seromedises-PoliTo/Float-Ram-main/Wiki_images/TestingApparatus_CAD.png

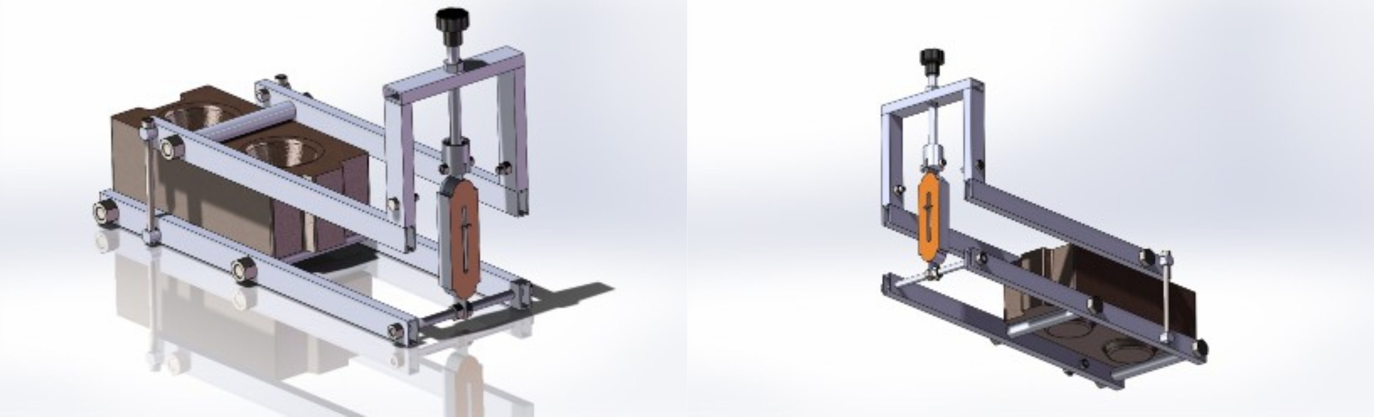
Wiki_images/TestingApparatus_CAD.png
