seromedises-PoliTo/Float-Ram-main/Wiki_images/TestingApparatus.png

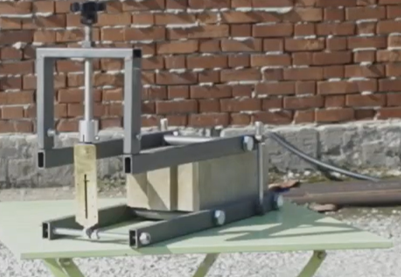
Wiki_images/TestingApparatus.png
