seromedises-PoliTo/Float-Ram-main/README.md

# Float-Ram

Float-Ram is an open-source, cost-effective, and manually operated press designed to create compressed earth block (CEB) for building construction.
