seromedises-PoliTo/Float-Ram-main/Wiki_images/BloccoMattone.png

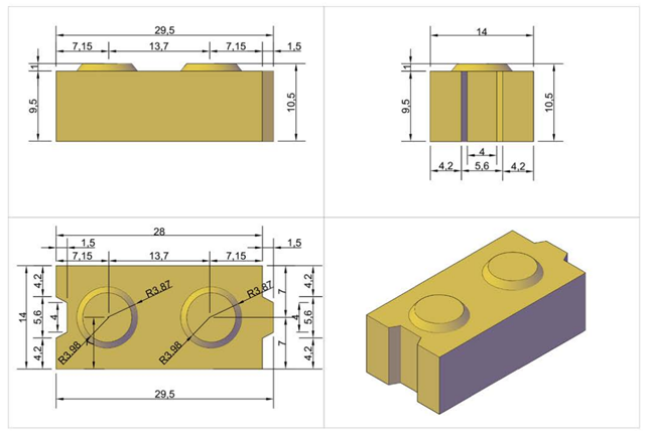
Wiki_images/BloccoMattone.png
