seromedises-PoliTo/Float-Ram-main/Wiki_images/FloatRam_CAD&Prototype.png

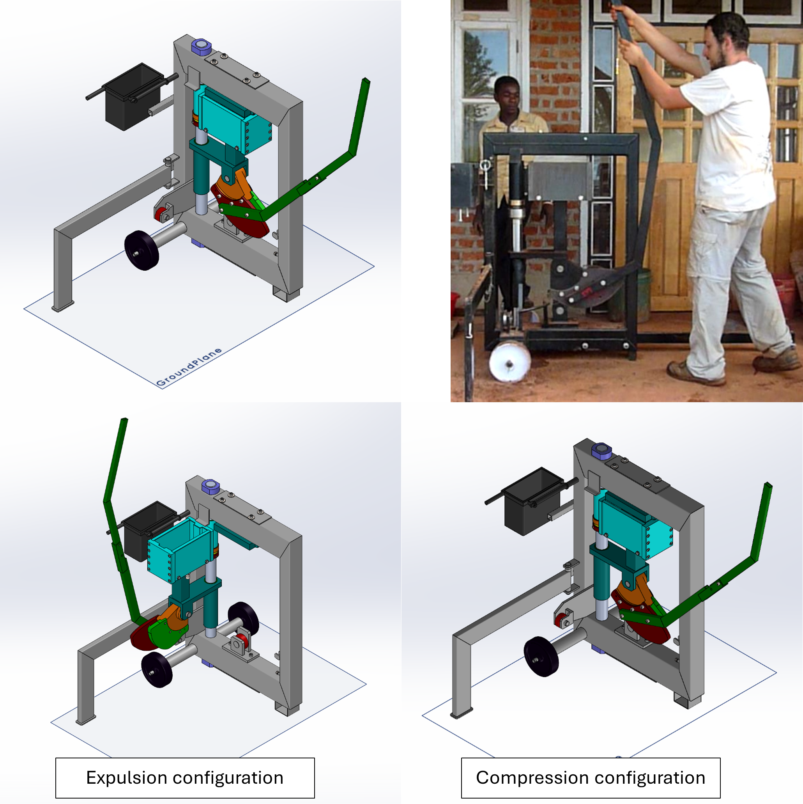
Wiki_images/FloatRam_CAD&Prototype.png
