seromedises-PoliTo/Float-Ram-main/Wiki_images/FloatRam_FloatingMold.png

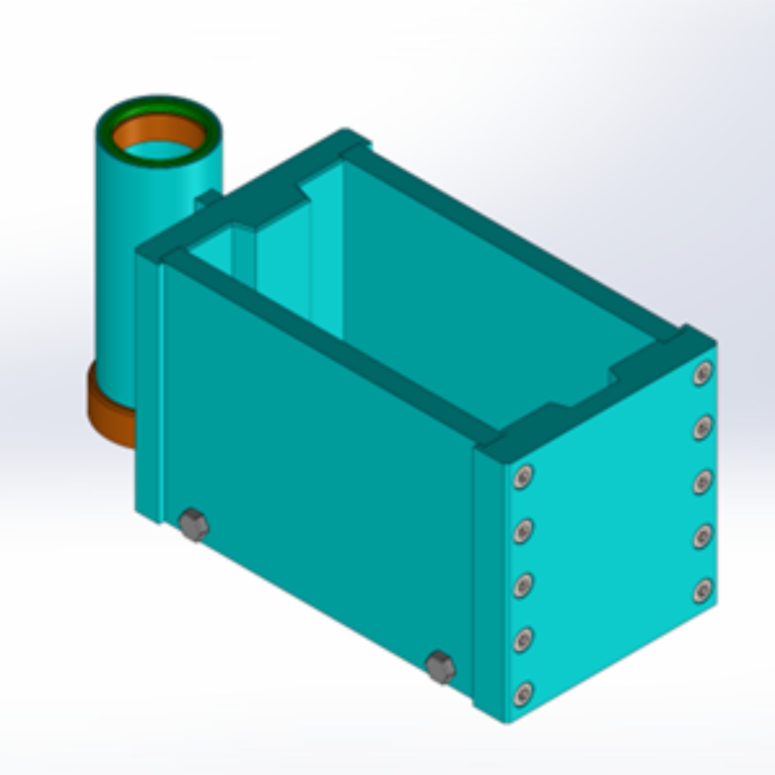
Wiki_images/FloatRam_FloatingMold.png
