seromedises-PoliTo/Float-Ram-main/Wiki_images/FloatRam_FoldedPrototype.png.jpg

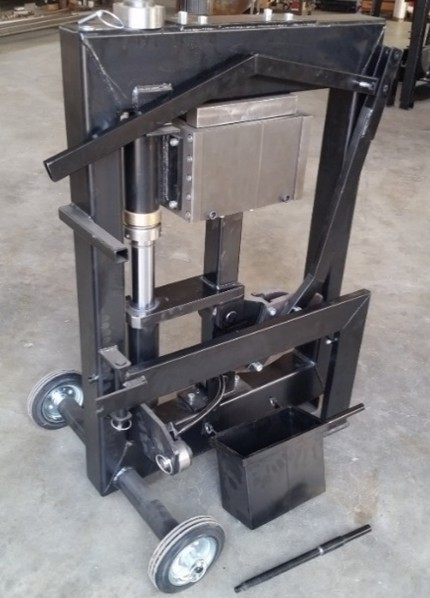
Wiki_images/FloatRam_FoldedPrototype.png.jpg
