seromedises-PoliTo/Float-Ram-main/Wiki_images/FloatRam_Frame.png

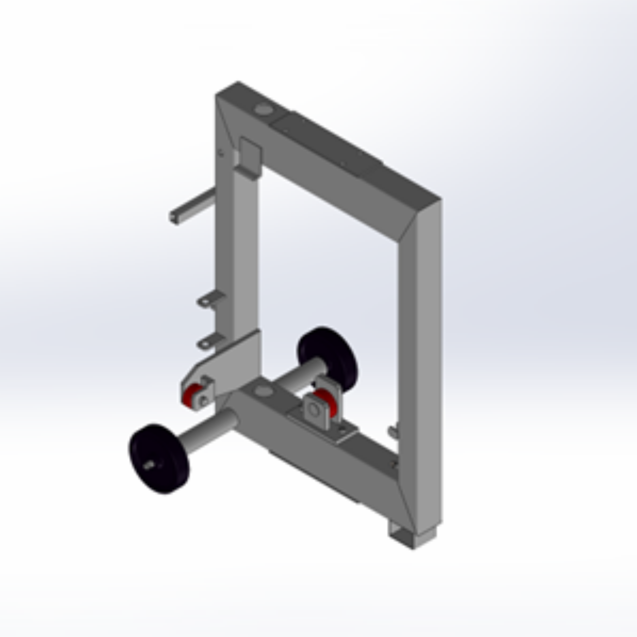
Wiki_images/FloatRam_Frame.png
