seromedises-PoliTo/Float-Ram-main/Wiki_images/FloatRam_LateralFoot.png

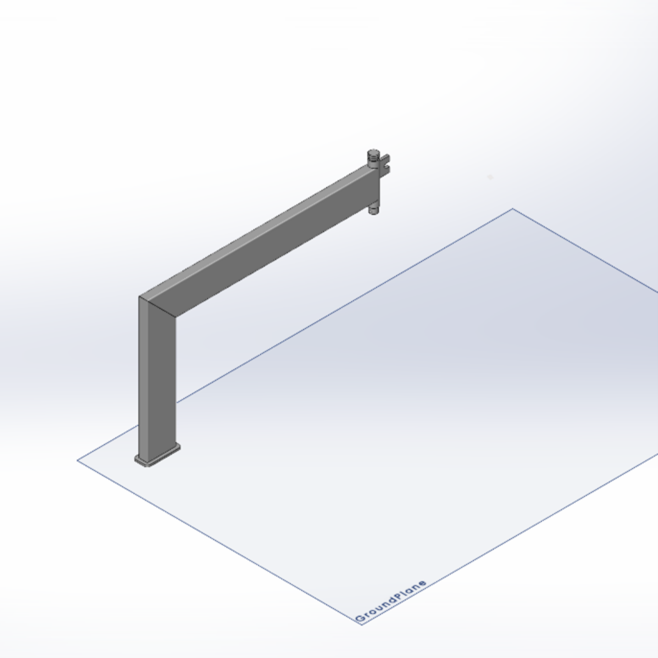
Wiki_images/FloatRam_LateralFoot.png
