seromedises-PoliTo/Float-Ram-main/Wiki_images/FloatRam_Lever&Cams.png

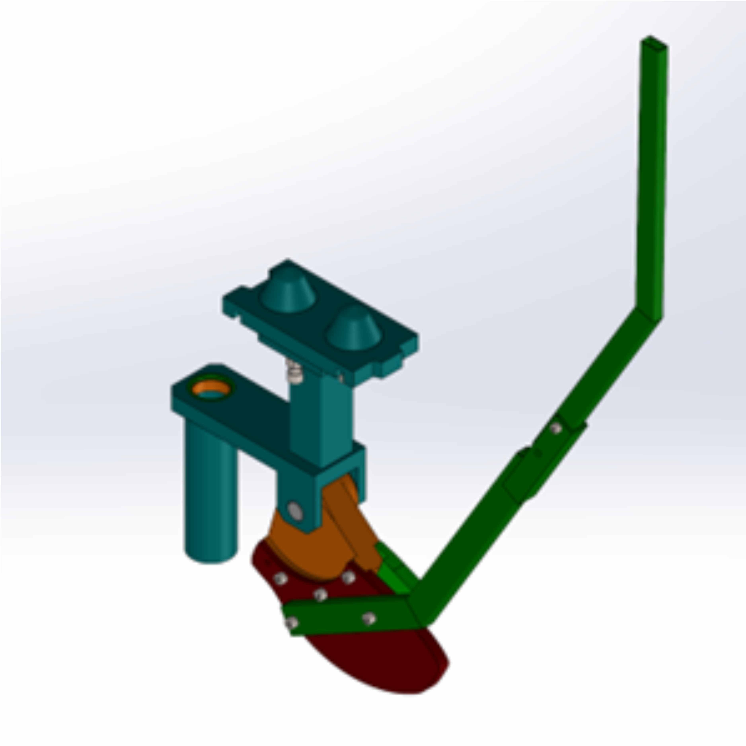
Wiki_images/FloatRam_Lever&Cams.png
