seromedises-PoliTo/Float-Ram-main/Wiki_images/FloatRam_MeteringBox.png

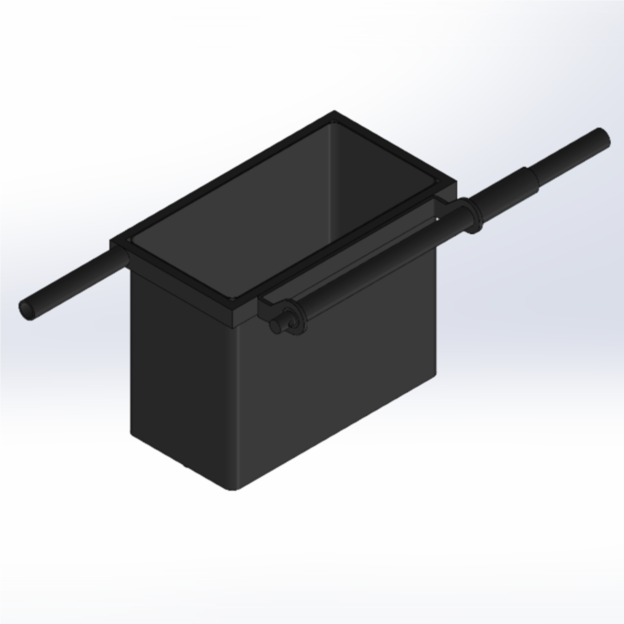
Wiki_images/FloatRam_MeteringBox.png
