seromedises-PoliTo/Float-Ram-main/Wiki_images/FloatRam_Shaft.png

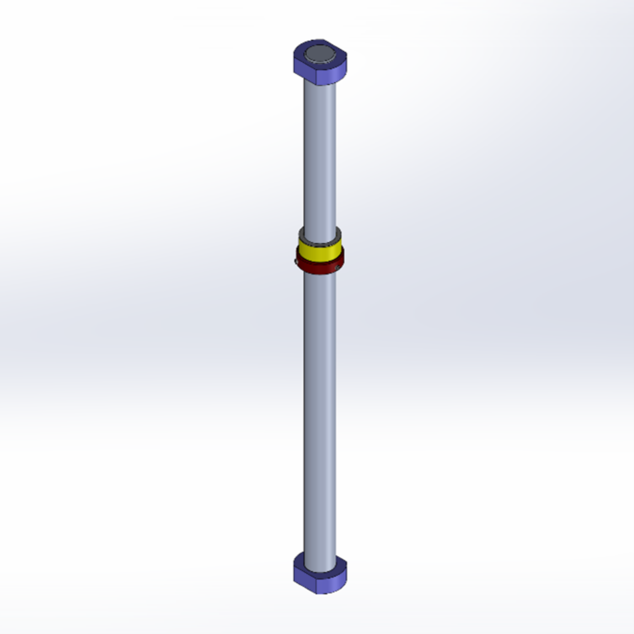
Wiki_images/FloatRam_Shaft.png
