seromedises-PoliTo/Float-Ram-main/ComponentsList.xlsx

Part Name | Part of the Sub-Assembly | Description | Suggested Manufacturing Process | Material | Quantity | Commercial or Custom | Notes
FrameLowerHorizontalProfile | Assembly_2nd_Frame | Frame bottom part | Metallic carpentry | Structural steel | 1 | Custom
FrameUpperHorizontalProfile | Assembly_2nd_Frame | Frame upper part | Metallic carpentry | Structural steel | 1 | Custom
FrameVerticalBackProfile | Assembly_2nd_Frame | Fame vertical back part | Metallic carpentry | Structural steel | 1 | Custom
FrameVerticalFrontProfile | Assembly_2nd_Frame | Frame vertical front part | Metallic carpentry | Structural steel | 1 | Custom
PressRollerSupport | Assembly_2nd_Frame | Support for the press roller | Metallic carpentry | Structural steel | 1 | Custom
Screw_M14x200 | Assembly_2nd_Frame | Screw that holds the press roller support | - | - | 2 | Commercial
Nut_M14 | Assembly_2nd_Frame | Nut to secure the screws for the press roller support | - | - | 2 | Commercial
Wheel | Assembly_2nd_Frame | Machine's wheel | - | Solid rubber + steel | 2 | Commercial | External diameter = 200mm; Shaft diameter = 20mm; Width = 50mm
WheelAxis | Assembly_2nd_Frame | Shaft of the wheel | Turning | Steel | 2 | Custom | C40 or 38NiCrMo4
ExpulsionRollerShaft | Assembly_2nd_Frame | Shaft of the expulsion roller | Turning | Steel | 1 | Custom | C40 or 38NiCrMo4
SKF_SupportRoller_NUTR_3072 | Assembly_2nd_Frame | Expulsion roller | - | - | 1 | Commercial
PressRollerShaft | Assembly_2nd_Frame | Shaft of the press roller | Turning | Steel | 1 | Custom | C40 or 38NiCrMo4
SKF_SupportRoller_NUTR_4090_A | Assembly_2nd_Frame | Press roller | - | - | 1 | Commercial
LeverLock | Assembly_2nd_Frame | Part to lock the lever in horizontal position to be used as a handle | Metallic carpentry | Steel | 1 | Custom | C40 or 38NiCrMo4
LeverLockSupport | Assembly_2nd_Frame | Part to secure the lever lock to the frame | Milling | Steel | 2 | Custom | C40 or 38NiCrMo4
ISO_4762_M8x30_screw | Assembly_2nd_Frame | Screw to secure the lever lock support to the frame | - | - | 4 | Commercial
LateralFootLockingLever | Assembly_2nd_Frame | Part to lock the lateral foot in the folded position | Sheet cutting or milling | Steel | 1 | Custom | C40 or 38NiCrMo4
DIN_EN_ISO_7040_M10_Prevailing_torque_nut | Assembly_2nd_Frame | Nut to secure the lateral foot locking lever to the frame | - | - | 1 | Commercial
Shaft | Assembly_2nd_Shaft | Cylindrical pair main shaft | Turning | Special steel | 1 | Custom | Ground and chrome-plated special steel
ShaftRingNut | Assembly_2nd_Shaft | Ring nut to secure the shaft to the frame | Turning | Inox | 2 | Custom | AISI304
ShaftAxialBlock | Assembly_2nd_Shaft | Part fixed to the shaft that support the spring | Turning | Inox | 1 | Custom | AISI304
Spring | Assembly_2nd_Shaft | Spring that supports the floating mold | - | Inox for springs | 1 | Commercial | Wire diameter = 8mm; Mean spring diameter = 72mm; External diameter = 80mm; Internal diameter = 64mm; Minimum loaded spring length = 30mm; Unloaded spring length = 75mm; Four active coils and one non-active and machiend coil at each end
SpringWasher | Assembly_2nd_Shaft | Washer to let the bushing rotate over the spring | Turning | Steel | 1 | Custom | C40 or 38NiCrMo4
ISO_4029_M10x30_set_nut | Assembly_2nd_Shaft | Set nut that secure the shaft axial block to the shaft | - | - | 3 | Commercial
FloatingMoldGuide | Assembly_2nd_FloatingMold | Part that guide the floating mold on the shaft | Turning + Metallic carpentry | Structural steel | 1 | Custom
Gasket | Assembly_2nd_FloatingMold | Typical gasket for pistons | - | - | 1 | Commercial | Intenal diameter = 60mm; External diameter = 74mm; Thickness = 8mm;
AxialRadialBushing | Assembly_2nd_FloatingMold | Axial-radial bushing that supports the floating mold guide | Turning | Bronze | 1 | Custom
RadialBushing | Assembly_2nd_FloatingMold | Radial bushing that supports the floating mold guide | Turining | Bronze | 1 | Custom
FloatingMoldBackPlate | Assembly_2nd_FloatingMold | Floating mold plate next to the shaft | Milling | Special steel | 1 | Custom | Carburized and nitrided special steel
FloatingMoldFrontPlate | Assembly_2nd_FloatingMold | Floating mold plate next to the user | Milling | Special steel | 1 | Custom | Carburized and nitrided special steel
FloatingMoldLateralPlate | Assembly_2nd_FloatingMold | Floating mold side plate | Milling | Special steel | 1 | Custom | Carburized and nitrided special steel
FloatingMoldLateralPlate | Assembly_2nd_FloatingMold | Floating mold side plate | Milling | Special steel | 1 | Custom | Carburized and nitrided special steel
ISO_8734_8x20_A_parallel_pin | Assembly_2nd_FloatingMold | Locating pin to install the mold back plate to the mold guide | - | - | 2 | Commercial
ISO_4762_M10x25_screw | Assembly_2nd_FloatingMold | Socket head cap screw to mount the floating mold | - | - | 24 | Commercial
FloatingMoldBottomScrew | Assembly_2nd_FloatingMold | Screw to lock the mold bottom plate inside the mold | Turning | Steel | 4 | Custom | C40 or 38NiCrMo4
CamFollowerMechGuide | Assembly_2nd_CamFolowerMech | Part to guide the cam assemby on the shaft | Metallic carpentry | Structural steel | 1 | Custom
RadialBushing | Assembly_2nd_CamFolowerMech | Radial bushing that supports the cam follower guide | Turining | Bronze | 2 | Custom
Gasket | Assembly_2nd_CamFolowerMech | Typical gasket for pistons | - | - | 2 | Commercial | Intenal diameter = 60mm; External diameter = 74mm; Thickness = 8mm;
CamFollowerMechShaft | Assembly_2nd_CamFolowerMech | Cam follower shaft | Turning | Steel | 1 | Custom | C40 or 38NiCrMo4
CamFollowerMechHolder | Assembly_2nd_CamFolowerMech | Part that connects the cam profiles to the cam shaft | Milling | Steel | 1 | Custom | C40 or 38NiCrMo4
SKF_SupportRoller_NUTR_35A | Assembly_2nd_CamFolowerMech | Commercial bearing used in the cam revolute joint | - | - | 2 | Commercial
CamFollowerMechBearingSpacer | Assembly_2nd_CamFolowerMech | Spacer to locate the inner part of the bearings | - | Bronze | 1 | Custom
ExpulsionCam | Assembly_2nd_CamFolowerMech | Cam profile to guide the brick expulsion | Water-jet cutting + contour milling using the parallel pin as reference | Special steel | 1 | Custom | Carburized and nitrided special steel
PressCam | Assembly_2nd_CamFolowerMech | Cam profile to guide the brick pressing | Water-jet cutting + contour milling using the parallel pin as reference | Special steel | 1 | Custom | Carburized and nitrided special steel
Lever | Assembly_2nd_CamFolowerMech | Input lever | Metallic carpentry | Structural steel | 1 | Custom | The shaft to connect the extension must be welded during the assembly
LevelExtension | Assembly_2nd_CamFolowerMech | Input lever extension (it is foldable for packaging) | Metallic carpentry | Structural steel | 1 | Custom
ISO_4762_M12x45_screw | Assembly_2nd_CamFolowerMech | Screw to secure the lever to the cam assmebly | - | - | 2 | Commercial
ISO_4762_M12x70_screw | Assembly_2nd_CamFolowerMech | Screw to secure the cam profiles to the cam holder | - | - | 3 | Commercial
ISO_4762_M10x25_screw | Assembly_2nd_CamFolowerMech | Screw to secure the mold lower plate to the cam follower guide | - | - | 4 | Commercial
ISO_4762_M16x45_screw | Assembly_2nd_CamFolowerMech | Screw to adjust the position and orientation of the lower plate | - | - | 4 | Commercial
ISO_4034_M16_nut | Assembly_2nd_CamFolowerMech | Nut to lock the adjusting screws after the regulation has been done | - | - | 4 | Commercial
ISO_4762_M10x35_screw | Assembly_2nd_CamFolowerMech | Screw to secure the lever extension in the unfolded position | - | - | 1 | Commercial
MoldLowerPlate | Assembly_3rd_MoldLowerPlate | Mold lower plate | Milling | Special steel | 1 | Custom | Carburized and nitrided special steel
MoldLowerPlateInsert | Assembly_3rd_MoldLowerPlate | Mold lower plate insert | Turning | Special steel | 2 | Custom | Carburized and nitrided special steel
ISO_4762_M10x30_screw | Assembly_3rd_MoldLowerPlate | Screw to secure the mold insert to the lower plate | - | - | 2 | Commercial
MeteringBox | Assembly_2nd_MeteringBox | Main body of the metering box | Metallic carpentry | Structural steel | 1 | Custom
MeteringBoxAdjustingScrew | Assembly_2nd_MeteringBox | Custom screw to adjust the metering box volume | Turning | Inox | 2 | Custom | AISI304
MeteringBoxHolder | Assembly_2nd_MeteringBox | Part welded to the main body that the user holds | Metallic carpentry | Structural steel | 1 | Custom
MeteringBoxJoint | Assembly_2nd_MeteringBox | Part welded to the holder to connect to the revolute joint | Metallic carpentry (sheet cutting and folding) | Structural steel | 1 | Custom
MeteringBoxLowerPlate | Assembly_2nd_MeteringBox | Bottom of the metering box | Metallic carpentry | Structural steel | 1 | Custom
MeteringBoxShaft | Assembly_2nd_MeteringBox | Shaft of the metering box revolute joint | Turning | Structural steel | 1 | Custom
MoldUpperPlate | - | Mold upper plate | Milling | Special steel | 1 | Custom | Carburized and nitrided special steel
LateralFoot | - | Lateral foot for stability during expulsion | Metallic carpentry | Structural steel | 1 | Custom
LateralFootAxis | - | Lateral foot axis to fold the lateral foot for packaging | Turning | Steel | 1 | Custom | C40 or 38NiCrMo4
M12x180_screw | - | Screw to secure the mold upper plate to the frame | - | - | 4 | Commercial
DIN_9021_M12_washer | - | Washer for the screw to secure the mold upper plate | - | - | 4 | Commercial
ISO_4762_M10x25_screw | - | Screw to secure the metering box axis to the frame | - | - | 1 | Commercial
SplintPin | - | Splint pins to axial lock of the revolute joint shafts | - | - | 7 | Commercial | Not added in CAD. For diameters: 14mm, 20mm (2x), 24mm, 26mm, 32mm, 36mm
