seromedises-PoliTo/Float-Ram-main/Float_Ram_SW2024/SKF_SupportRoller_NUTR_3072.SLDASM

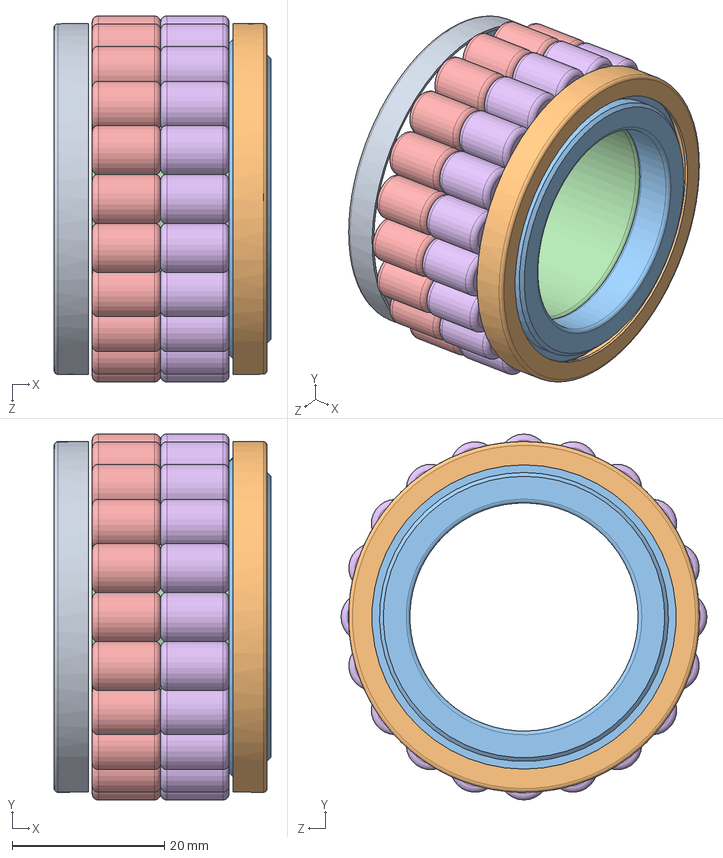
[picture p12: CAD file, 2026-06-23]
Float_Ram_SW2024/SKF_SupportRoller_NUTR_3072.SLDASM
28.5 x 48.1 x 48.1 mm
SKF_SupportRoller_NUTR_3072_0_02
SKF_SupportRoller_NUTR_3072_0_03
SKF_SupportRoller_NUTR_3072_0_04
SKF_SupportRoller_NUTR_3072_0_05
SKF_SupportRoller_NUTR_3072_0_07
SKF_SupportRoller_NUTR_3072_0_08
