seromedises-PoliTo/Float-Ram-main/Float_Ram_SW2024/Assembly_3rd_MoldLowerPlate.SLDASM

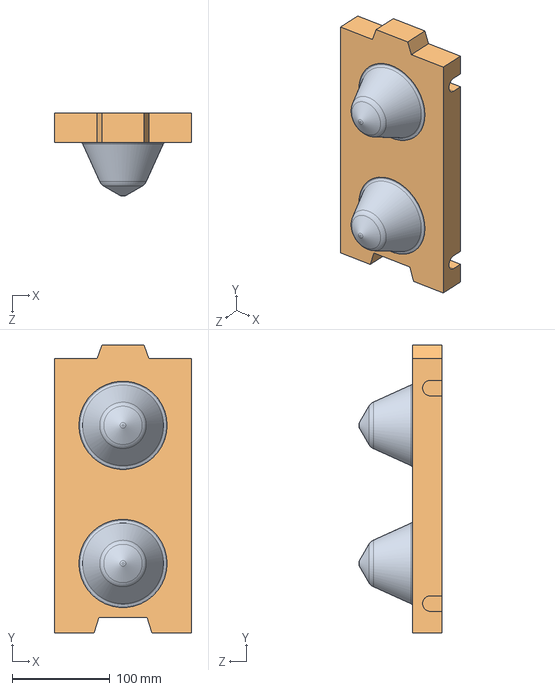
[picture p13: CAD file, 2026-06-23]
Float_Ram_SW2024/Assembly_3rd_MoldLowerPlate.SLDASM
140.0 x 294.0 x 85.0 mm
MoldLowerPlate
MoldLowerPlateInsert x 2
