seromedises-PoliTo/Float-Ram-main/Float_Ram_STEP/FloatingMoldBackPlate.STEP

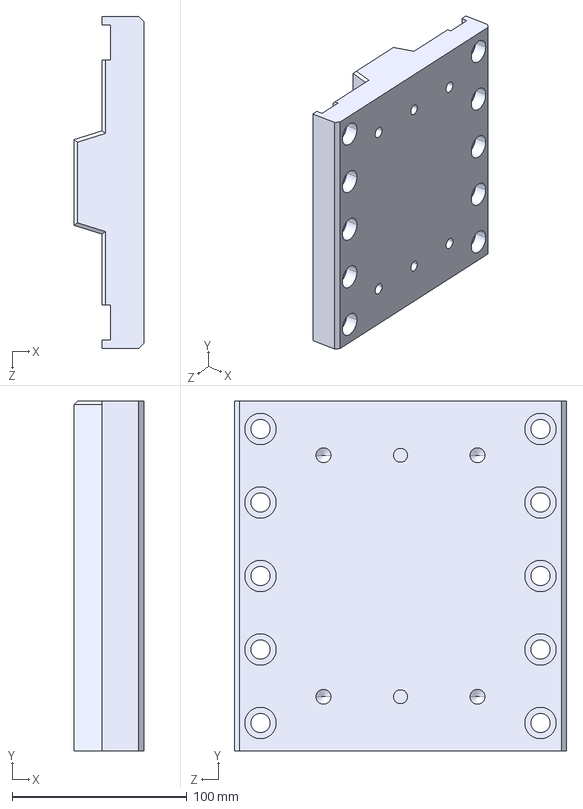
[picture p14: CAD file, 2026-06-23]
Float_Ram_STEP/FloatingMoldBackPlate.STEP
40.0 x 200.0 x 190.0 mm
