seromedises-PoliTo/Float-Ram-main/Float_Ram_SW2024/CamFollowerMechGuide.SLDPRT

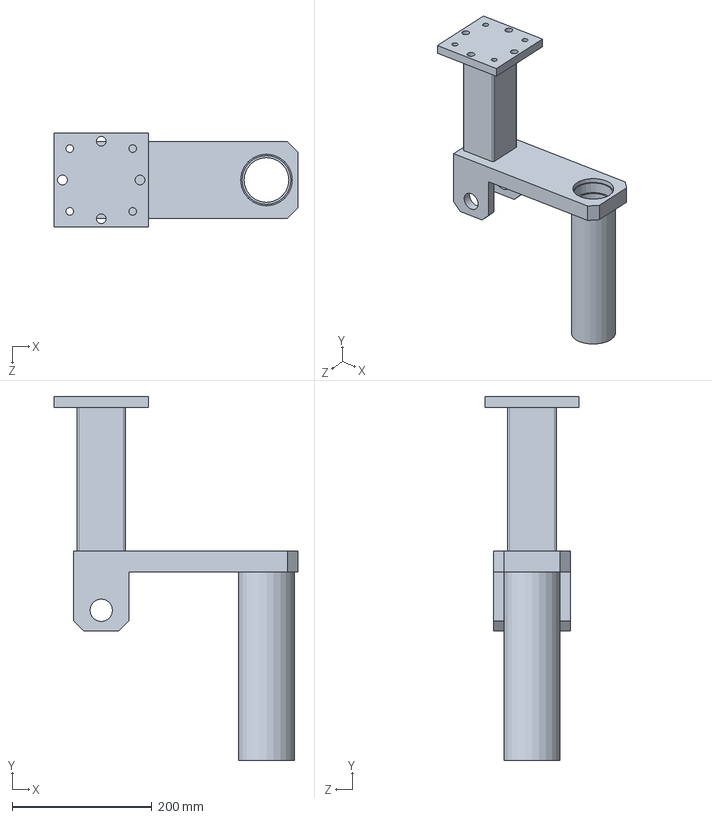
[picture p15: CAD file, 2026-06-23]
Float_Ram_SW2024/CamFollowerMechGuide.SLDPRT
349.0 x 521.0 x 135.0 mm
