seromedises-PoliTo/Float-Ram-main/Float_Ram_STEP/SKF_SupportRoller_NUTR_3072_0_07.STEP

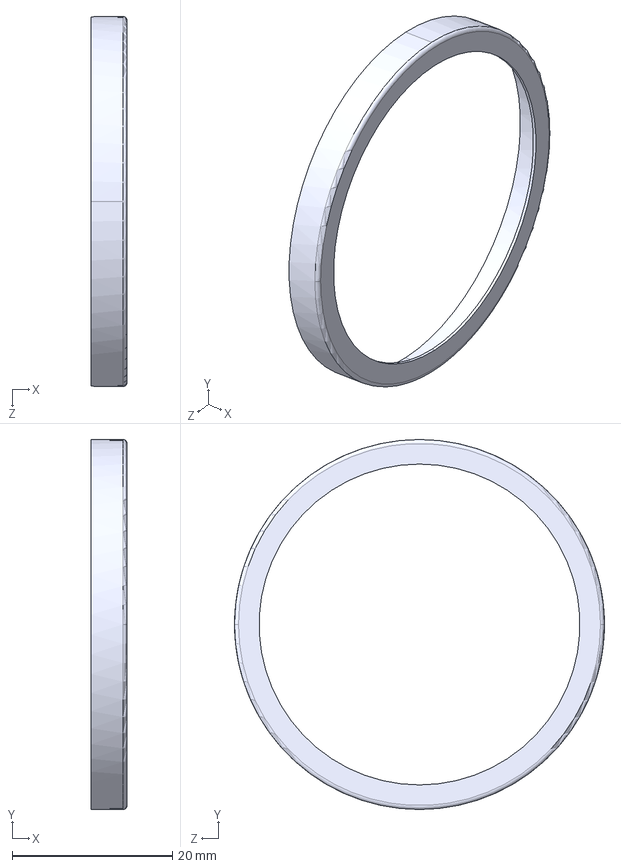
[picture p16: CAD file, 2026-06-23]
Float_Ram_STEP/SKF_SupportRoller_NUTR_3072_0_07.STEP
4.50 x 46.1 x 46.1 mm
