seromedises-PoliTo/Float-Ram-main/Float_Ram_SW2024/LevelExtension.SLDPRT

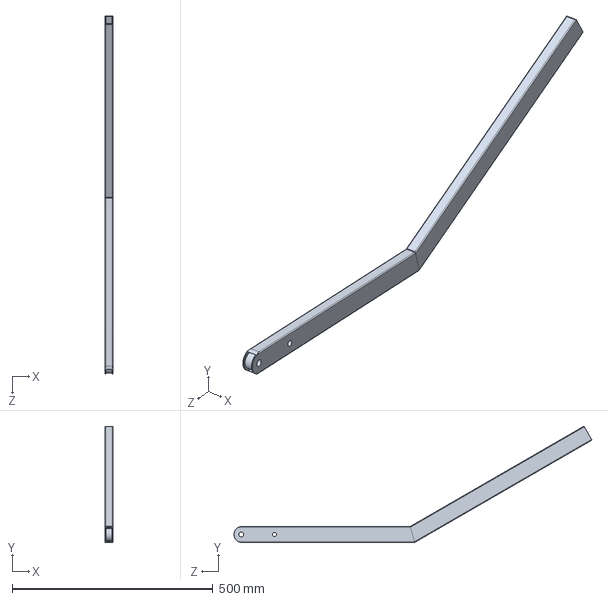
[picture p17: CAD file, 2026-06-23]
Float_Ram_SW2024/LevelExtension.SLDPRT
20.0 x 289.3 x 892.3 mm
