seromedises-PoliTo/Float-Ram-main/Float_Ram_SW2024/MoldUpperPlate.SLDPRT

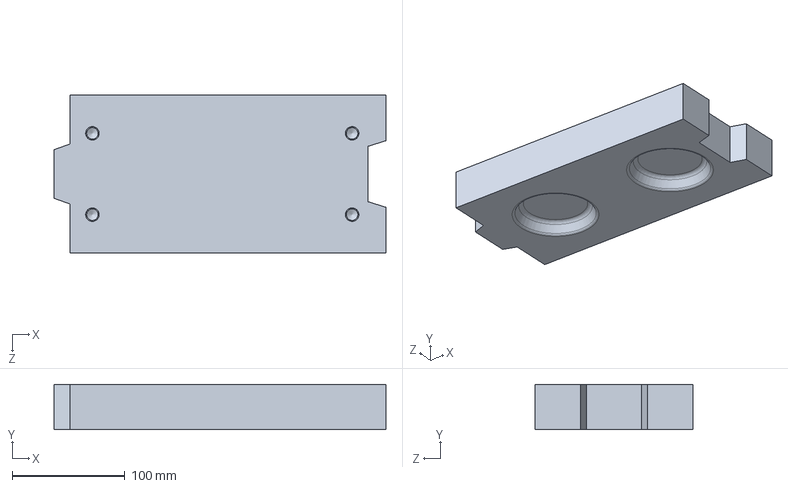
[picture p18: CAD file, 2026-06-23]
Float_Ram_SW2024/MoldUpperPlate.SLDPRT
294.0 x 40.0 x 140.0 mm
