seromedises-PoliTo/Float-Ram-main/Float_Ram_STEP/SKF_SupportRoller_NUTR_35A_0_08.STEP

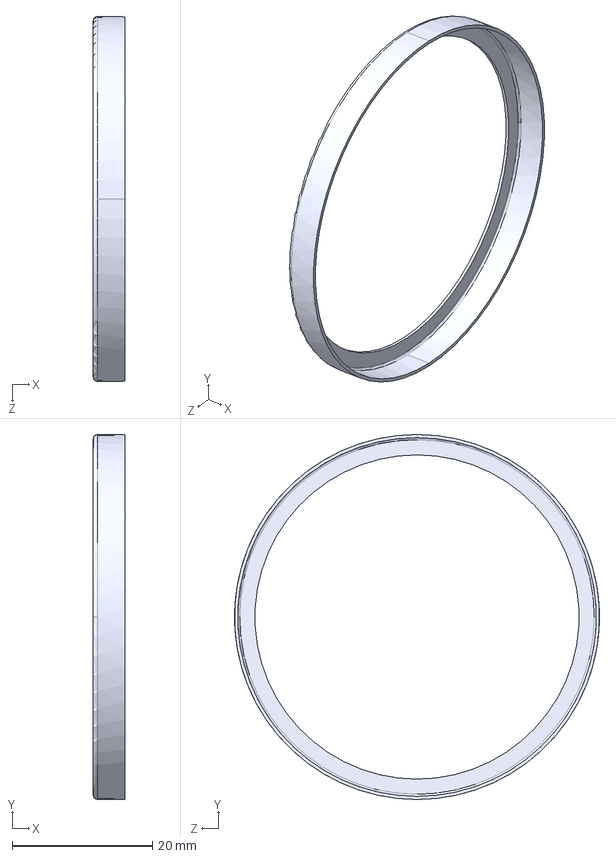
[picture p19: CAD file, 2026-06-23]
Float_Ram_STEP/SKF_SupportRoller_NUTR_35A_0_08.STEP
4.50 x 52.1 x 52.1 mm
