seromedises-PoliTo/Float-Ram-main/Float_Ram_STEP/MeteringBoxLowerPlate.STEP

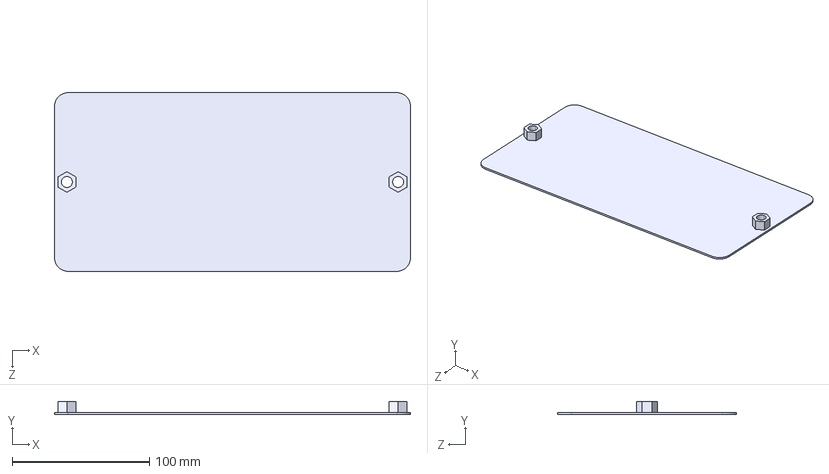
[picture p20: CAD file, 2026-06-23]
Float_Ram_STEP/MeteringBoxLowerPlate.STEP
259.0 x 9.50 x 130.0 mm
