seromedises-PoliTo/Float-Ram-main/Float_Ram_SW2024/SKF_SupportRoller_NUTR_35A_0_04.SLDPRT

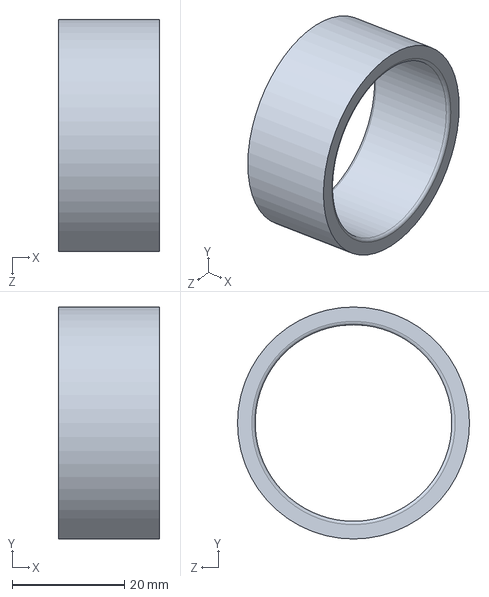
[picture p21: CAD file, 2026-06-23]
Float_Ram_SW2024/SKF_SupportRoller_NUTR_35A_0_04.SLDPRT
18.0 x 41.3 x 41.3 mm
