seromedises-PoliTo/Float-Ram-main/Float_Ram_SW2024/LeverLock.SLDPRT

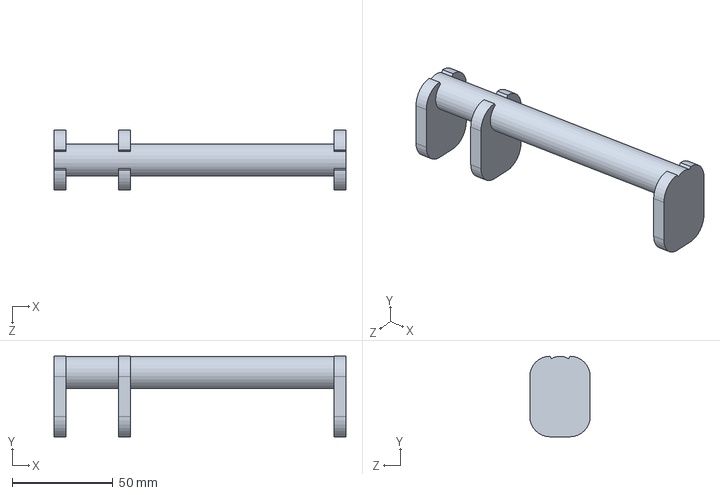
[picture p22: CAD file, 2026-06-23]
Float_Ram_SW2024/LeverLock.SLDPRT
145.0 x 40.0 x 30.0 mm
