seromedises-PoliTo/Float-Ram-main/Float_Ram_STEP/SKF_SupportRoller_NUTR_3072_0_02.STEP

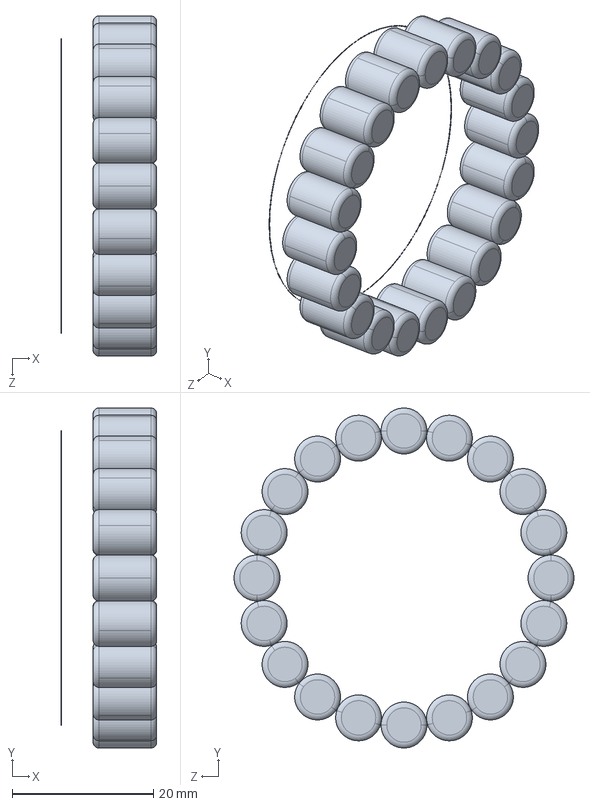
[picture p23: CAD file, 2026-06-23]
Float_Ram_STEP/SKF_SupportRoller_NUTR_3072_0_02.STEP
13.5 x 48.1 x 48.1 mm
