seromedises-PoliTo/Float-Ram-main/Float_Ram_SW2024/AxialRadialBushing.SLDPRT

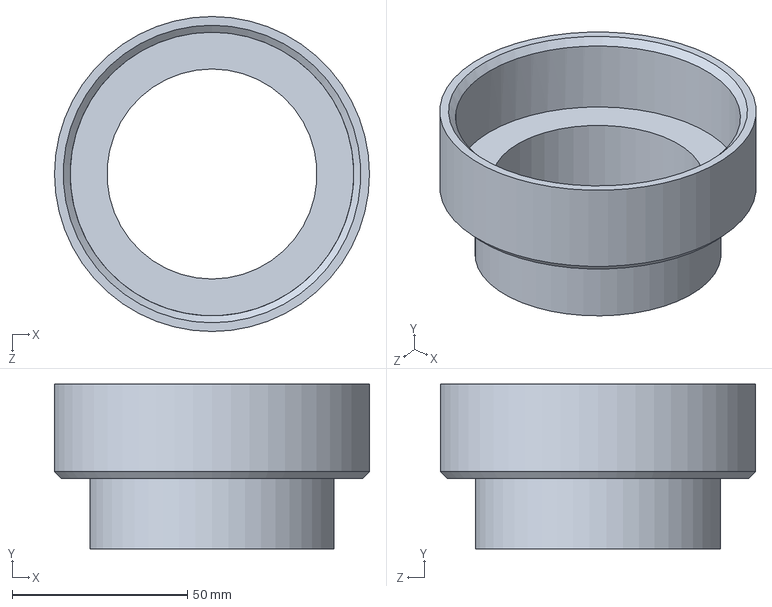
[picture p24: CAD file, 2026-06-23]
Float_Ram_SW2024/AxialRadialBushing.SLDPRT
90.0 x 47.0 x 90.0 mm
