seromedises-PoliTo/Float-Ram-main/Float_Ram_SW2024/FrameVerticalFrontProfile.SLDPRT

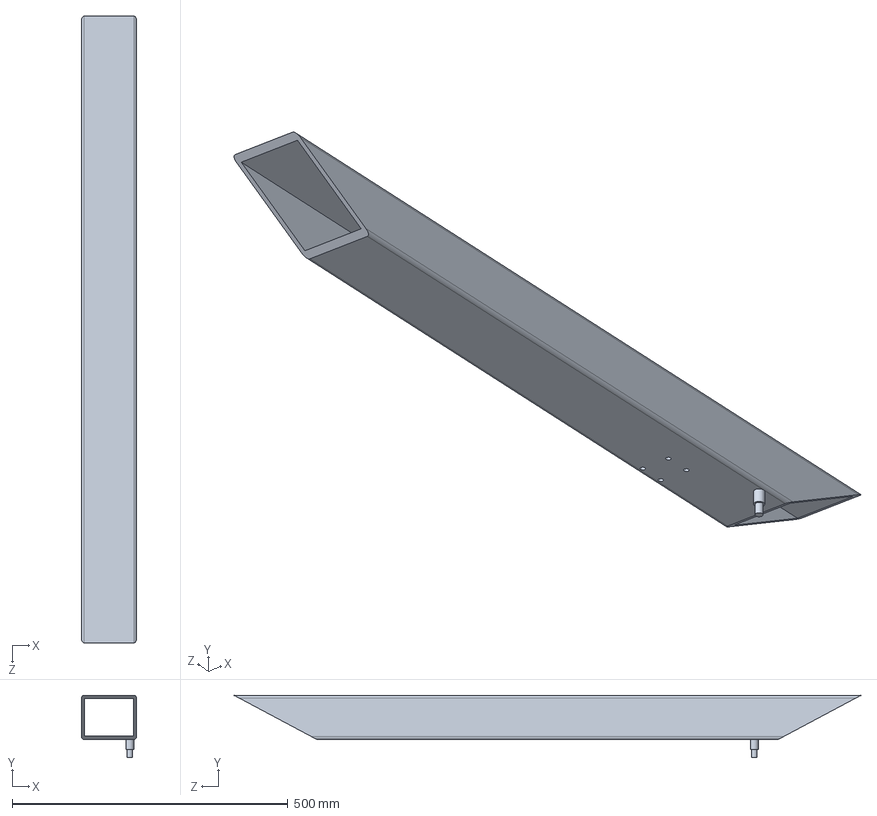
[picture p25: CAD file, 2026-06-23]
Float_Ram_SW2024/FrameVerticalFrontProfile.SLDPRT
100.0 x 113.0 x 1136.0 mm
