seromedises-PoliTo/Float-Ram-main/Float_Ram_STEP/SKF_SupportRoller_NUTR_35A_0_06.STEP

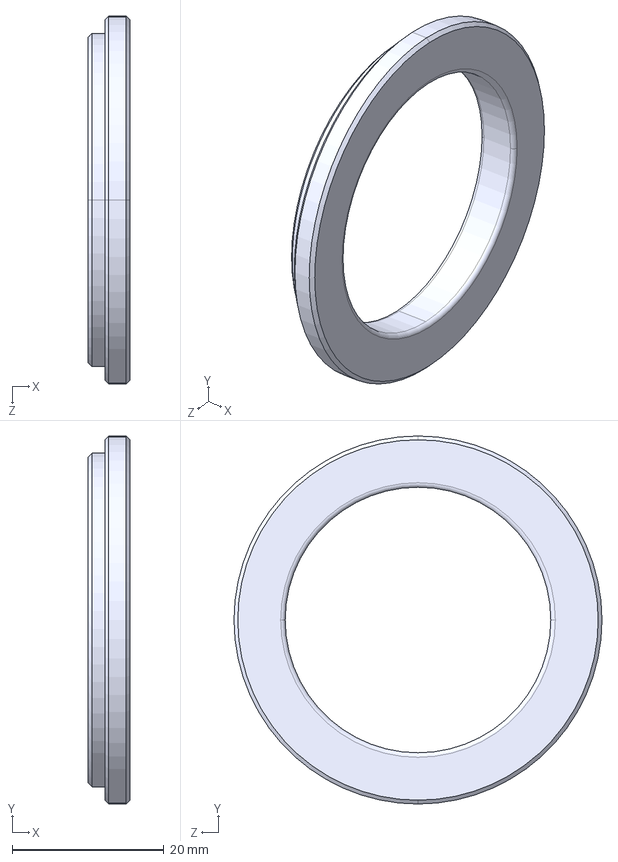
[picture p26: CAD file, 2026-06-23]
Float_Ram_STEP/SKF_SupportRoller_NUTR_35A_0_06.STEP
5.50 x 48.5 x 48.5 mm
