seromedises-PoliTo/Float-Ram-main/Float_Ram_SW2024/CamFollowerMechHolder.SLDPRT

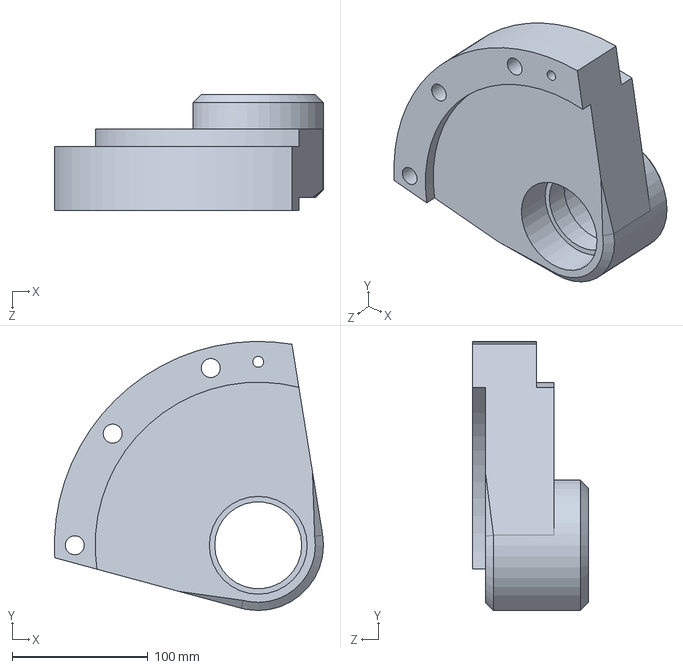
[picture p27: CAD file, 2026-06-23]
Float_Ram_SW2024/CamFollowerMechHolder.SLDPRT
197.9 x 198.0 x 85.5 mm
