seromedises-PoliTo/Float-Ram-main/Float_Ram_STEP/LateralFootAxis.STEP

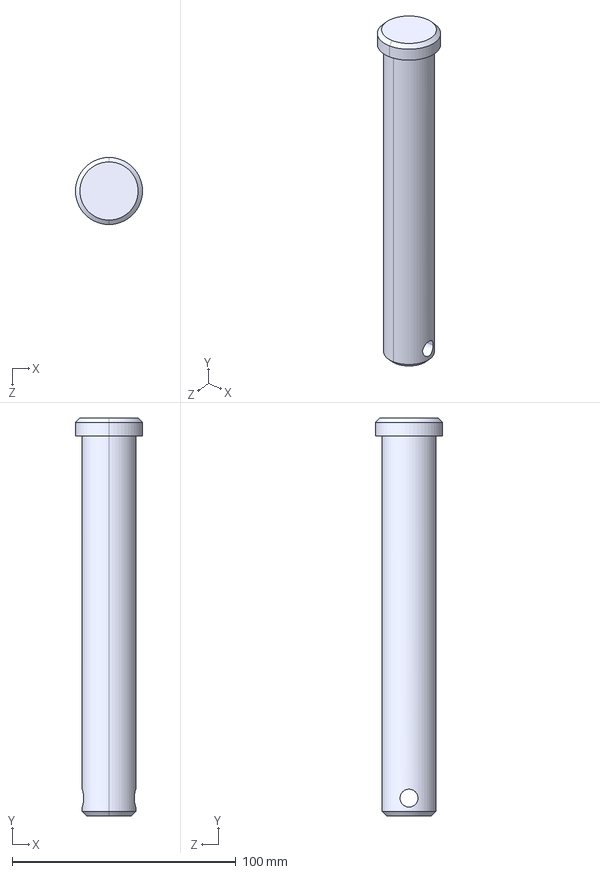
[picture p28: CAD file, 2026-06-23]
Float_Ram_STEP/LateralFootAxis.STEP
30.0 x 178.0 x 30.0 mm
