seromedises-PoliTo/Float-Ram-main/Float_Ram_STEP/SKF_SupportRoller_NUTR_35A_0_01.STEP

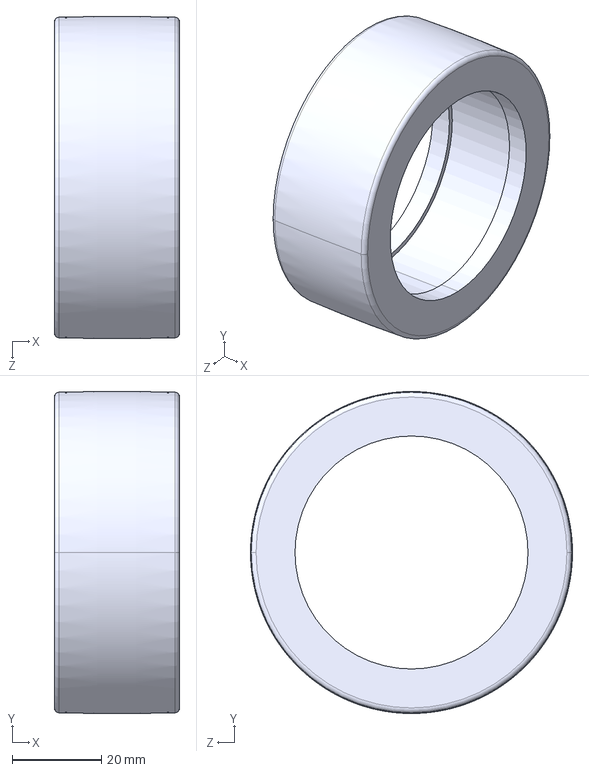
[picture p29: CAD file, 2026-06-23]
Float_Ram_STEP/SKF_SupportRoller_NUTR_35A_0_01.STEP
28.0 x 72.0 x 72.0 mm
