seromedises-PoliTo/Float-Ram-main/Float_Ram_STEP/ShaftAxialBlock.STEP

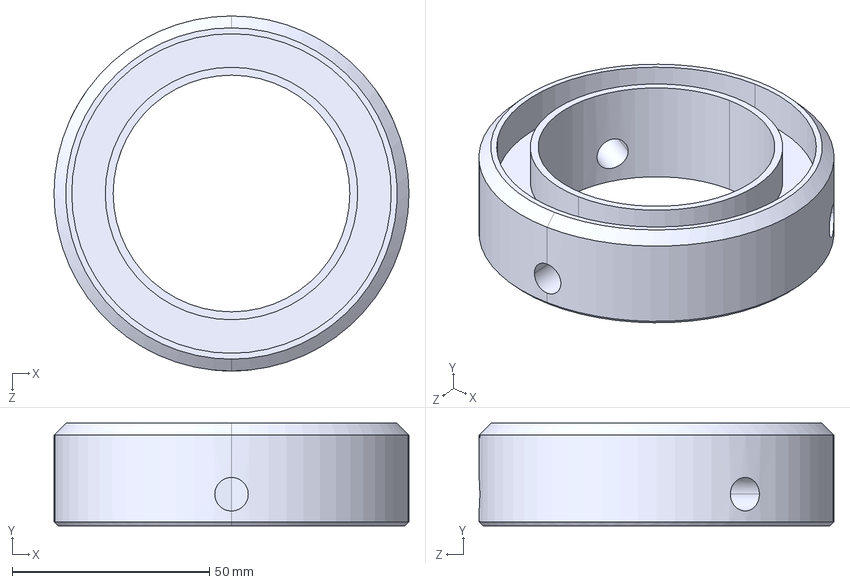
[picture p30: CAD file, 2026-06-23]
Float_Ram_STEP/ShaftAxialBlock.STEP
90.0 x 26.0 x 90.0 mm
