seromedises-PoliTo/Float-Ram-main/Float_Ram_STEP/PressRollerShaft.STEP

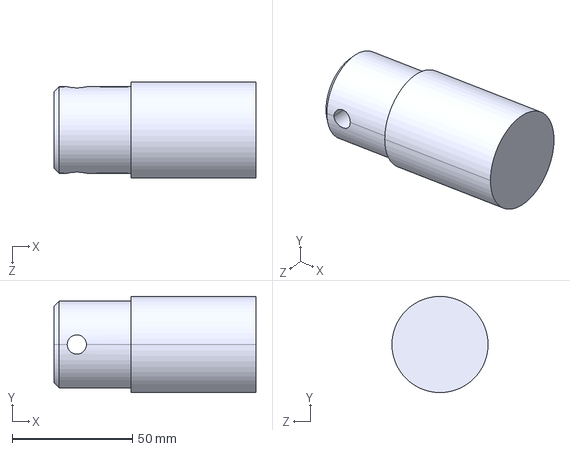
[picture p31: CAD file, 2026-06-23]
Float_Ram_STEP/PressRollerShaft.STEP
84.0 x 40.0 x 40.0 mm
