seromedises-PoliTo/Float-Ram-main/Float_Ram_SW2024/MoldInsert_M.SLDPRT

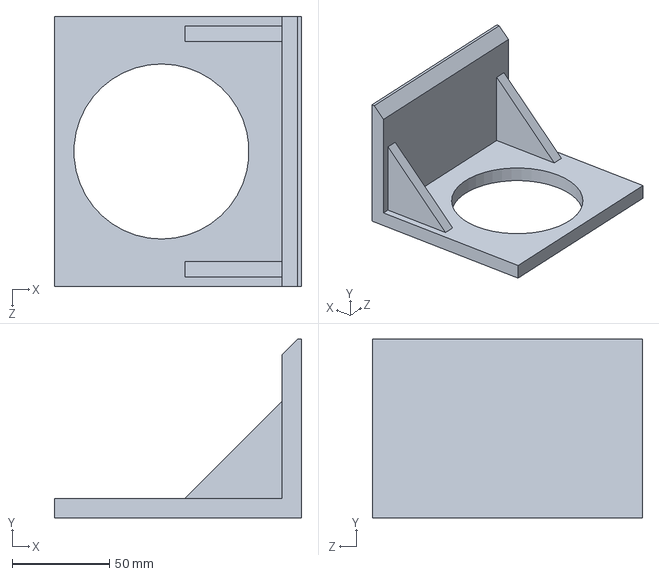
[picture p32: CAD file, 2026-06-23]
Float_Ram_SW2024/MoldInsert_M.SLDPRT
127.0 x 92.0 x 139.0 mm
