seromedises-PoliTo/Float-Ram-main/Float_Ram_SW2024/SKF_Support_roller_nutr_4090_a_0_02.SLDPRT

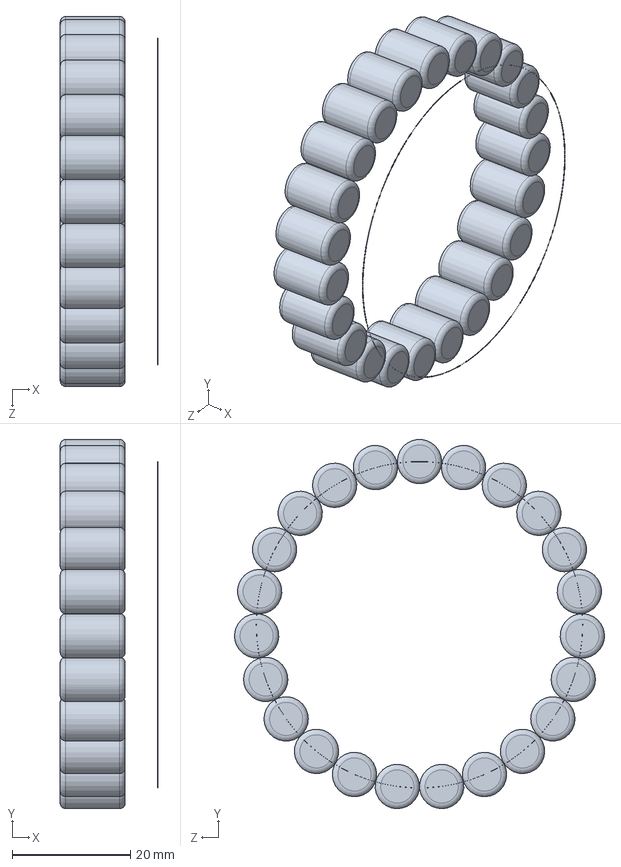
[picture p33: CAD file, 2026-06-23]
Float_Ram_SW2024/SKF_Support_roller_nutr_4090_a_0_02.SLDPRT
16.5 x 62.4 x 62.5 mm
