seromedises-PoliTo/Float-Ram-main/Float_Ram_SW2024/SKF_SupportRoller_NUTR_3072_0_04.SLDPRT

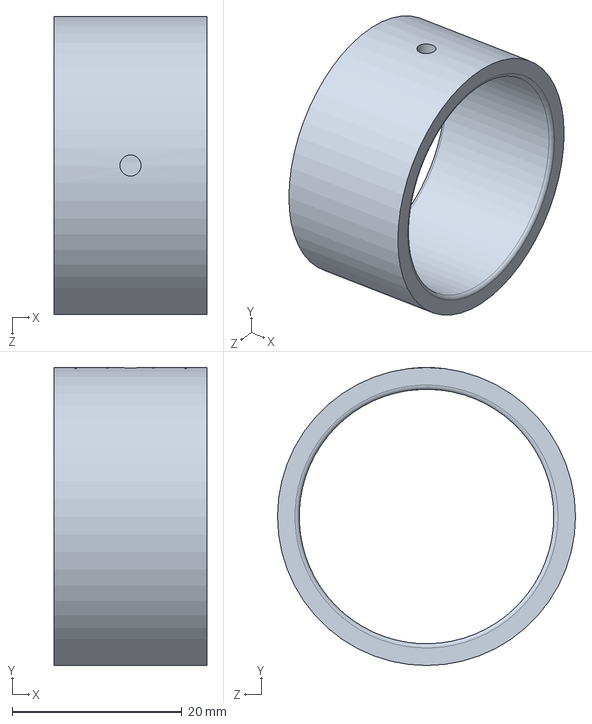
[picture p34: CAD file, 2026-06-23]
Float_Ram_SW2024/SKF_SupportRoller_NUTR_3072_0_04.SLDPRT
18.0 x 35.1 x 35.1 mm
