seromedises-PoliTo/Float-Ram-main/Float_Ram_STEP/SKF_SupportRoller_NUTR_35A_0_02.STEP

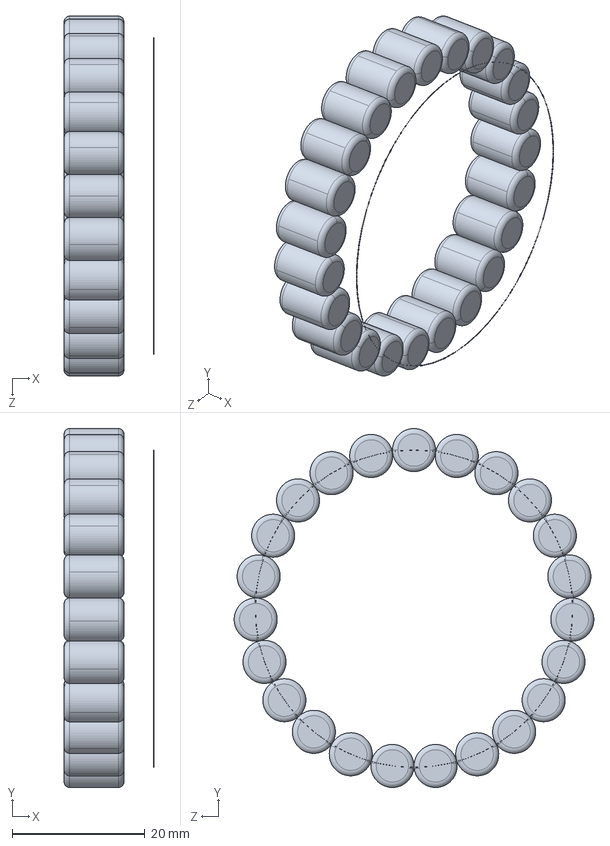
[picture p35: CAD file, 2026-06-23]
Float_Ram_STEP/SKF_SupportRoller_NUTR_35A_0_02.STEP
13.5 x 54.1 x 54.2 mm
