seromedises-PoliTo/Float-Ram-main/Float_Ram_SW2024/MoldLowerPlateInsert.SLDPRT

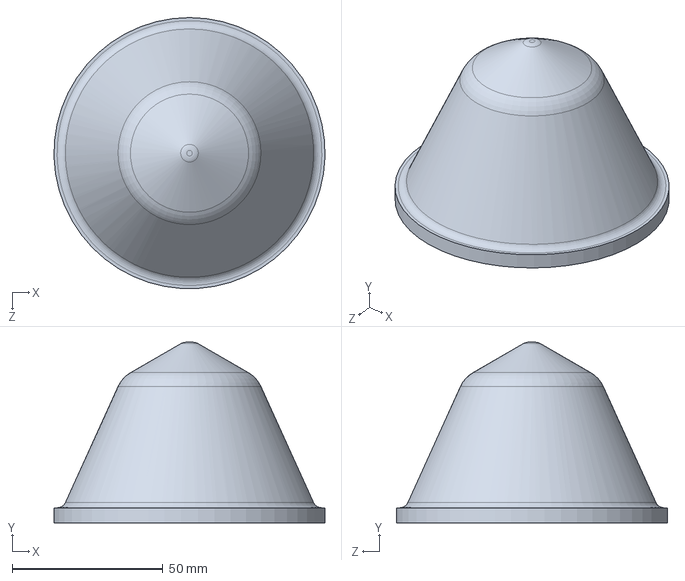
[picture p36: CAD file, 2026-06-23]
Float_Ram_SW2024/MoldLowerPlateInsert.SLDPRT
90.0 x 60.0 x 89.9 mm
