seromedises-PoliTo/Float-Ram-main/Float_Ram_STEP/LeverLockSupport.STEP

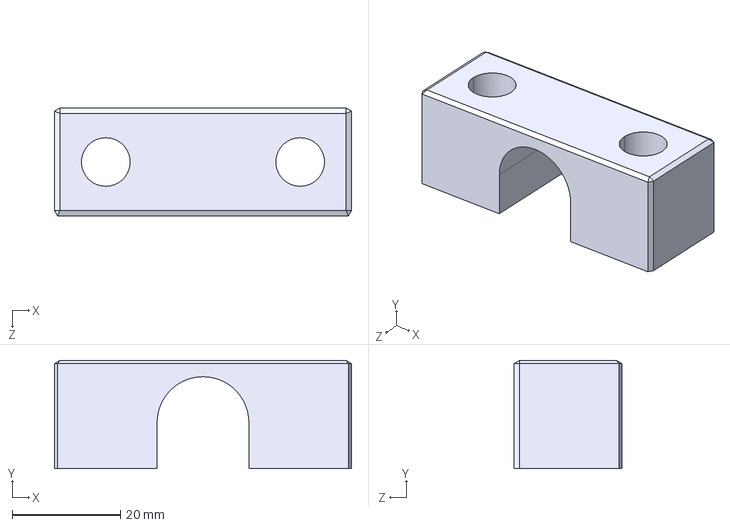
[picture p37: CAD file, 2026-06-23]
Float_Ram_STEP/LeverLockSupport.STEP
55.0 x 20.0 x 20.0 mm
