seromedises-PoliTo/Float-Ram-main/Float_Ram_SW2024/FloatingMoldBackPlate.SLDPRT

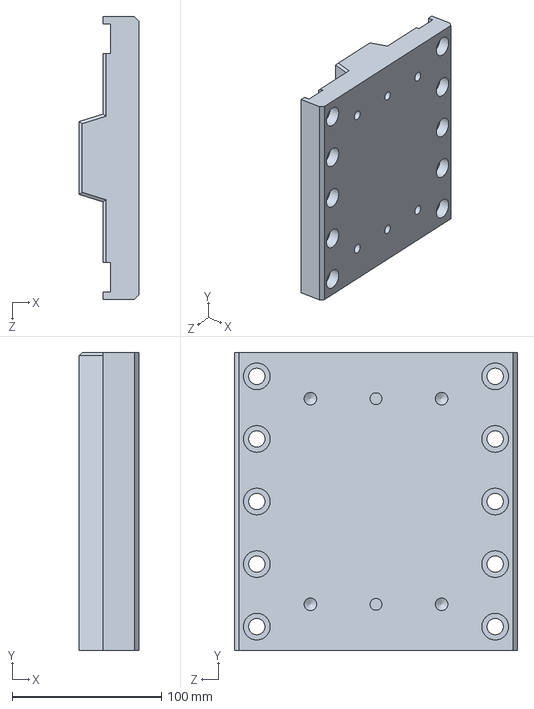
[picture p38: CAD file, 2026-06-23]
Float_Ram_SW2024/FloatingMoldBackPlate.SLDPRT
40.0 x 200.0 x 190.0 mm
