seromedises-PoliTo/Float-Ram-main/Float_Ram_STEP/SKF_SupportRoller_NUTR_3072_0_05.STEP

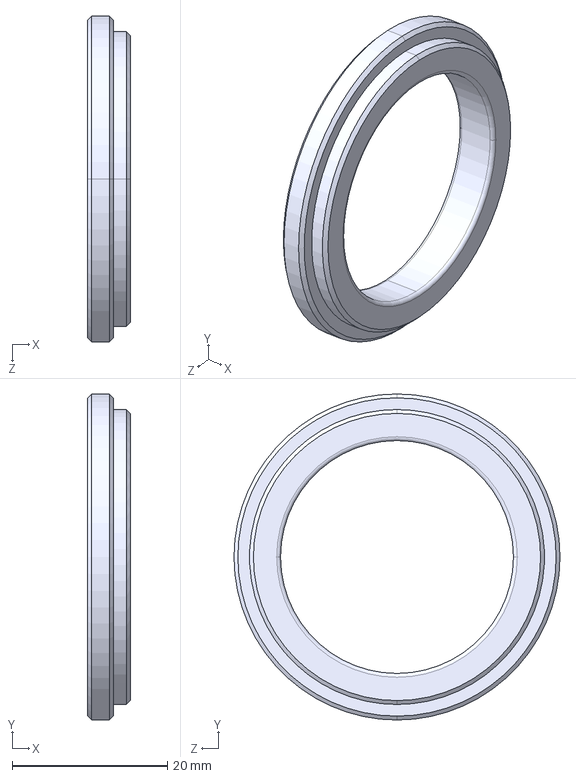
[picture p39: CAD file, 2026-06-23]
Float_Ram_STEP/SKF_SupportRoller_NUTR_3072_0_05.STEP
5.50 x 42.0 x 42.0 mm
