seromedises-PoliTo/Float-Ram-main/Float_Ram_SW2024/ShaftAxialBlock.SLDPRT

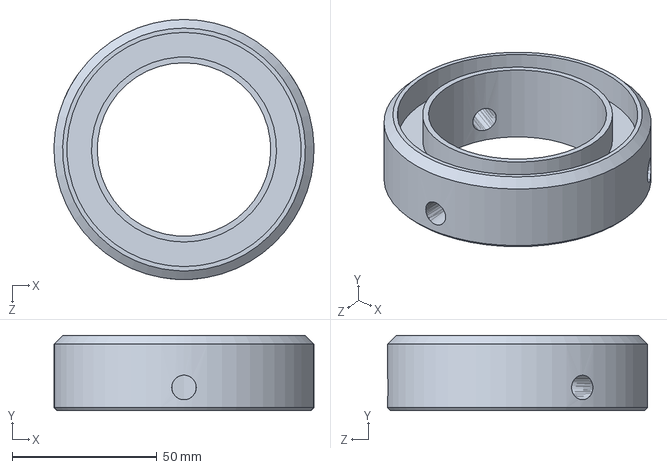
[picture p40: CAD file, 2026-06-23]
Float_Ram_SW2024/ShaftAxialBlock.SLDPRT
90.0 x 26.0 x 90.0 mm
