seromedises-PoliTo/Float-Ram-main/Float_Ram_STEP/MeteringBoxJoint.STEP

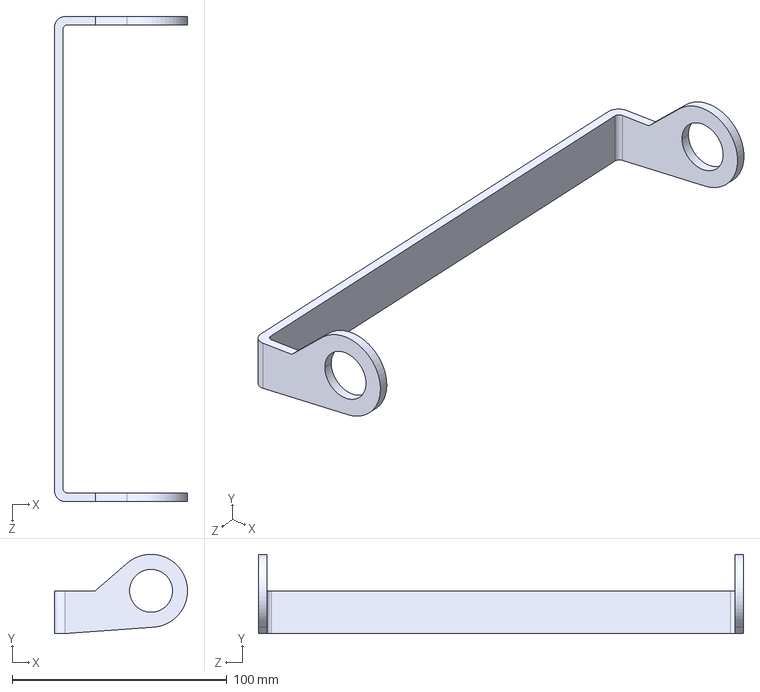
[picture p41: CAD file, 2026-06-23]
Float_Ram_STEP/MeteringBoxJoint.STEP
62.0 x 37.0 x 226.0 mm
