seromedises-PoliTo/Float-Ram-main/Float_Ram_SW2024/WheelAxis.SLDPRT

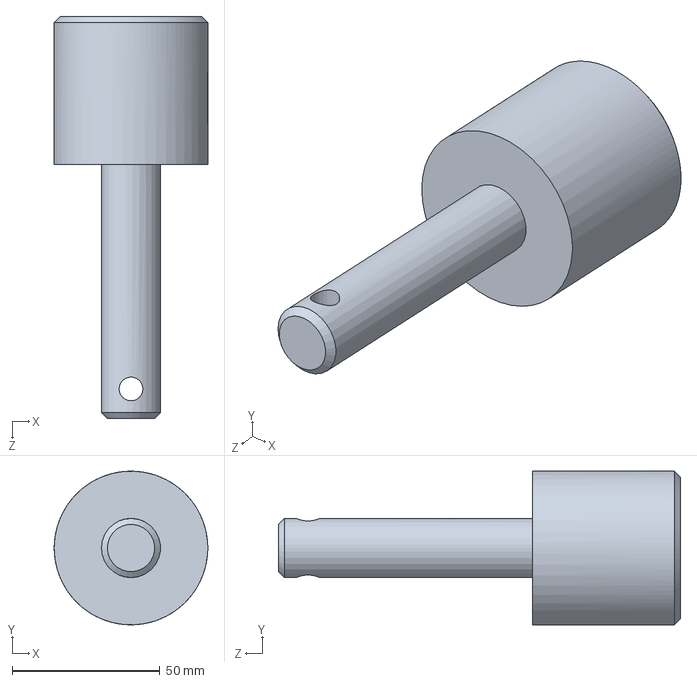
[picture p42: CAD file, 2026-06-23]
Float_Ram_SW2024/WheelAxis.SLDPRT
52.0 x 52.0 x 136.0 mm
