seromedises-PoliTo/Float-Ram-main/Float_Ram_STEP/FloatingMoldLateralPlate.STEP

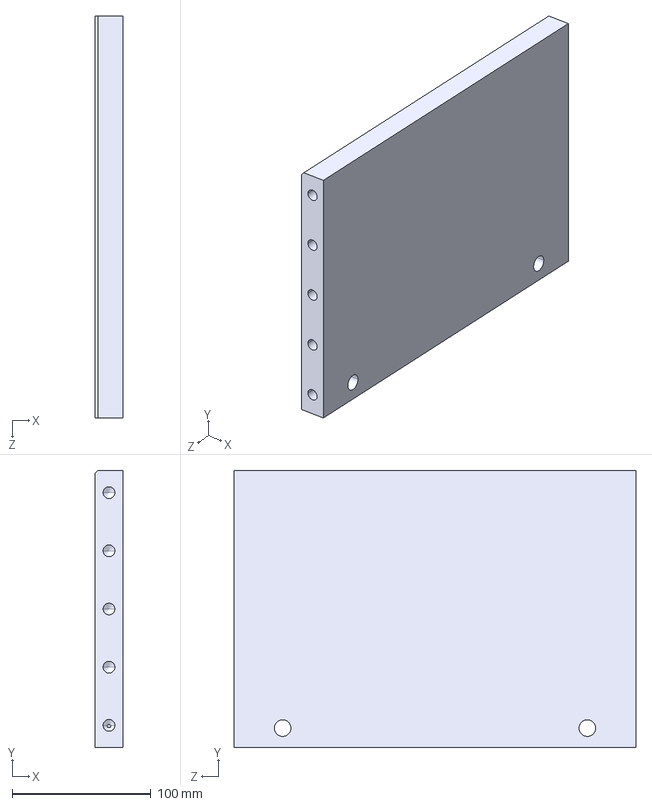
[picture p43: CAD file, 2026-06-23]
Float_Ram_STEP/FloatingMoldLateralPlate.STEP
20.0 x 200.0 x 290.0 mm
