seromedises-PoliTo/Float-Ram-main/Float_Ram_SW2024/LateralFoot.SLDPRT

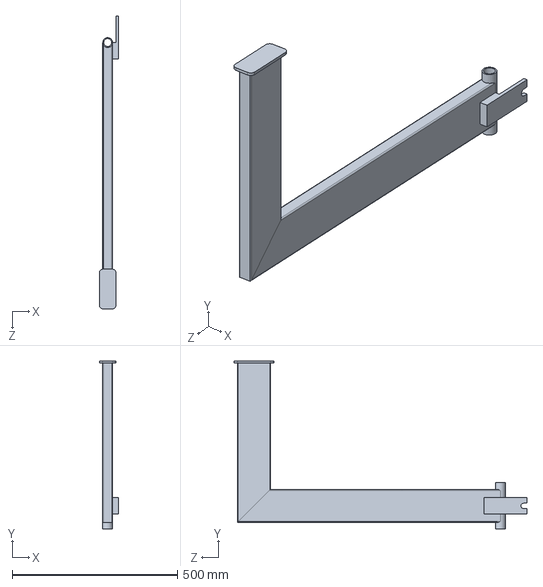
[picture p44: CAD file, 2026-06-23]
Float_Ram_SW2024/LateralFoot.SLDPRT
58.0 x 508.5 x 886.0 mm
