seromedises-PoliTo/Float-Ram-main/Float_Ram_STEP/LeverLock.STEP

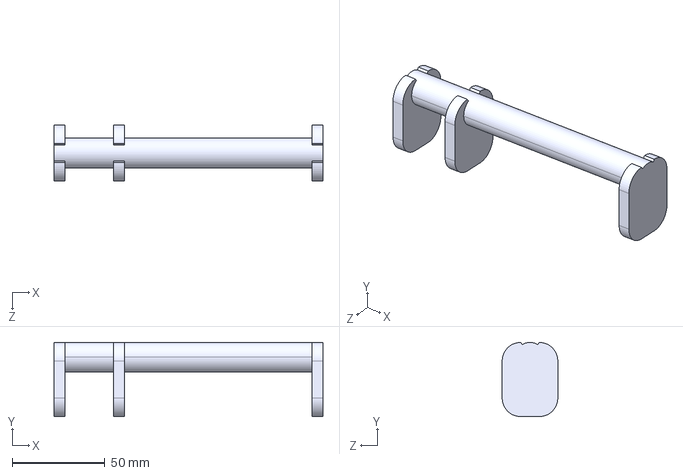
[picture p45: CAD file, 2026-06-23]
Float_Ram_STEP/LeverLock.STEP
145.0 x 40.0 x 30.0 mm
