seromedises-PoliTo/Float-Ram-main/Float_Ram_STEP/Wheel.STEP

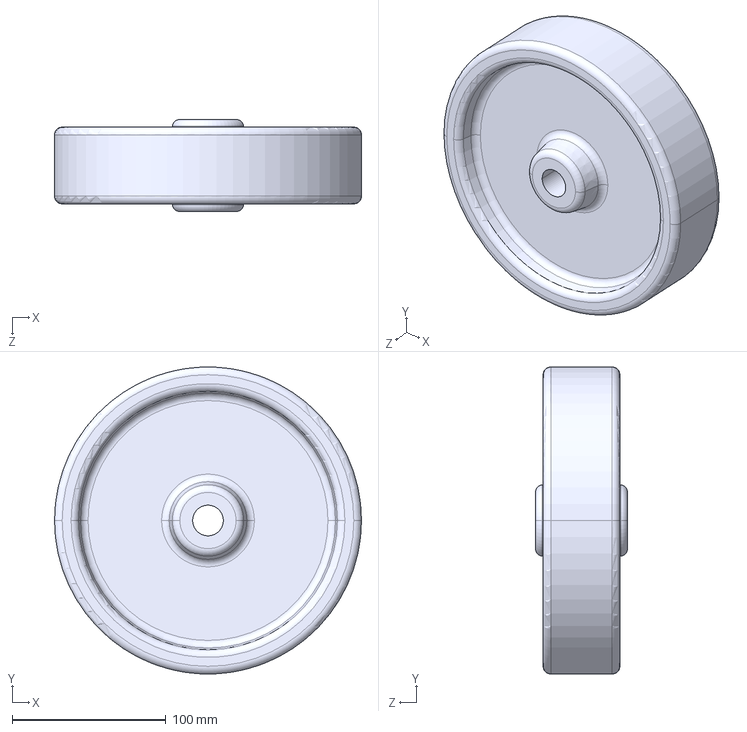
[picture p46: CAD file, 2026-06-23]
Float_Ram_STEP/Wheel.STEP
200.0 x 199.9 x 60.0 mm
