seromedises-PoliTo/Float-Ram-main/Float_Ram_SW2024/MeteringBox.SLDPRT

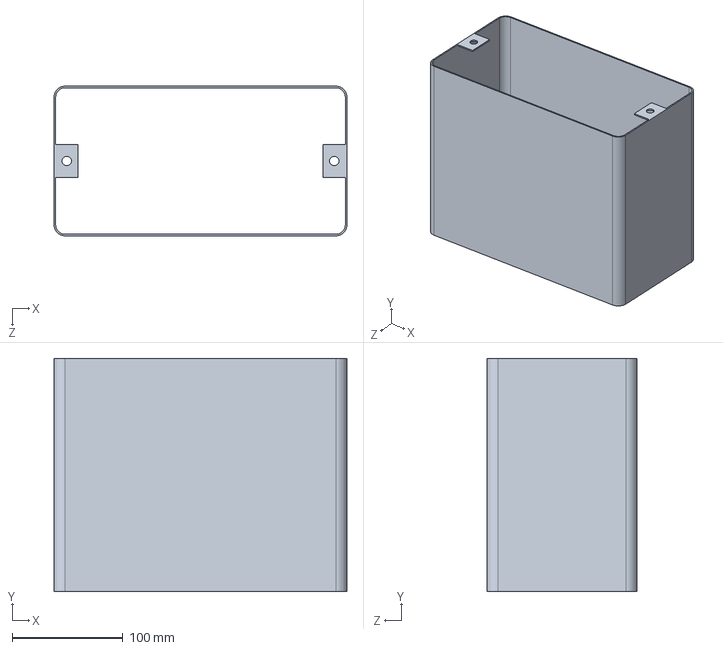
[picture p47: CAD file, 2026-06-23]
Float_Ram_SW2024/MeteringBox.SLDPRT
264.0 x 210.0 x 135.0 mm
