seromedises-PoliTo/Float-Ram-main/Float_Ram_STEP/ExpulsionCam.STEP

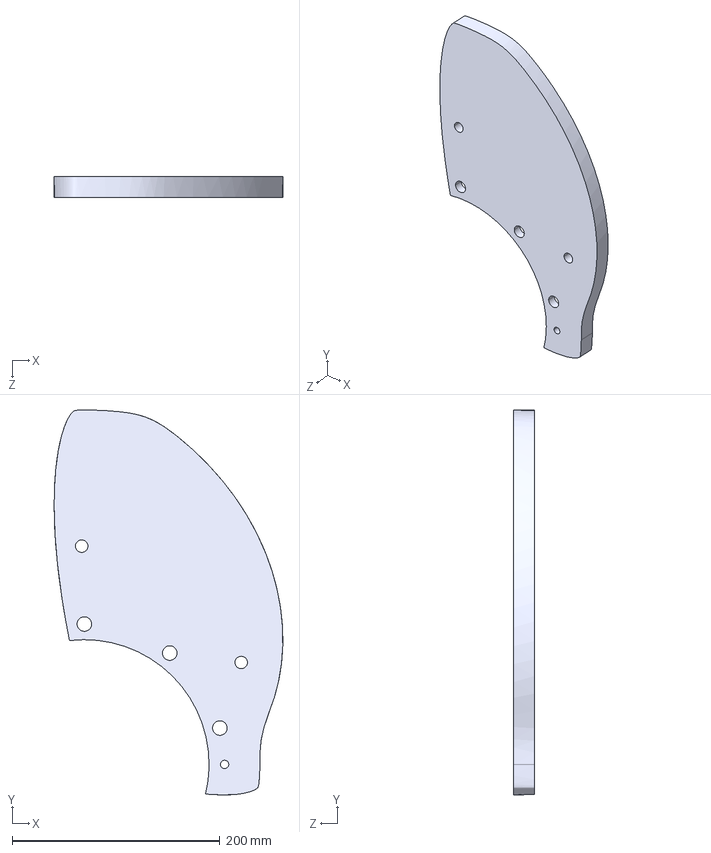
[picture p48: CAD file, 2026-06-23]
Float_Ram_STEP/ExpulsionCam.STEP
220.1 x 370.5 x 20.0 mm
