seromedises-PoliTo/Float-Ram-main/Float_Ram_STEP/parallel pin hardened_iso_ISO 8734 - 8 x 20 - A - St.STEP

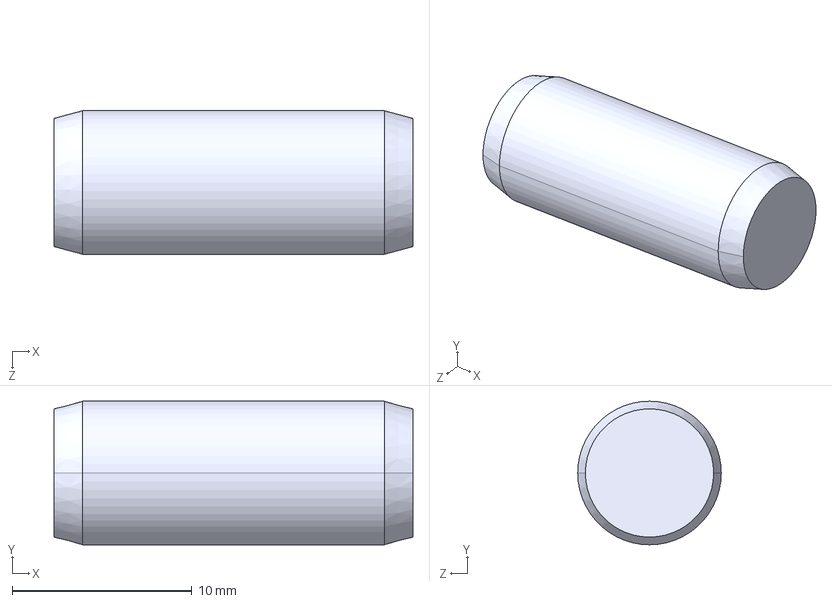
[picture p49: CAD file, 2026-06-23]
Float_Ram_STEP/parallel pin hardened_iso_ISO 8734 - 8 x 20 - A - St.STEP
20.0 x 8.00 x 8.00 mm
