seromedises-PoliTo/Float-Ram-main/Float_Ram_SW2024/CamFollowerMechShaft.SLDPRT

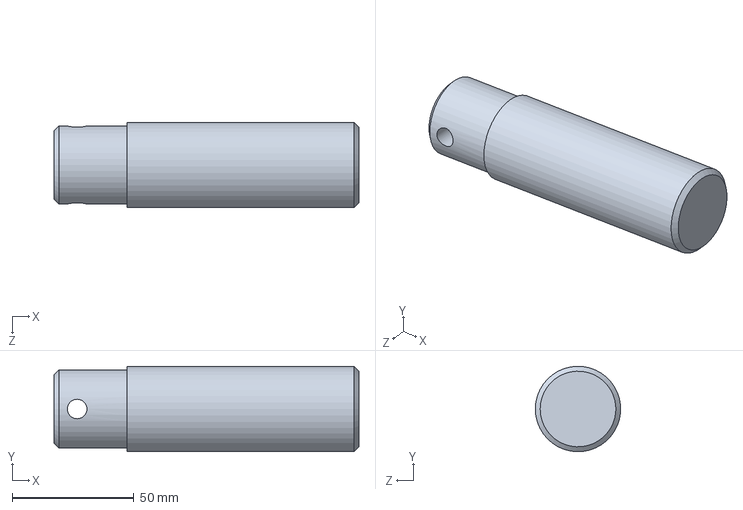
[picture p50: CAD file, 2026-06-23]
Float_Ram_SW2024/CamFollowerMechShaft.SLDPRT
125.0 x 35.0 x 35.0 mm
