seromedises-PoliTo/Float-Ram-main/Float_Ram_SW2024/MoldInsert_F.SLDPRT

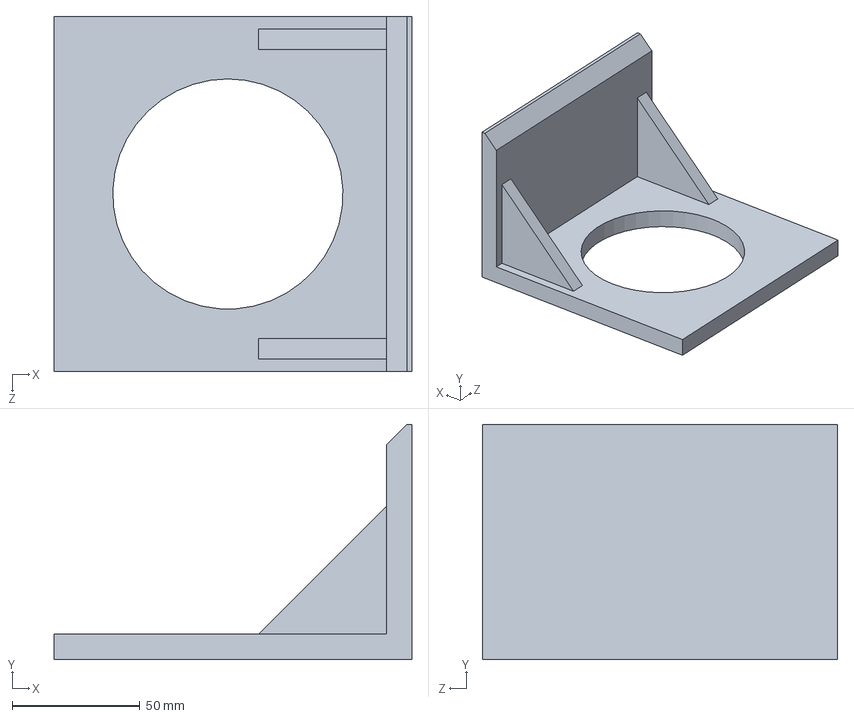
[picture p51: CAD file, 2026-06-23]
Float_Ram_SW2024/MoldInsert_F.SLDPRT
140.0 x 92.0 x 139.0 mm
