seromedises-PoliTo/Float-Ram-main/Float_Ram_STEP/SKF_Support_roller_nutr_4090_a_0_01.STEP

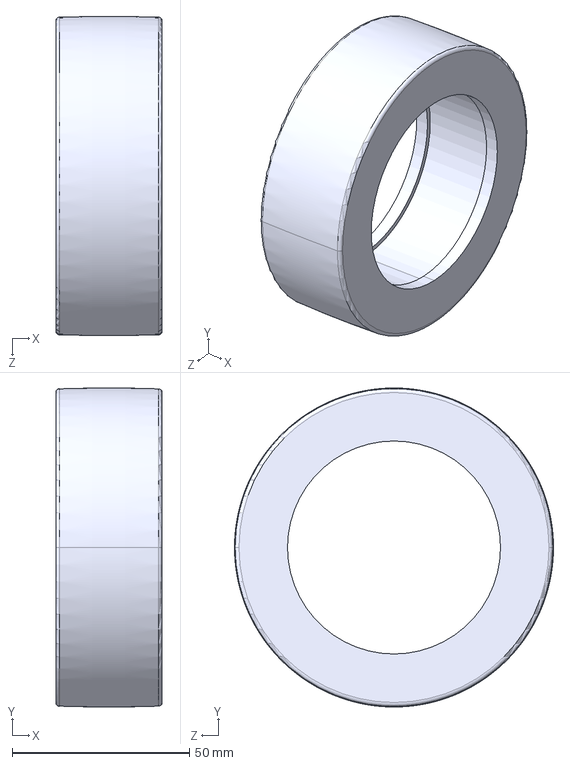
[picture p52: CAD file, 2026-06-23]
Float_Ram_STEP/SKF_Support_roller_nutr_4090_a_0_01.STEP
30.0 x 90.0 x 90.0 mm
