seromedises-PoliTo/Float-Ram-main/Float_Ram_SW2024/FrameUpperHorizontalProfile.SLDPRT

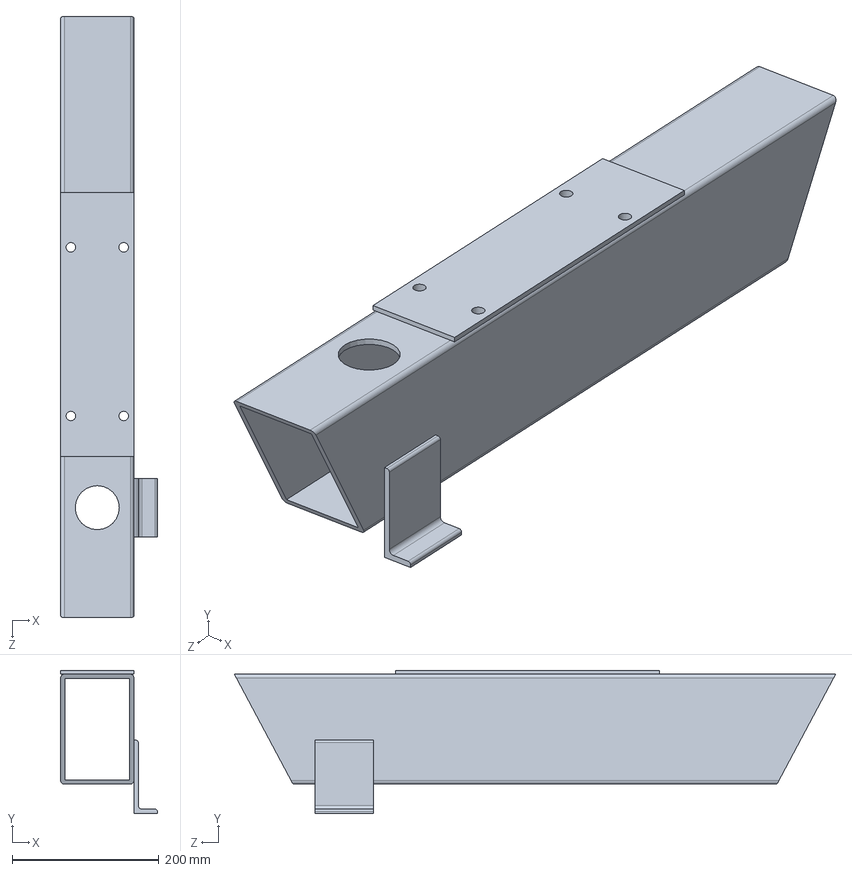
[picture p53: CAD file, 2026-06-23]
Float_Ram_SW2024/FrameUpperHorizontalProfile.SLDPRT
132.0 x 195.0 x 820.0 mm
