seromedises-PoliTo/Float-Ram-main/Float_Ram_STEP/LateralFootLockingLever.STEP

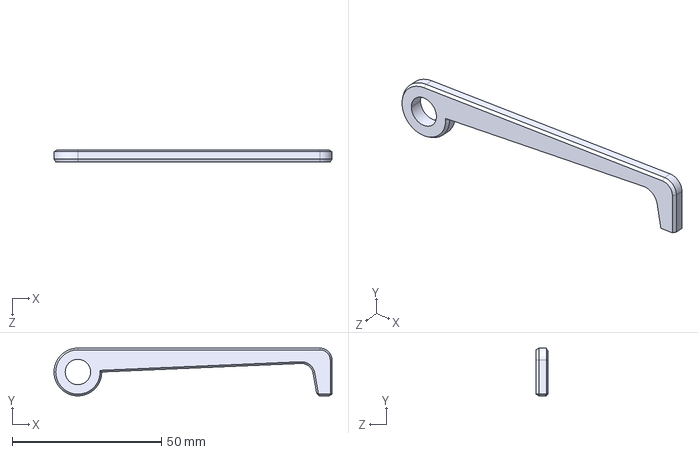
[picture p54: CAD file, 2026-06-23]
Float_Ram_STEP/LateralFootLockingLever.STEP
93.0 x 16.0 x 4.00 mm
