seromedises-PoliTo/Float-Ram-main/Float_Ram_STEP/FrameVerticalBackProfile.STEP

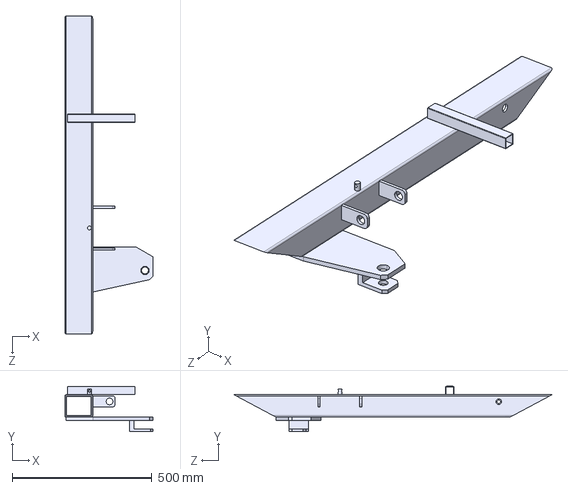
[picture p55: CAD file, 2026-06-23]
Float_Ram_STEP/FrameVerticalBackProfile.STEP
316.0 x 162.0 x 1136.0 mm
