seromedises-PoliTo/Float-Ram-main/Float_Ram_SW2024/FrameLowerHorizontalProfile.SLDPRT

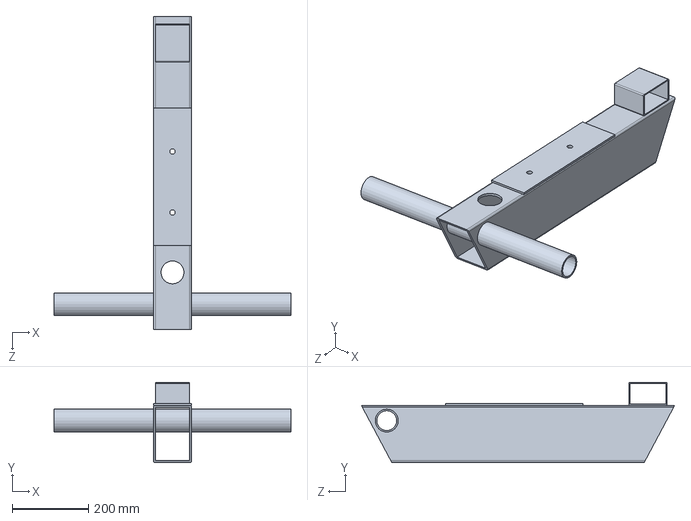
[picture p56: CAD file, 2026-06-23]
Float_Ram_SW2024/FrameLowerHorizontalProfile.SLDPRT
620.0 x 210.0 x 820.0 mm
