seromedises-PoliTo/Float-Ram-main/Float_Ram_STEP/Gasket.STEP

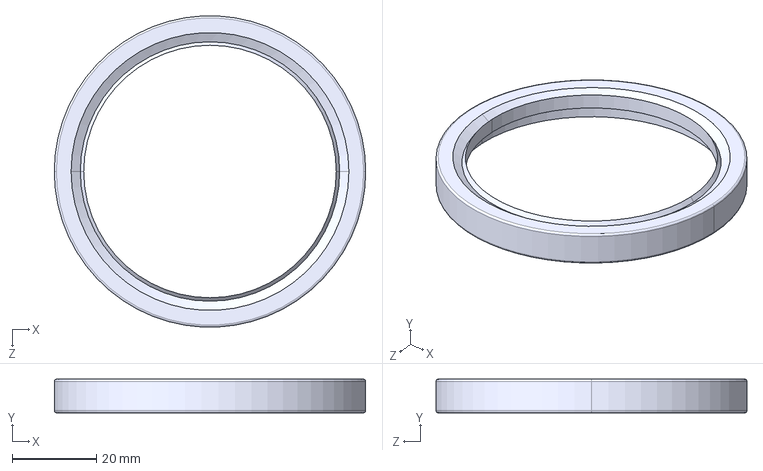
[picture p58: CAD file, 2026-06-23]
Float_Ram_STEP/Gasket.STEP
74.0 x 8.00 x 73.9 mm
