seromedises-PoliTo/Float-Ram-main/Float_Ram_SW2024/MeteringBoxHolder.SLDPRT

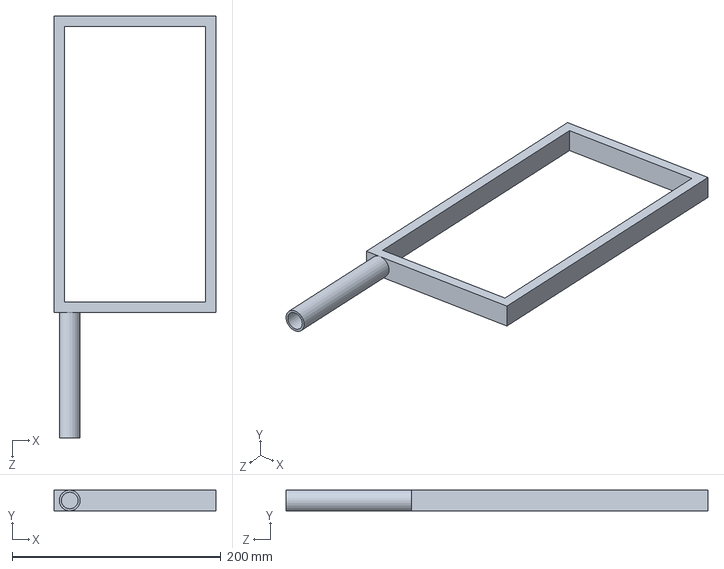
[picture p59: CAD file, 2026-06-23]
Float_Ram_SW2024/MeteringBoxHolder.SLDPRT
155.0 x 20.0 x 404.0 mm
