seromedises-PoliTo/Float-Ram-main/Float_Ram_STEP/SKF_Support_roller_nutr_4090_a_0_05.STEP

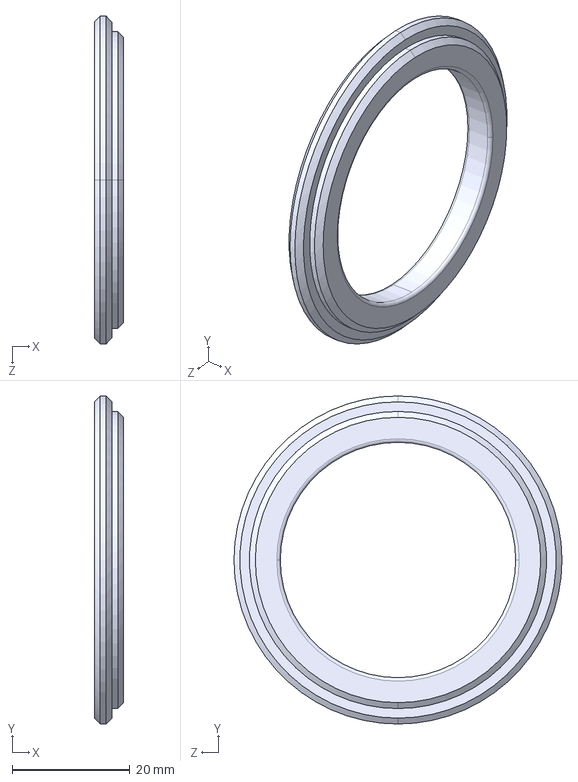
[picture p60: CAD file, 2026-06-23]
Float_Ram_STEP/SKF_Support_roller_nutr_4090_a_0_05.STEP
5.00 x 55.8 x 55.8 mm
