seromedises-PoliTo/Float-Ram-main/Float_Ram_SW2024/SKF_Support_roller_nutr_4090_a_0_08.SLDPRT

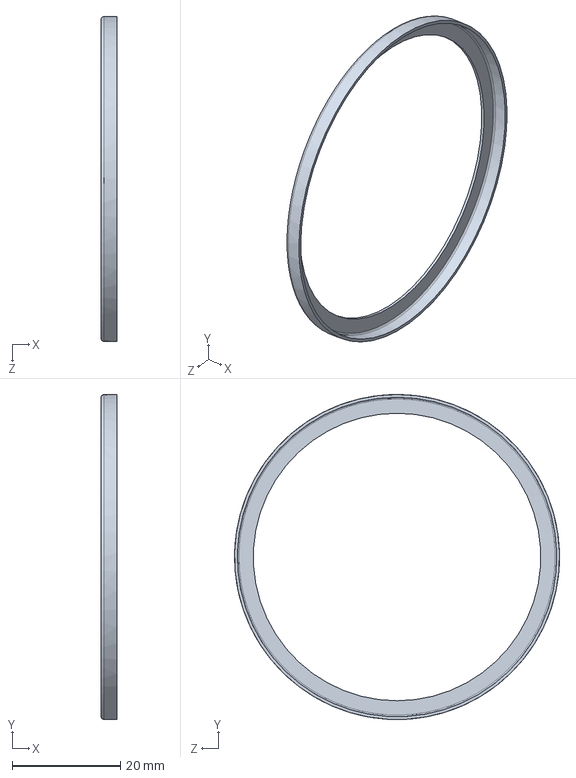
[picture p61: CAD file, 2026-06-23]
Float_Ram_SW2024/SKF_Support_roller_nutr_4090_a_0_08.SLDPRT
3.00 x 60.0 x 60.0 mm
