seromedises-PoliTo/Float-Ram-main/Float_Ram_SW2024/MeteringBoxShaft.SLDPRT

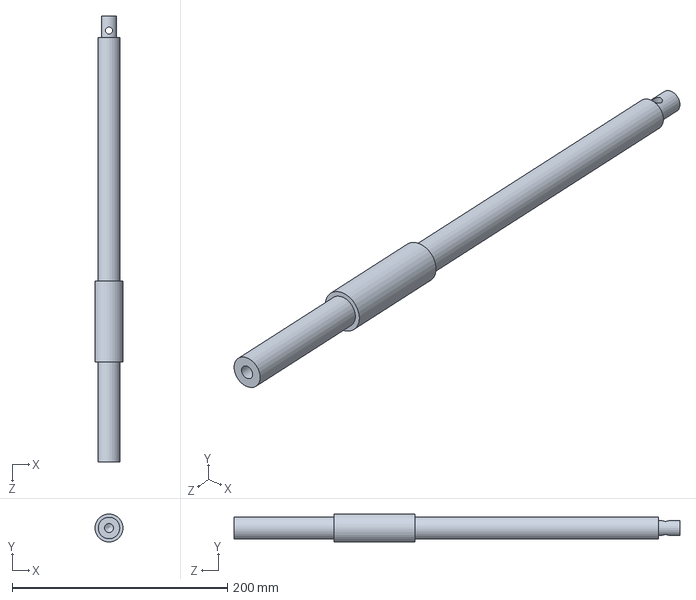
[picture p62: CAD file, 2026-06-23]
Float_Ram_SW2024/MeteringBoxShaft.SLDPRT
26.0 x 26.0 x 414.0 mm
