seromedises-PoliTo/Float-Ram-main/Float_Ram_SW2024/Shaft.SLDPRT

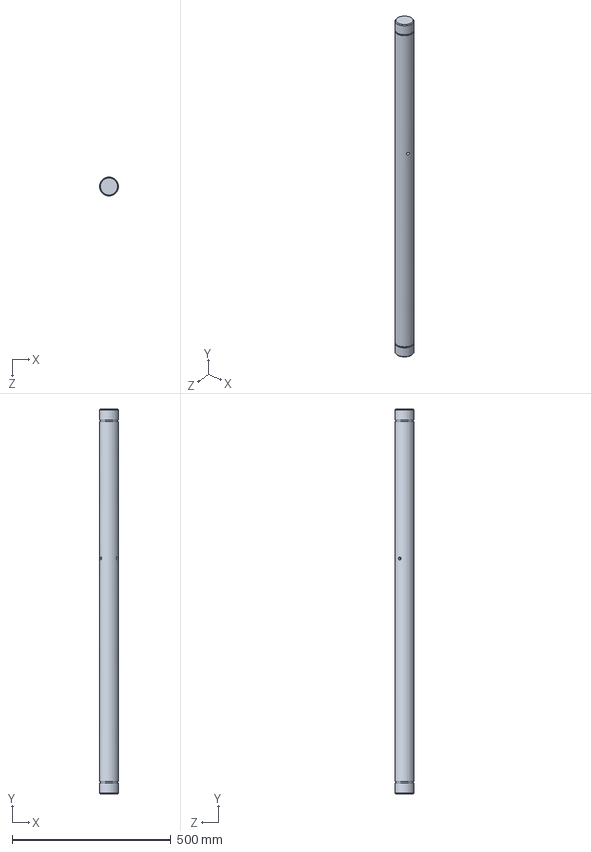
[picture p63: CAD file, 2026-06-23]
Float_Ram_SW2024/Shaft.SLDPRT
59.9 x 1214.0 x 60.0 mm
