seromedises-PoliTo/Float-Ram-main/Float_Ram_STEP/PressCam.STEP

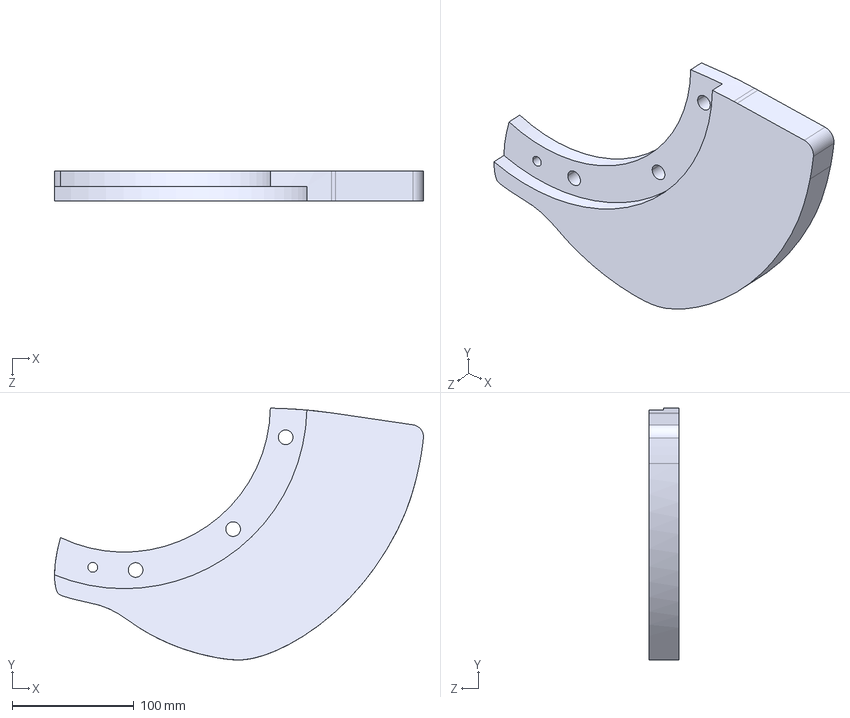
[picture p64: CAD file, 2026-06-23]
Float_Ram_STEP/PressCam.STEP
302.8 x 206.7 x 25.0 mm
