seromedises-PoliTo/Float-Ram-main/Float_Ram_SW2024/MoldLowerPlate.SLDPRT

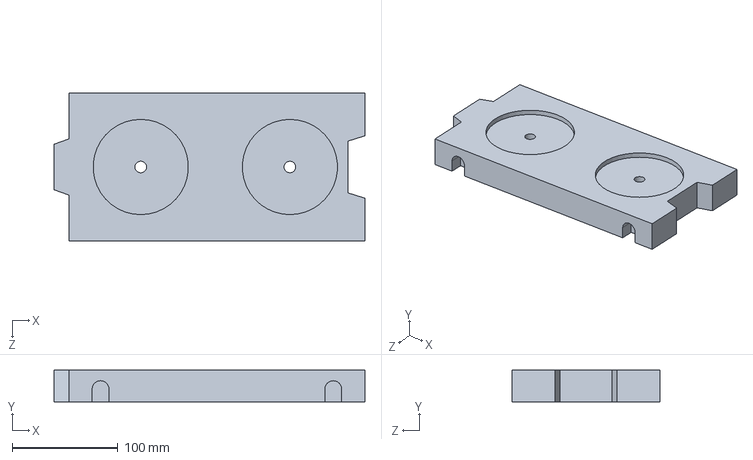
[picture p65: CAD file, 2026-06-23]
Float_Ram_SW2024/MoldLowerPlate.SLDPRT
294.0 x 30.0 x 140.0 mm
