seromedises-PoliTo/Float-Ram-main/Float_Ram_SW2024/PressRollerSupport.SLDPRT

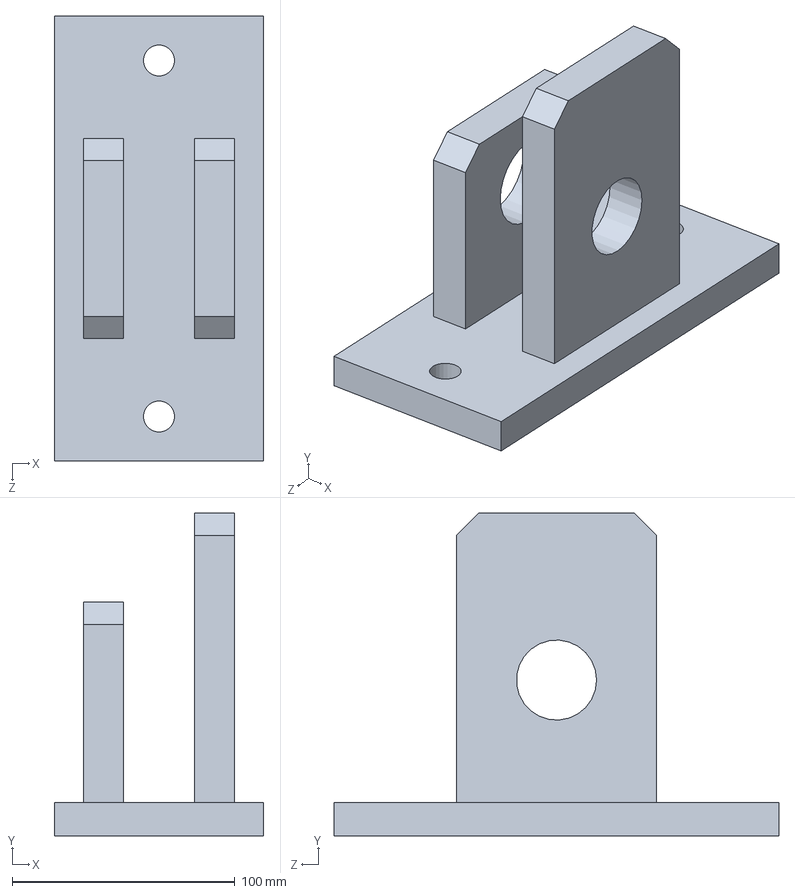
[picture p66: CAD file, 2026-06-23]
Float_Ram_SW2024/PressRollerSupport.SLDPRT
94.0 x 145.0 x 200.0 mm
