seromedises-PoliTo/Float-Ram-main/Float_Ram_STEP/FloatingMoldGuide.STEP

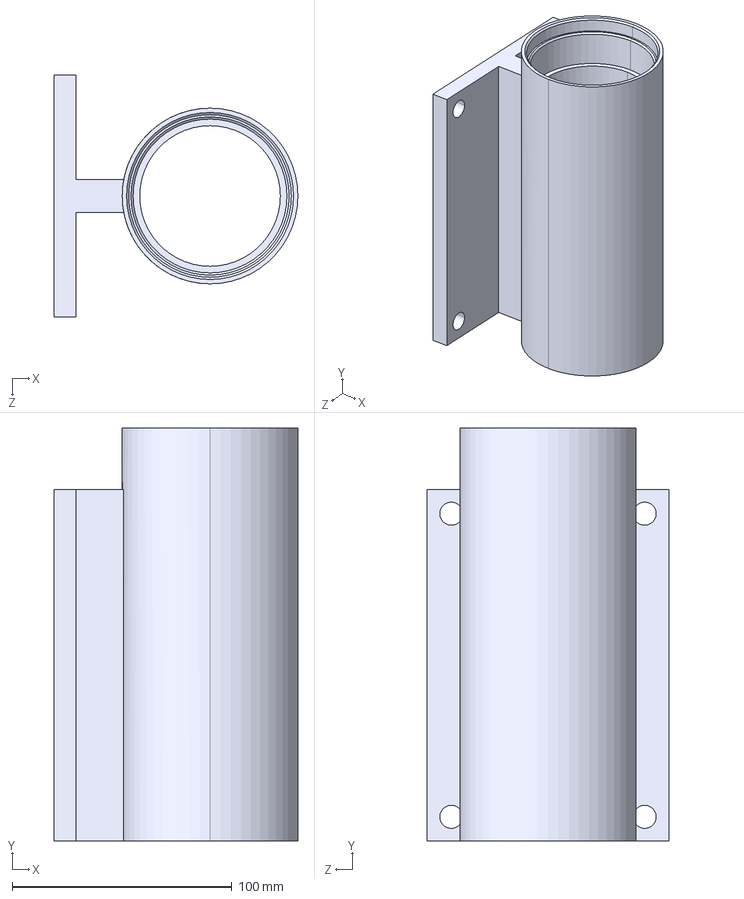
[picture p67: CAD file, 2026-06-23]
Float_Ram_STEP/FloatingMoldGuide.STEP
111.0 x 188.0 x 110.0 mm
