seromedises-PoliTo/Float-Ram-main/Float_Ram_SW2024/PressRoller_90x42x32x17.SLDPRT

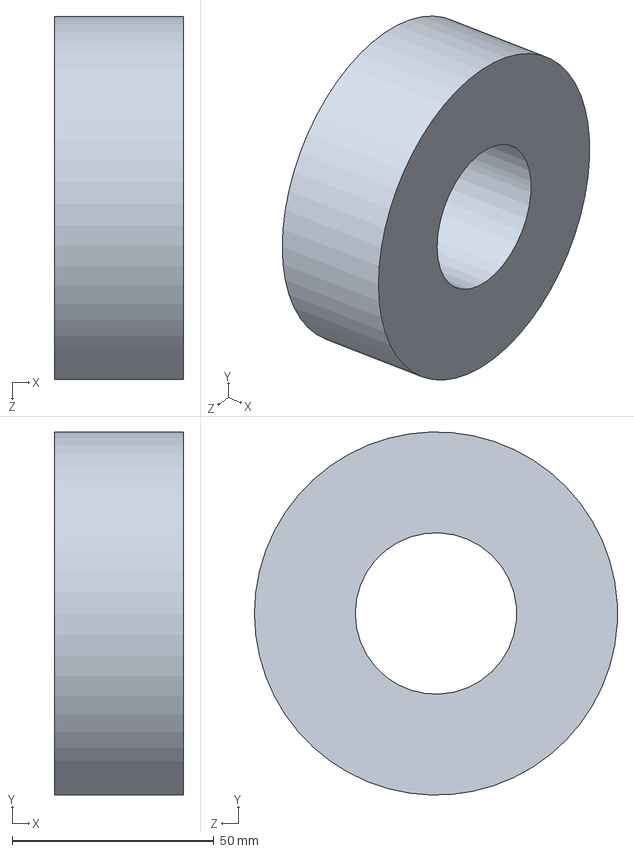
[picture p68: CAD file, 2026-06-23]
Float_Ram_SW2024/PressRoller_90x42x32x17.SLDPRT
32.0 x 90.0 x 90.0 mm
