seromedises-PoliTo/Float-Ram-main/Float_Ram_STEP/ExpulsionRollerShaft.STEP

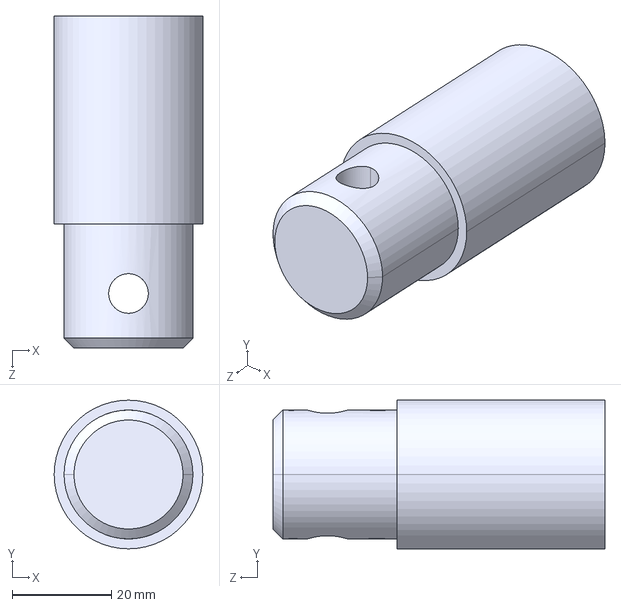
[picture p69: CAD file, 2026-06-23]
Float_Ram_STEP/ExpulsionRollerShaft.STEP
30.0 x 30.0 x 67.0 mm
