seromedises-PoliTo/Float-Ram-main/Float_Ram_SW2024/CamFollowerMechBearingSpacer.SLDPRT

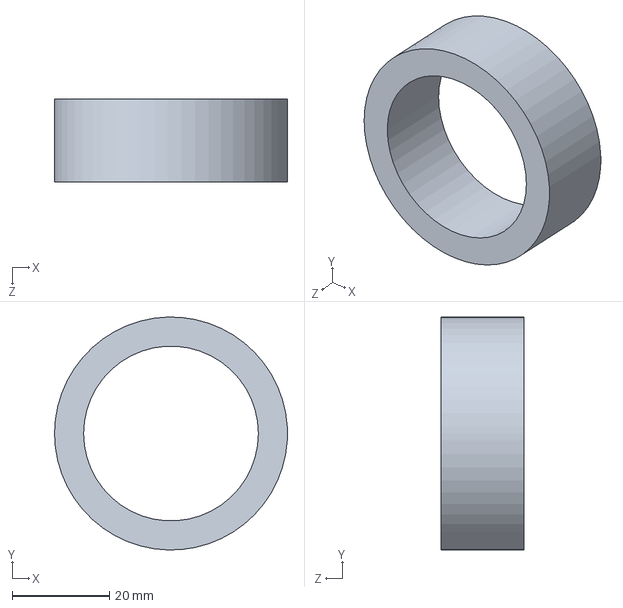
[picture p70: CAD file, 2026-06-23]
Float_Ram_SW2024/CamFollowerMechBearingSpacer.SLDPRT
48.0 x 48.0 x 17.0 mm
