seromedises-PoliTo/Float-Ram-main/Float_Ram_SW2024/FloatingMoldLateralPlate.SLDPRT

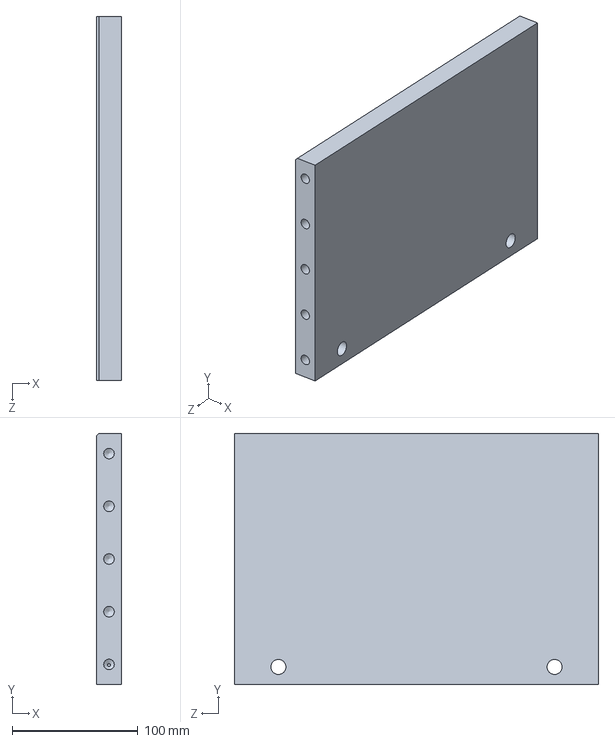
[picture p71: CAD file, 2026-06-23]
Float_Ram_SW2024/FloatingMoldLateralPlate.SLDPRT
20.0 x 200.0 x 290.0 mm
