seromedises-PoliTo/Float-Ram-main/Float_Ram_STEP/MoldLowerPlate.STEP

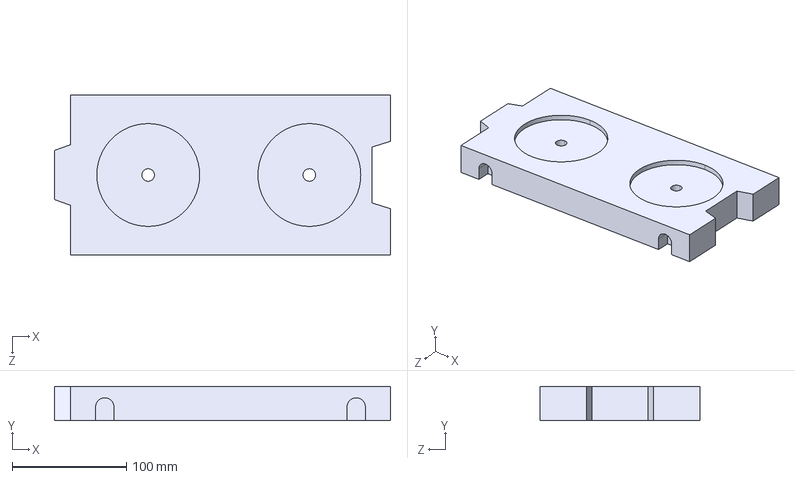
[picture p72: CAD file, 2026-06-23]
Float_Ram_STEP/MoldLowerPlate.STEP
294.0 x 30.0 x 140.0 mm
