seromedises-PoliTo/Float-Ram-main/Float_Ram_SW2024/SKF_Support_roller_nutr_4090_a_0_04.SLDPRT

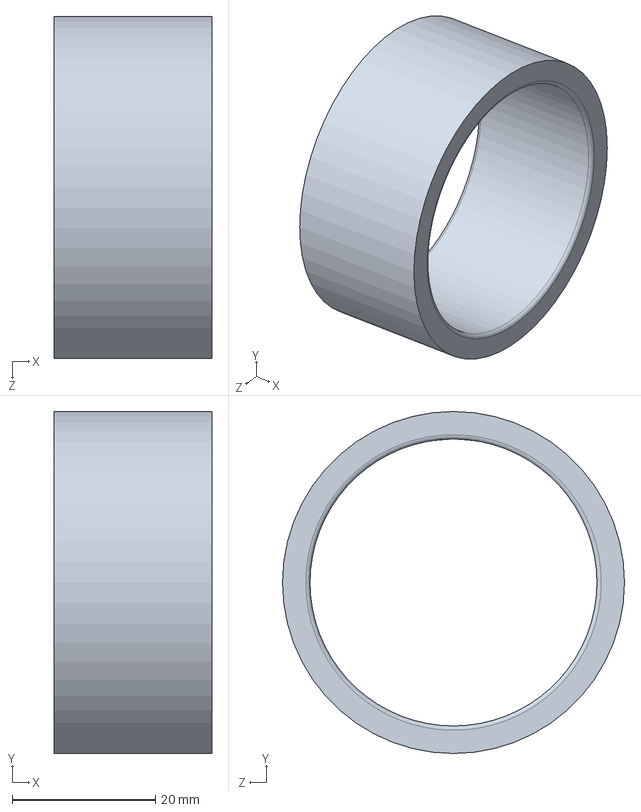
[picture p73: CAD file, 2026-06-23]
Float_Ram_SW2024/SKF_Support_roller_nutr_4090_a_0_04.SLDPRT
22.0 x 47.7 x 47.7 mm
