seromedises-PoliTo/Float-Ram-main/Float_Ram_STEP/Lever.STEP

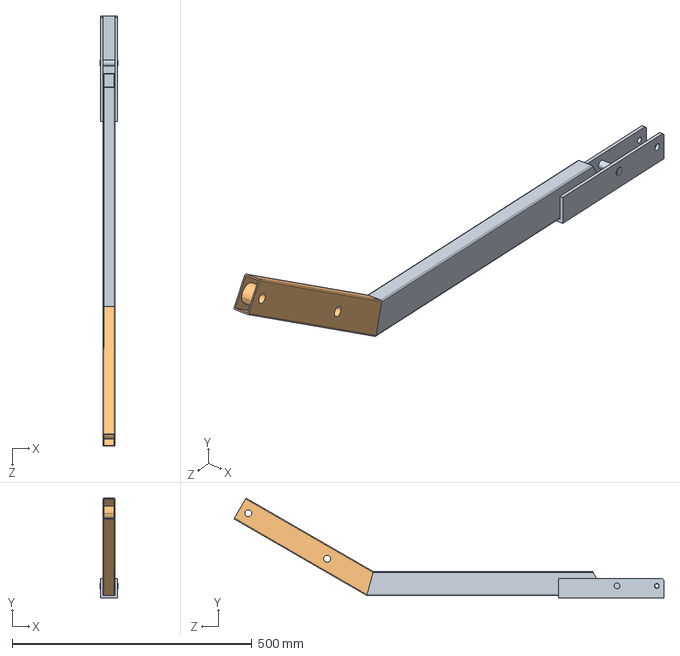
[picture p74: CAD file, 2026-06-23]
Float_Ram_STEP/Lever.STEP
37.0 x 208.3 x 897.1 mm
