seromedises-PoliTo/Float-Ram-main/Float_Ram_STEP/MeteringBoxShaft.STEP

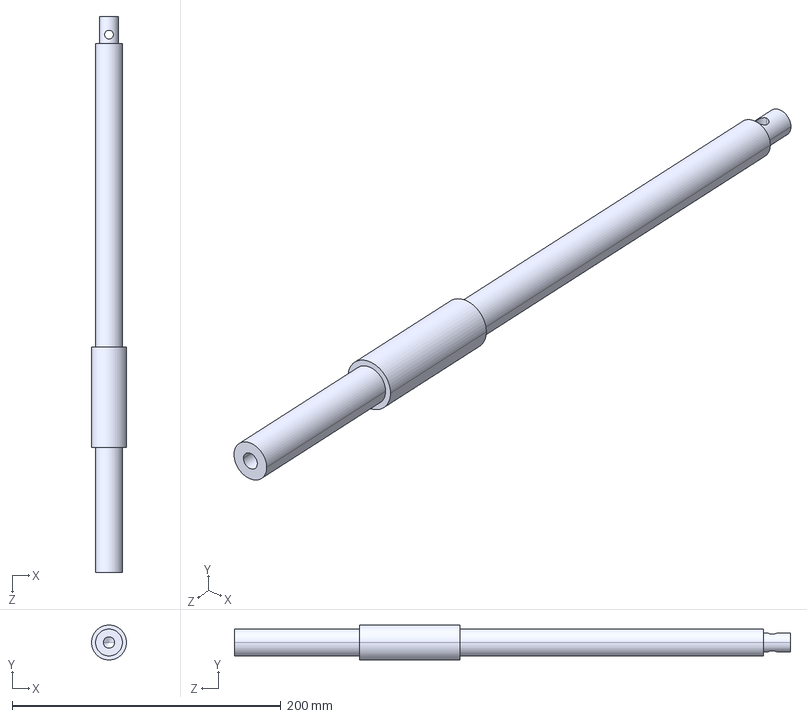
[picture p75: CAD file, 2026-06-23]
Float_Ram_STEP/MeteringBoxShaft.STEP
26.0 x 26.0 x 414.0 mm
