seromedises-PoliTo/Float-Ram-main/Float_Ram_SW2024/Assembly_2nd_CamFolowerMech.SLDASM

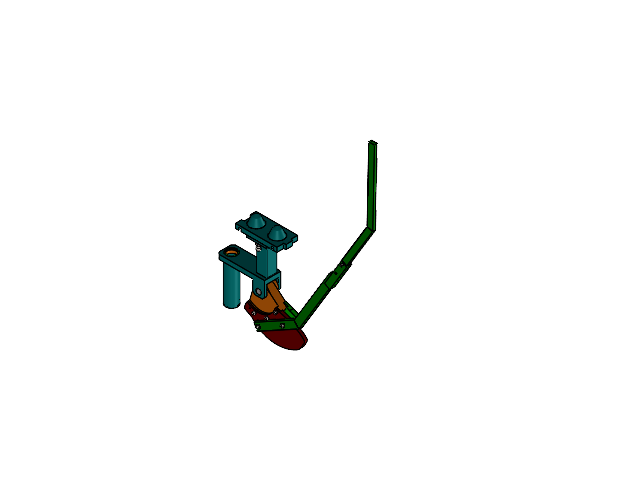
[picture p76: CAD file, 2026-06-23]
Float_Ram_SW2024/Assembly_2nd_CamFolowerMech.SLDASM
CamFollowerMechGuide
MoldLowerPlate
MoldLowerPlateInsert x 2
socket head cap screw_iso x 16
RadialBushing x 2
Gasket x 2
CamFollowerMechShaft
CamFollowerMechHolder
SKF_SupportRoller_NUTR_35A_0_01 x 2
SKF_SupportRoller_NUTR_35A_0_02 x 2
SKF_SupportRoller_NUTR_35A_0_03 x 2
SKF_SupportRoller_NUTR_35A_0_04 x 2
SKF_SupportRoller_NUTR_35A_0_05 x 2
SKF_SupportRoller_NUTR_35A_0_06 x 2
SKF_SupportRoller_NUTR_35A_0_07 x 2
SKF_SupportRoller_NUTR_35A_0_08 x 2
CamFollowerMechBearingSpacer
ExpulsionCam
PressCam
Lever
LevelExtension
hex nut gradec_iso x 4
