seromedises-PoliTo/Float-Ram-main/Float_Ram_SW2024/Assembly_2nd_Shaft.SLDASM

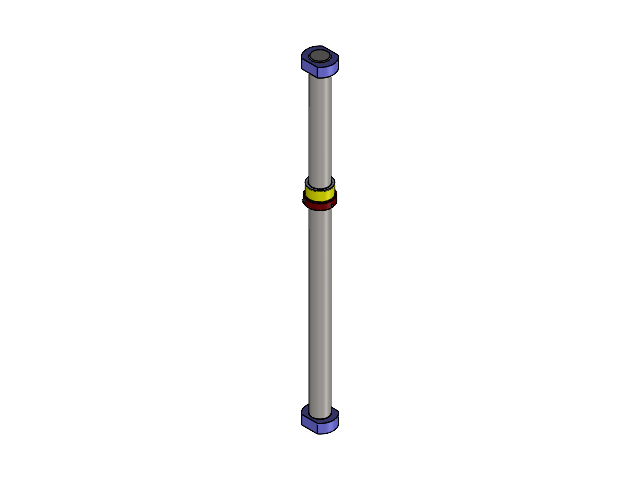
[picture p77: CAD file, 2026-06-23]
Float_Ram_SW2024/Assembly_2nd_Shaft.SLDASM
Shaft
ShaftRingNut x 2
ShaftAxialBlock
SpringSimplified_LoadedCondition
SpringWasher
socket set screw cup point_iso x 3
