seromedises-PoliTo/Float-Ram-main/Float_Ram_SW2024/Assembly_2nd_FloatingMold.SLDASM

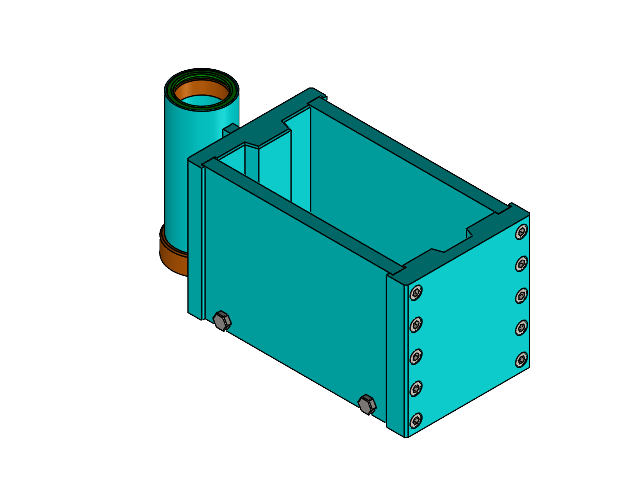
[picture p78: CAD file, 2026-06-23]
Float_Ram_SW2024/Assembly_2nd_FloatingMold.SLDASM
FloatingMoldGuide
Gasket
AxialRadialBushing
RadialBushing
FloatingMoldBackPlate
FloatingMoldFrontPlate
FloatingMoldLateralPlate x 2
parallel pin hardened_iso x 2
socket head cap screw_iso x 24
FloatingMoldBottomScrew x 4
