seromedises-PoliTo/Float-Ram-main/Float_Ram_SW2024/Assembly_2nd_MeteringBox.SLDASM

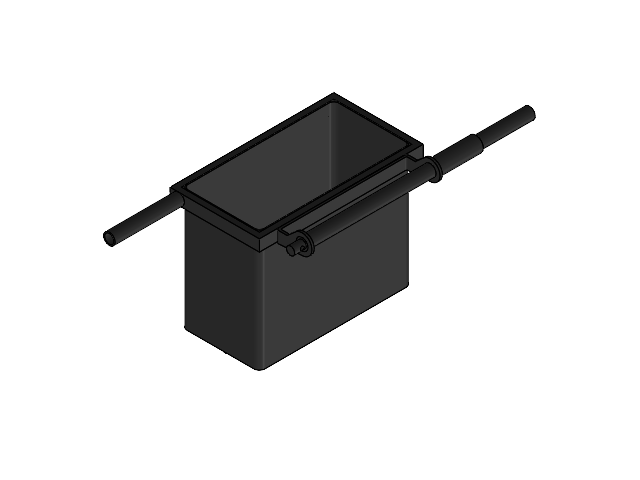
[picture p79: CAD file, 2026-06-23]
Float_Ram_SW2024/Assembly_2nd_MeteringBox.SLDASM
MeteringBox
MeteringBoxAdjustingScrew x 2
MeteringBoxHolder
MeteringBoxJoint
MeteringBoxLowerPlate
MeteringBoxShaft
