seromedises-PoliTo/Float-Ram-main/Float_Ram_SW2024/Assembly_2nd_Frame.SLDASM

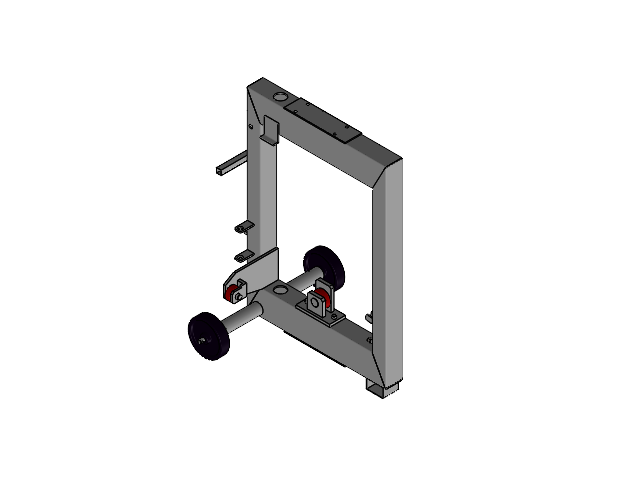
[picture p80: CAD file, 2026-06-23]
Float_Ram_SW2024/Assembly_2nd_Frame.SLDASM
FrameLowerHorizontalProfile
FrameUpperHorizontalProfile
FrameVerticalBackProfile
FrameVerticalFrontProfile
PressRollerSupport
Screw_M14x200 x 2
Nut_M14 x 2
Wheel x 2
WheelAxis x 2
ExpulsionRollerShaft
SKF_SupportRoller_NUTR_3072_0_01
SKF_SupportRoller_NUTR_3072_0_02
SKF_SupportRoller_NUTR_3072_0_03
SKF_SupportRoller_NUTR_3072_0_04
SKF_SupportRoller_NUTR_3072_0_05
SKF_SupportRoller_NUTR_3072_0_06
SKF_SupportRoller_NUTR_3072_0_07
SKF_SupportRoller_NUTR_3072_0_08
PressRollerShaft
SKF_Support_roller_nutr_4090_a_0_01
SKF_Support_roller_nutr_4090_a_0_02
SKF_Support_roller_nutr_4090_a_0_03
SKF_Support_roller_nutr_4090_a_0_04
SKF_Support_roller_nutr_4090_a_0_05
SKF_Support_roller_nutr_4090_a_0_06
SKF_Support_roller_nutr_4090_a_0_07
SKF_Support_roller_nutr_4090_a_0_08
LeverLock
LeverLockSupport x 2
socket head cap screw 4762_din x 4
LateralFootLockingLever
prevailing torque nut style 1 insert_din
