seromedises-PoliTo/Float-Ram-main/Float_Ram_SW2024/SKF_Support_roller_nutr_4090_a.SLDASM

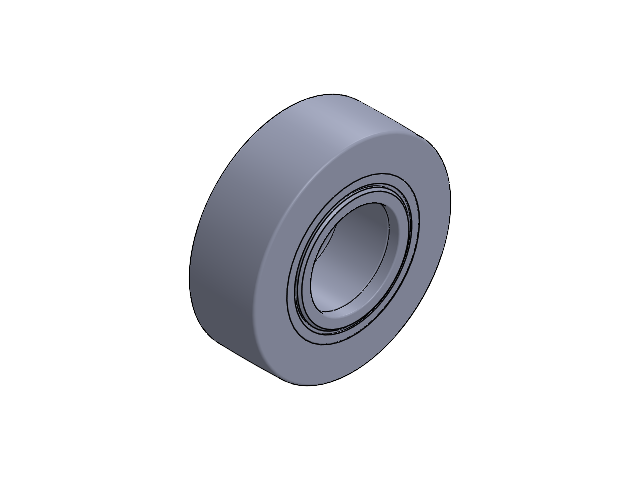
[picture p81: CAD file, 2026-06-23]
Float_Ram_SW2024/SKF_Support_roller_nutr_4090_a.SLDASM
SKF_Support_roller_nutr_4090_a_0_01
SKF_Support_roller_nutr_4090_a_0_02
SKF_Support_roller_nutr_4090_a_0_03
SKF_Support_roller_nutr_4090_a_0_04
SKF_Support_roller_nutr_4090_a_0_05
SKF_Support_roller_nutr_4090_a_0_06
SKF_Support_roller_nutr_4090_a_0_07
SKF_Support_roller_nutr_4090_a_0_08
