seromedises-PoliTo/Float-Ram-main/Float_Ram_SW2024/SKF_SupportRoller_NUTR_35A.SLDASM

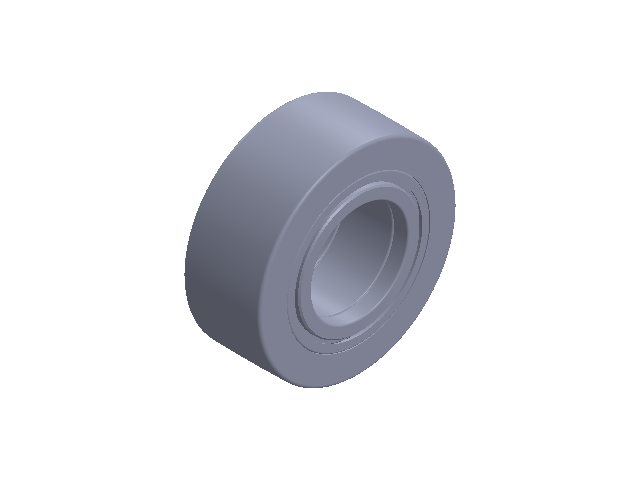
[picture p82: CAD file, 2026-06-23]
Float_Ram_SW2024/SKF_SupportRoller_NUTR_35A.SLDASM
SKF_SupportRoller_NUTR_35A_0_01
SKF_SupportRoller_NUTR_35A_0_02
SKF_SupportRoller_NUTR_35A_0_03
SKF_SupportRoller_NUTR_35A_0_04
SKF_SupportRoller_NUTR_35A_0_05
SKF_SupportRoller_NUTR_35A_0_06
SKF_SupportRoller_NUTR_35A_0_07
SKF_SupportRoller_NUTR_35A_0_08
