seromedises-PoliTo/Float-Ram-main/(list of files, cad)

Other CAD files:
Float_Ram_STEP/Assembly_2nd_FloatingMold.STEP
Float_Ram_STEP/Assembly_2nd_Frame.STEP
Float_Ram_STEP/Assembly_2nd_MeteringBox.STEP
Float_Ram_STEP/Assembly_3rd_MoldLowerPlate.STEP
Float_Ram_STEP/Assembly_2nd_CamFolowerMech.STEP
Float_Ram_STEP/Assembly_1st_FloatRam.STEP
Float_Ram_STEP/Assembly_2nd_Shaft.STEP
Float_Ram_STEP/MoldUpperPlate.STEP
Float_Ram_STEP/LevelExtension.STEP
Float_Ram_STEP/SKF_Support_roller_nutr_4090_a.STEP
Float_Ram_SW2024/SKF_SupportRoller_NUTR_3072_0_07.SLDPRT
Float_Ram_SW2024/SKF_SupportRoller_NUTR_35A_0_06.SLDPRT
Float_Ram_SW2024/SKF_SupportRoller_NUTR_3072_0_08.SLDPRT
Float_Ram_STEP/SKF_SupportRoller_NUTR_35A.STEP
Float_Ram_STEP/SKF_SupportRoller_NUTR_35A_0_07.STEP
Float_Ram_SW2024/SKF_SupportRoller_NUTR_35A_0_08.SLDPRT
Float_Ram_SW2024/SKF_SupportRoller_NUTR_3072_0_02.SLDPRT
Float_Ram_STEP/SKF_SupportRoller_NUTR_3072_0_06.STEP
Float_Ram_SW2024/SKF_SupportRoller_NUTR_3072_0_05.SLDPRT
Float_Ram_STEP/FrameVerticalFrontProfile.STEP
Float_Ram_STEP/SKF_SupportRoller_NUTR_3072_0_03.STEP
Float_Ram_SW2024/SKF_SupportRoller_NUTR_35A_0_05.SLDPRT
Float_Ram_SW2024/Wheel.SLDPRT
Float_Ram_SW2024/SKF_SupportRoller_NUTR_3072_0_03.SLDPRT
Float_Ram_STEP/SKF_SupportRoller_NUTR_35A_0_04.STEP
Float_Ram_SW2024/MeteringBoxLowerPlate.SLDPRT
Float_Ram_STEP/SKF_Support_roller_nutr_4090_a_0_03.STEP
Float_Ram_SW2024/SKF_Support_roller_nutr_4090_a_0_01.SLDPRT
Float_Ram_STEP/SKF_SupportRoller_NUTR_3072_0_08.STEP
Float_Ram_SW2024/PressRollerShaft.SLDPRT
Float_Ram_STEP/SKF_Support_roller_nutr_4090_a_0_08.STEP
Float_Ram_SW2024/MeteringBoxJoint.SLDPRT
Float_Ram_STEP/LateralFoot.STEP
Float_Ram_SW2024/SKF_SupportRoller_NUTR_35A_0_07.SLDPRT
Float_Ram_SW2024/SKF_Support_roller_nutr_4090_a_0_06.SLDPRT
Float_Ram_SW2024/FloatingMoldGuide.SLDPRT
Float_Ram_STEP/CamFollowerMechHolder.STEP
Float_Ram_SW2024/PressCam.SLDPRT
Float_Ram_STEP/MoldLowerPlateInsert.STEP
Float_Ram_SW2024/SKF_SupportRoller_NUTR_3072_0_06.SLDPRT
Float_Ram_SW2024/Gasket.SLDPRT
Float_Ram_SW2024/ExpulsionRollerShaft.SLDPRT
Float_Ram_STEP/SKF_SupportRoller_NUTR_3072.STEP
Float_Ram_SW2024/SKF_SupportRoller_NUTR_35A_0_01.SLDPRT
Float_Ram_STEP/CamFollowerMechShaft.STEP
Float_Ram_SW2024/ExpulsionCam.SLDPRT
Float_Ram_STEP/SKF_Support_roller_nutr_4090_a_0_02.STEP
Float_Ram_SW2024/SKF_SupportRoller_NUTR_3072_0_01.SLDPRT
Float_Ram_STEP/AxialRadialBushing.STEP
Float_Ram_SW2024/FrameVerticalBackProfile.SLDPRT
Float_Ram_STEP/WheelAxis.STEP
Float_Ram_SW2024/SKF_SupportRoller_NUTR_35A_0_03.SLDPRT
Float_Ram_STEP/SKF_Support_roller_nutr_4090_a_0_07.STEP
Float_Ram_STEP/Shaft.STEP
Float_Ram_SW2024/SKF_SupportRoller_NUTR_35A_0_02.SLDPRT
Float_Ram_STEP/SKF_SupportRoller_NUTR_35A_0_05.STEP
Float_Ram_SW2024/LeverLockSupport.SLDPRT
Float_Ram_STEP/SKF_SupportRoller_NUTR_3072_0_01.STEP
Float_Ram_SW2024/SKF_Support_roller_nutr_4090_a_0_05.SLDPRT
Float_Ram_SW2024/SKF_Support_roller_nutr_4090_a_0_03.SLDPRT
Float_Ram_STEP/SKF_Support_roller_nutr_4090_a_0_04.STEP
Float_Ram_STEP/FrameLowerHorizontalProfile.STEP
Float_Ram_SW2024/Lever.SLDPRT
Float_Ram_STEP/SKF_SupportRoller_NUTR_3072_0_04.STEP
Float_Ram_SW2024/SKF_Support_roller_nutr_4090_a_0_07.SLDPRT
Float_Ram_SW2024/LateralFootLockingLever.SLDPRT
Float_Ram_STEP/SKF_SupportRoller_NUTR_35A_0_03.STEP
Float_Ram_SW2024/LateralFootAxis.SLDPRT
Float_Ram_STEP/FrameUpperHorizontalProfile.STEP
Float_Ram_STEP/CamFollowerMechGuide.STEP
Float_Ram_STEP/MeteringBoxHolder.STEP
Float_Ram_STEP/CamFollowerMechBearingSpacer.STEP
Float_Ram_STEP/PressRollerSupport.STEP
Float_Ram_STEP/FloatingMoldBottomScrew.STEP
Float_Ram_STEP/FloatingMoldFrontPlate.STEP
Float_Ram_STEP/MeteringBox.STEP
Float_Ram_STEP/MeteringBoxAdjustingScrew.STEP
Float_Ram_STEP/Nut_M14.STEP
Float_Ram_STEP/SKF_Support_roller_nutr_4090_a_0_06.STEP
Float_Ram_STEP/Screw_M12x180_CSH-ST-M12-180.STEP
Float_Ram_STEP/Screw_M14x200_CSH-ST-M12-180.STEP
Float_Ram_STEP/SpringWasher.STEP
Float_Ram_STEP/hex nut gradec_iso_ISO - 4034 - M16 - C.STEP
Float_Ram_STEP/plain washer large_din_Washer DIN 9021 - 13.STEP
Float_Ram_STEP/prevailing torque nut style 1 insert_din_DIN EN ISO 7040 - M10 - N.STEP
Float_Ram_STEP/socket head cap screw 4762_din_EN ISO 4762 M8 x 30 - 30N.STEP
Float_Ram_STEP/socket head cap screw_iso_ISO 4762 M10 x 20 - 20N.STEP
Float_Ram_STEP/socket head cap screw_iso_ISO 4762 M10 x 25 - 25C.STEP
Float_Ram_STEP/socket head cap screw_iso_ISO 4762 M10 x 30 - 30C.STEP
Float_Ram_STEP/socket head cap screw_iso_ISO 4762 M10 x 35 - 35C.STEP
Float_Ram_STEP/socket head cap screw_iso_ISO 4762 M12 x 45 - 45C.STEP
Float_Ram_STEP/socket head cap screw_iso_ISO 4762 M12 x 70 - 36N.STEP
Float_Ram_STEP/socket head cap screw_iso_ISO 4762 M16 x 45 - 45C.STEP
Float_Ram_STEP/socket set screw cup point_iso_ISO 4029 - M10 x 30-C.STEP
Float_Ram_SW2024/FloatingMoldBottomScrew.SLDPRT
Float_Ram_SW2024/MeteringBoxAdjustingScrew.SLDPRT
Float_Ram_SW2024/Nut_M14.SLDPRT
Float_Ram_SW2024/PlainWasherLarge_M12.sldprt
Float_Ram_SW2024/Screw_M12x180.SLDPRT
Float_Ram_SW2024/Screw_M14x200.SLDPRT
Float_Ram_SW2024/SpringWasher.SLDPRT
