seromedises-PoliTo/Float-Ram-main/Technical_Drawings/Assembly_2nd_MeteringBox.pdf

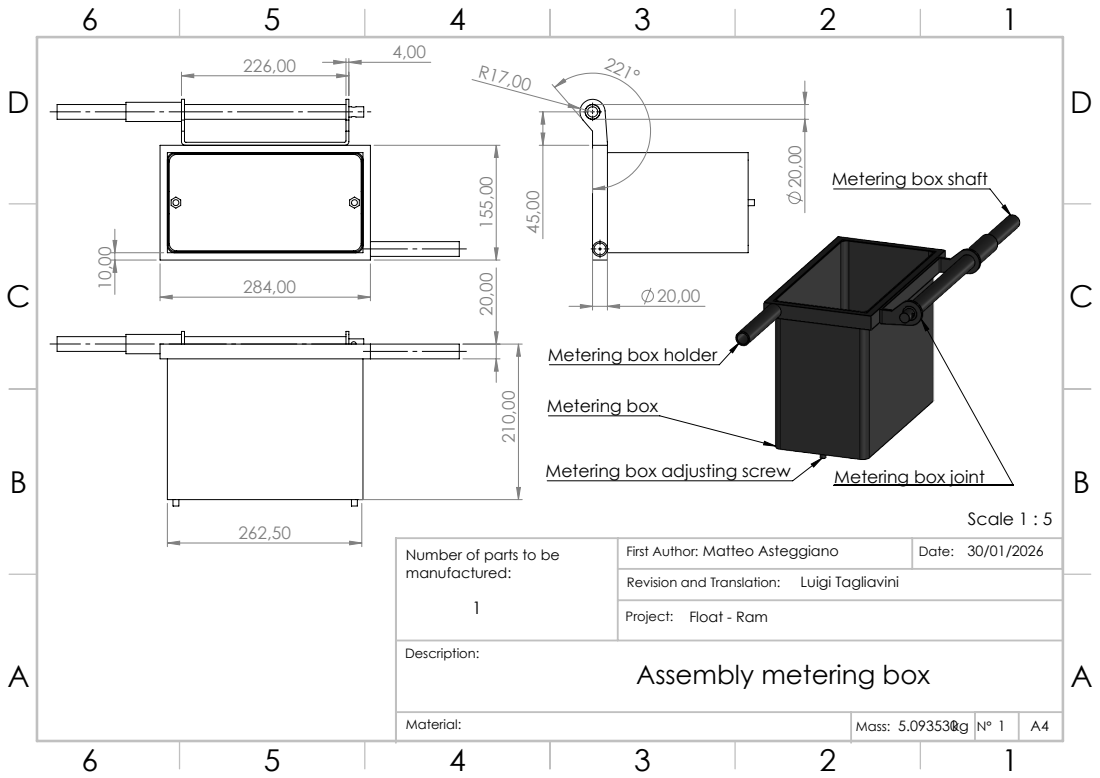
[picture p83: page 1]
Metering box; Material:; Mass: 5.093530kg; Scale 1 : 5

Metering box shaft

Metering box holder

Metering box adjusting screw

Metering box joint

Number of parts to be
manufactured:

First Author: Matteo Asteggiano
Revision and Translation: Luigi Tagliavini
Project: Float - Ram
Assembly metering box
