seromedises-PoliTo/Float-Ram-main/Technical_Drawings/CamFollowerMechGuide.pdf

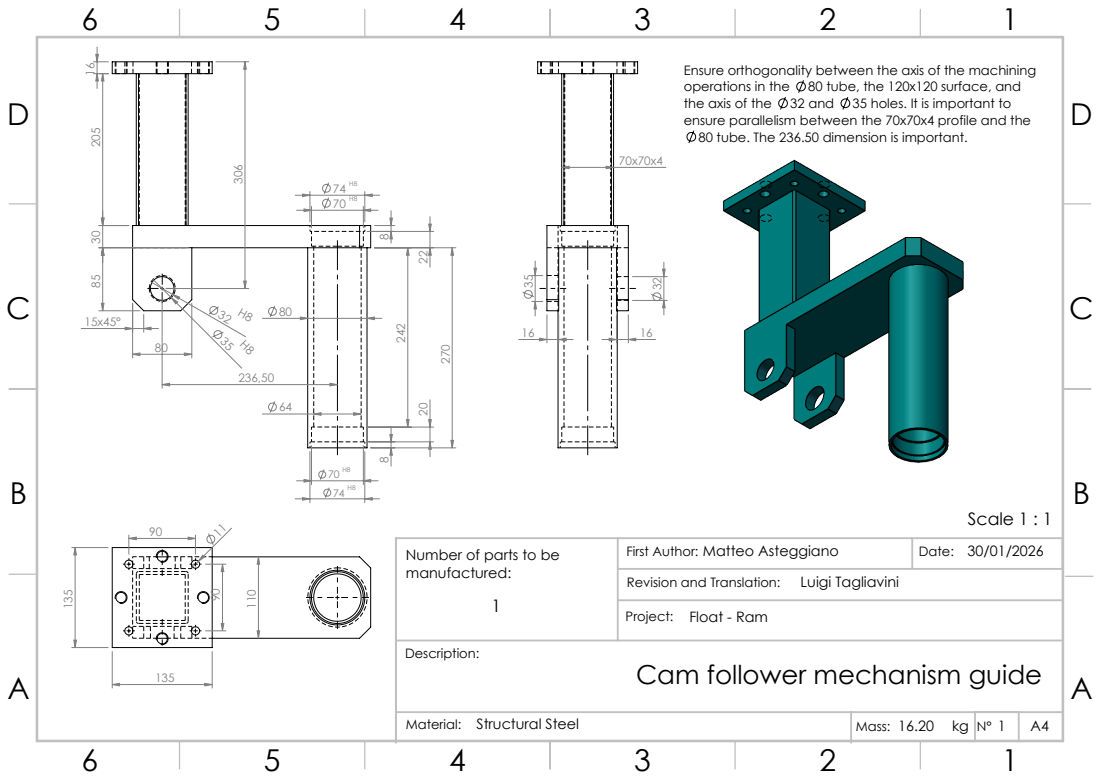
[picture p84: page 1]
Material: Structural Steel; Mass: 16.20 kg; Scale 1 : 1

Ensure orthogonality between the axis of the machining
operations in the 80 tube, the 120x120 surface, and
the axis of the 32 and 35 holes. It is important to
ensure parallelism between the 70x70x4 profile and the
80 tube. The 236.50 dimension is important.

Number of parts to be
manufactured:

First Author: Matteo Asteggiano
Revision and Translation: Luigi Tagliavini
Project: Float - Ram
Cam follower mechanism guide
