seromedises-PoliTo/Float-Ram-main/Technical_Drawings/FloatingMoldGuide.pdf

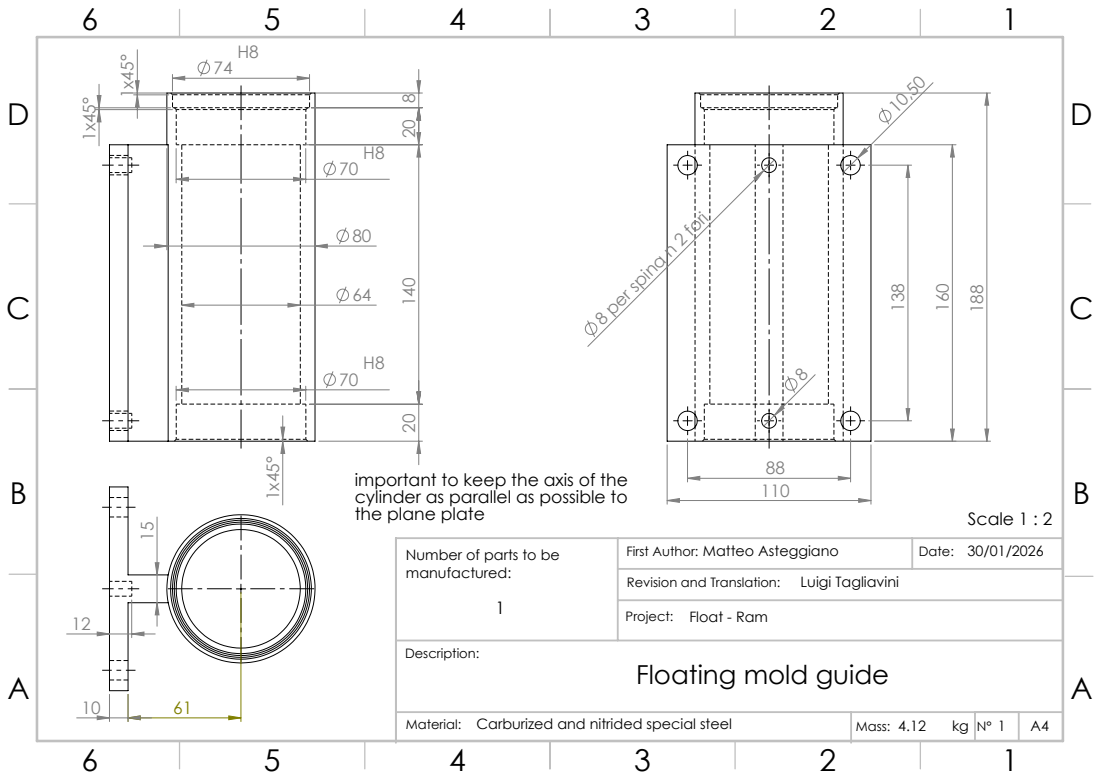
[picture p85: page 1]
Material: Carburized and nitrided special steel; Mass: 4.12; Scale 1 : 2

8 per spina n 2 fori

important to keep the axis of the
cylinder as parallel as possible to
the plane plate

Number of parts to be
manufactured:

First Author: Matteo Asteggiano
Revision and Translation: Luigi Tagliavini
Project: Float - Ram
Floating mold guide
