seromedises-PoliTo/Float-Ram-main/Technical_Drawings/AxialRadialBushing.pdf

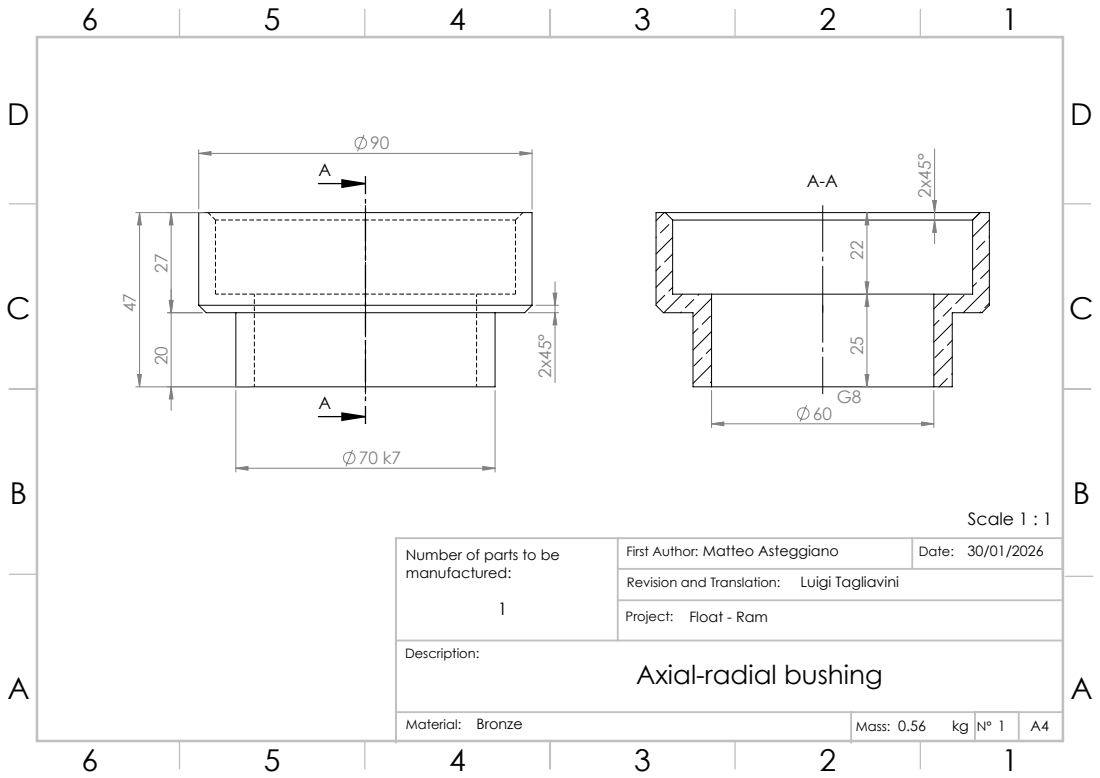
[picture p86: page 1]
Material: Bronze; Mass: 0.56; Scale 1 : 1

Number of parts to be
manufactured:

First Author: Matteo Asteggiano
Revision and Translation: Luigi Tagliavini
Project: Float - Ram
Axial-radial bushing
