seromedises-PoliTo/Float-Ram-main/Technical_Drawings/CamFollowerMechBearingSpacer.pdf

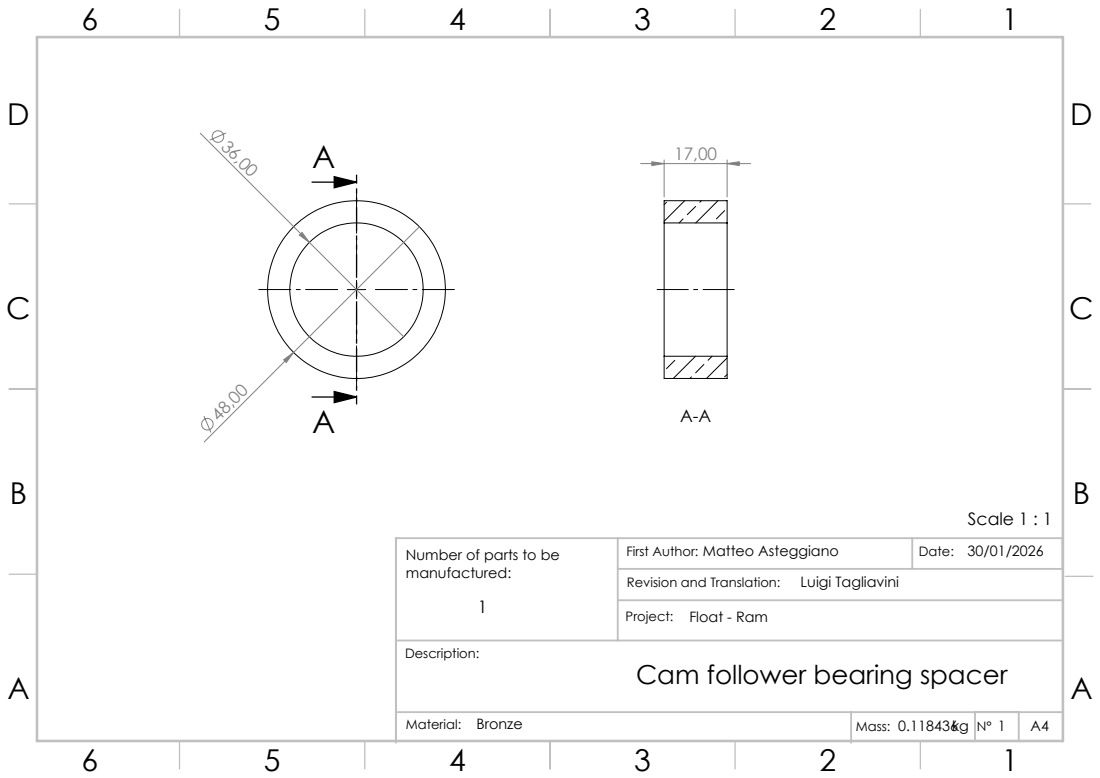
[picture p87: page 1]
Material: Bronze; Mass: 0.118436kg; Scale 1 : 1

Number of parts to be
manufactured:

First Author: Matteo Asteggiano
Revision and Translation: Luigi Tagliavini
Project: Float - Ram
Cam follower bearing spacer
