seromedises-PoliTo/Float-Ram-main/Technical_Drawings/CamFollowerMechHolder.pdf

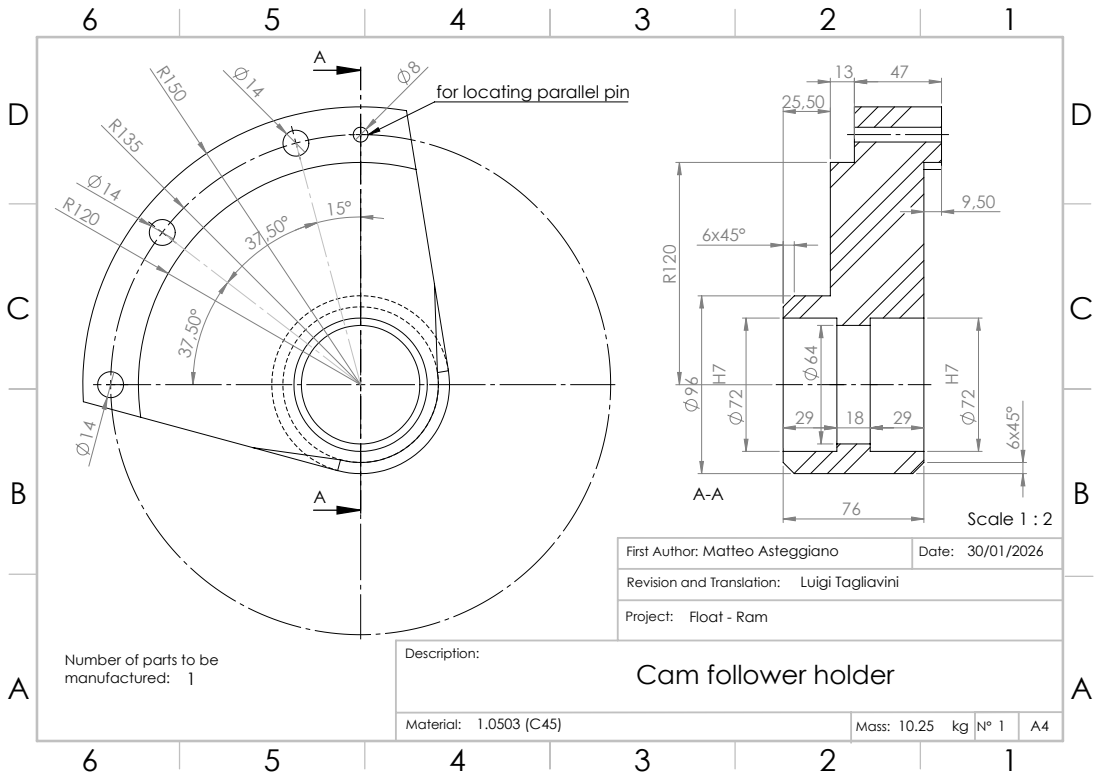
[picture p88: page 1]
Material: 1.0503 (C45); Mass: 10.25 kg; Scale 1 : 2

for locating parallel pin

First Author: Matteo Asteggiano
Revision and Translation: Luigi Tagliavini
Project: Float - Ram
Cam follower holder

Number of parts to be
manufactured:
