seromedises-PoliTo/Float-Ram-main/Technical_Drawings/ExpulsionCam.pdf

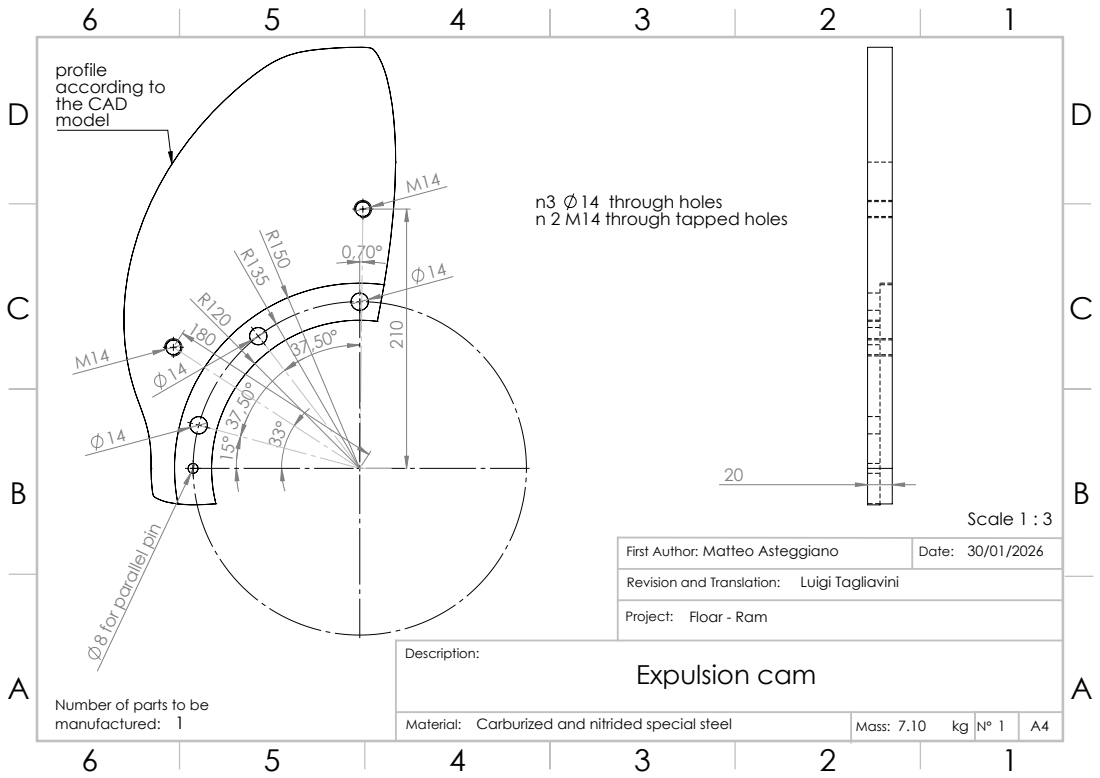
[picture p90: page 1]
according to the CAD; Material: Carburized and nitrided special steel; Mass: 7.10; Scale 1 : 3

n3 14 through holes
n 2 M14 through tapped holes

8 for parallel pin

First Author: Matteo Asteggiano
Revision and Translation: Luigi Tagliavini
Project: Floar - Ram
Expulsion cam

Number of parts to be
manufactured:
