seromedises-PoliTo/Float-Ram-main/Technical_Drawings/FloatingMoldBackPlate.pdf

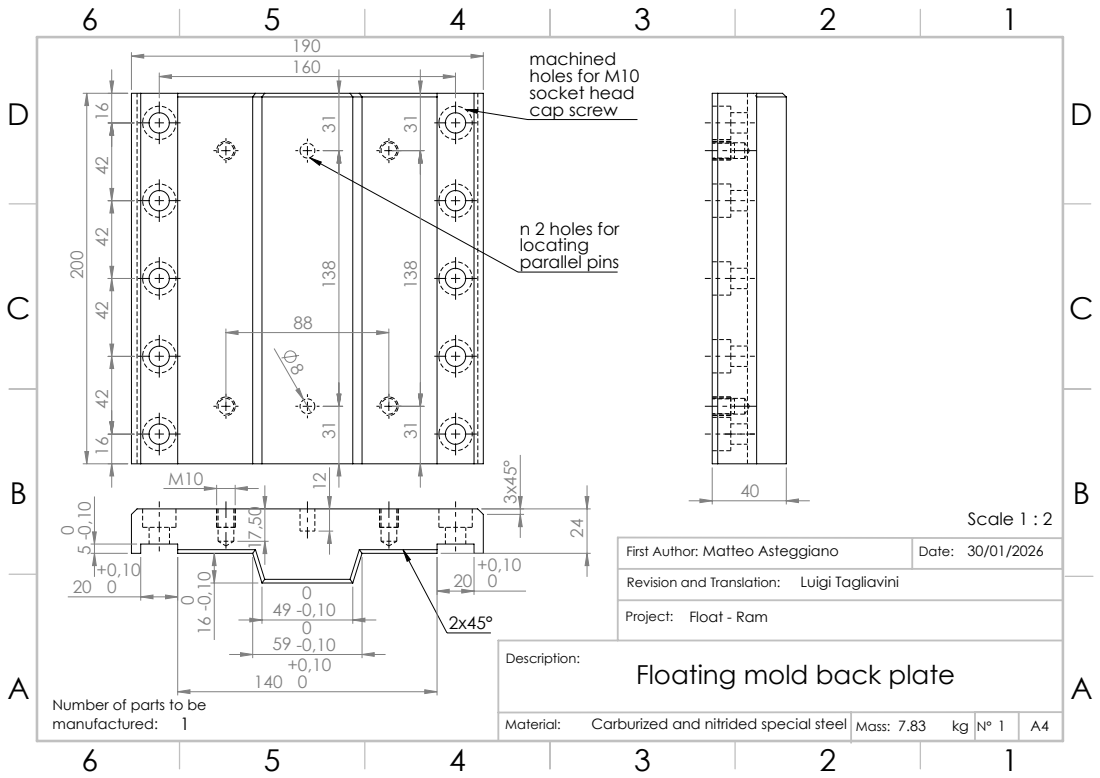
[picture p92: page 1]
holes for M10 socket head cap screw; n 2 holes for parallel pins; Floating mold back plate Description:; Material:; Carburized and nitrided special steel; Mass: 7.83; Scale 1 : 2

First Author: Matteo Asteggiano
Revision and Translation: Luigi Tagliavini
Project: Float - Ram

Number of parts to be
manufactured:
