seromedises-PoliTo/Float-Ram-main/Technical_Drawings/FloatingMoldBottomScrew.pdf

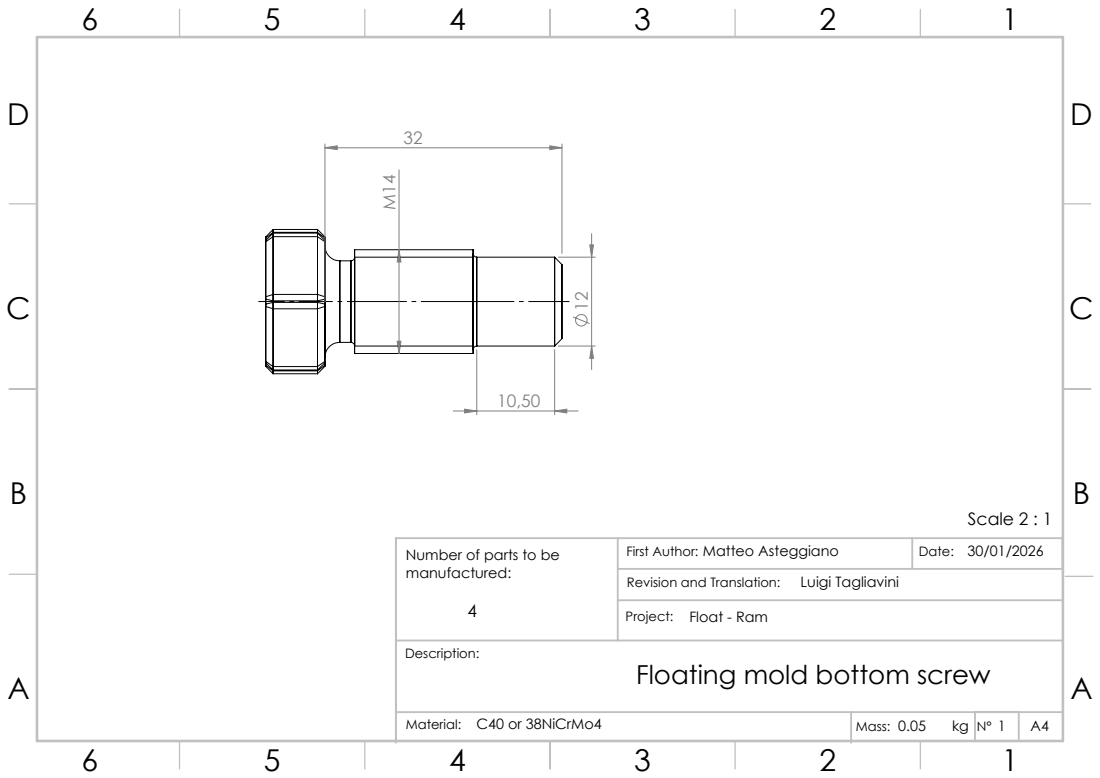
[picture p93: page 1]
Material: C40 or 38NiCrMo4; Mass: 0.05; Scale 2 : 1

Number of parts to be
manufactured:

First Author: Matteo Asteggiano
Revision and Translation: Luigi Tagliavini
Project: Float - Ram
Floating mold bottom screw
