seromedises-PoliTo/Float-Ram-main/Technical_Drawings/FloatingMoldFrontPlate.pdf

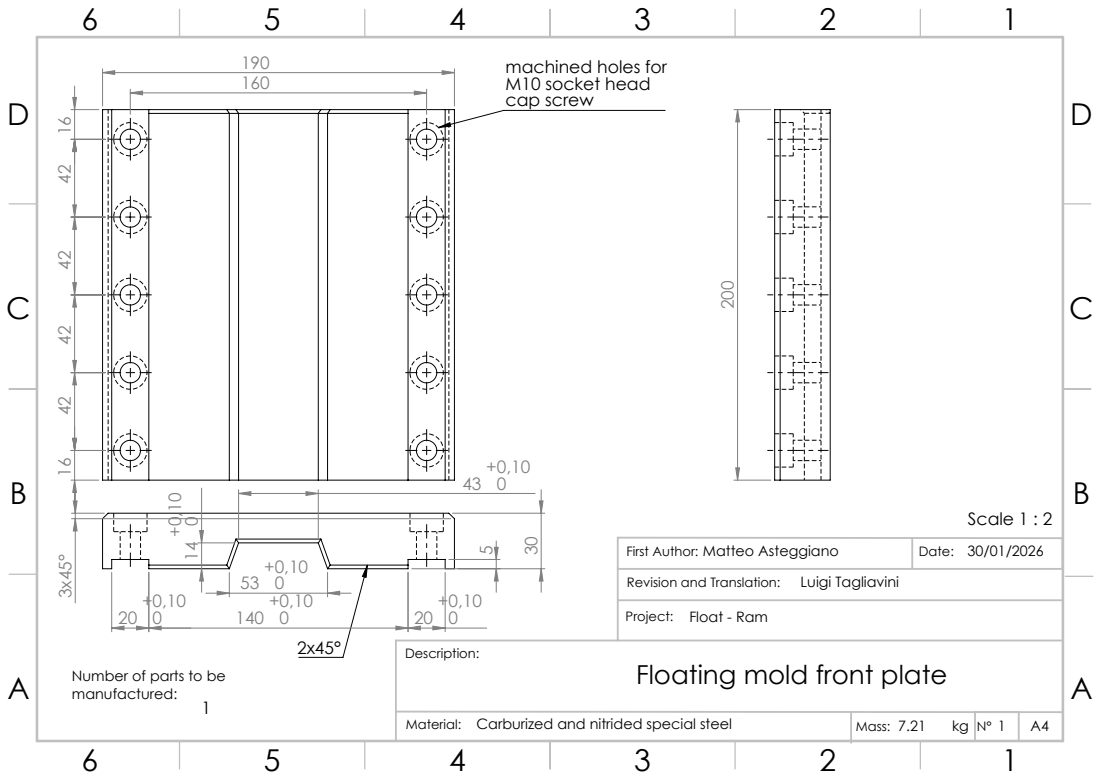
[picture p94: page 1]
machined holes for; M10 socket head cap screw 30; Material: Carburized and nitrided special steel; Mass: 7.21; Scale 1 : 2

First Author: Matteo Asteggiano
Revision and Translation: Luigi Tagliavini
Project: Float - Ram
Floating mold front plate

Number of parts to be
