seromedises-PoliTo/Float-Ram-main/Technical_Drawings/FloatingMoldLateralPlate.pdf

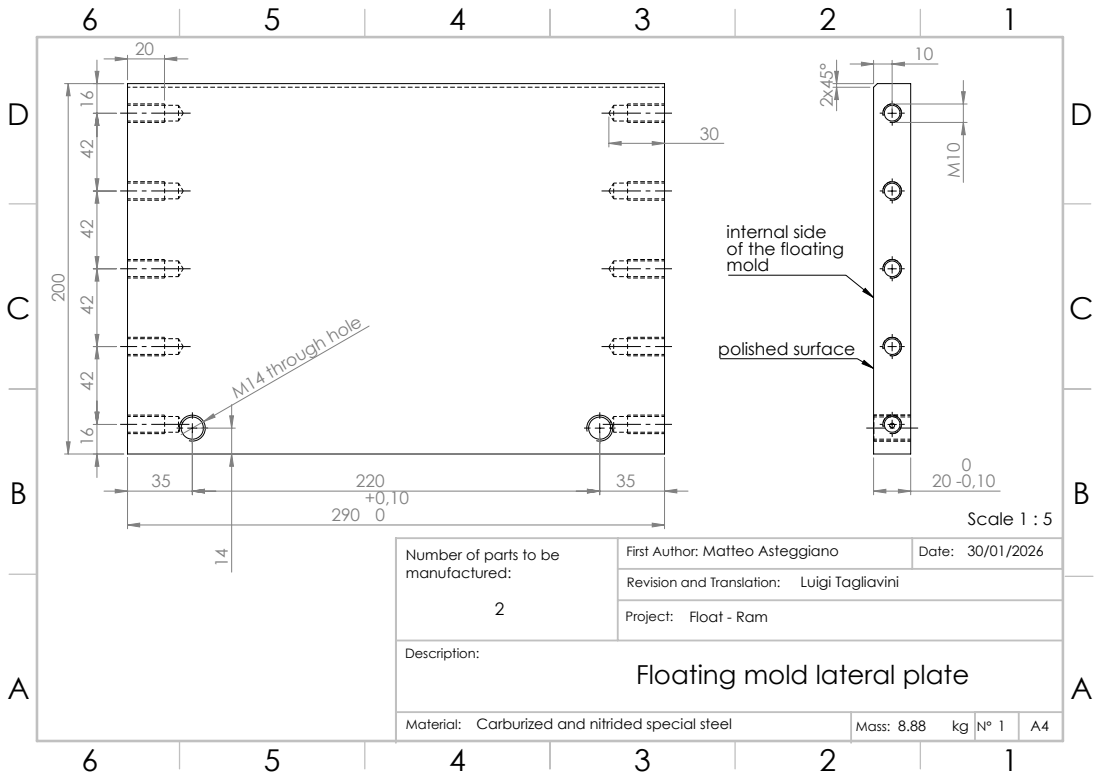
[picture p95: page 1]
M14 through hole; polished surface; Material: Carburized and nitrided special steel; Mass: 8.88; Scale 1 : 5

internal side
of the floating
mold

Number of parts to be
manufactured:

First Author: Matteo Asteggiano
Revision and Translation: Luigi Tagliavini
Project: Float - Ram
Floating mold lateral plate
