seromedises-PoliTo/Float-Ram-main/Technical_Drawings/FrameLowerHorizontalProfile.pdf

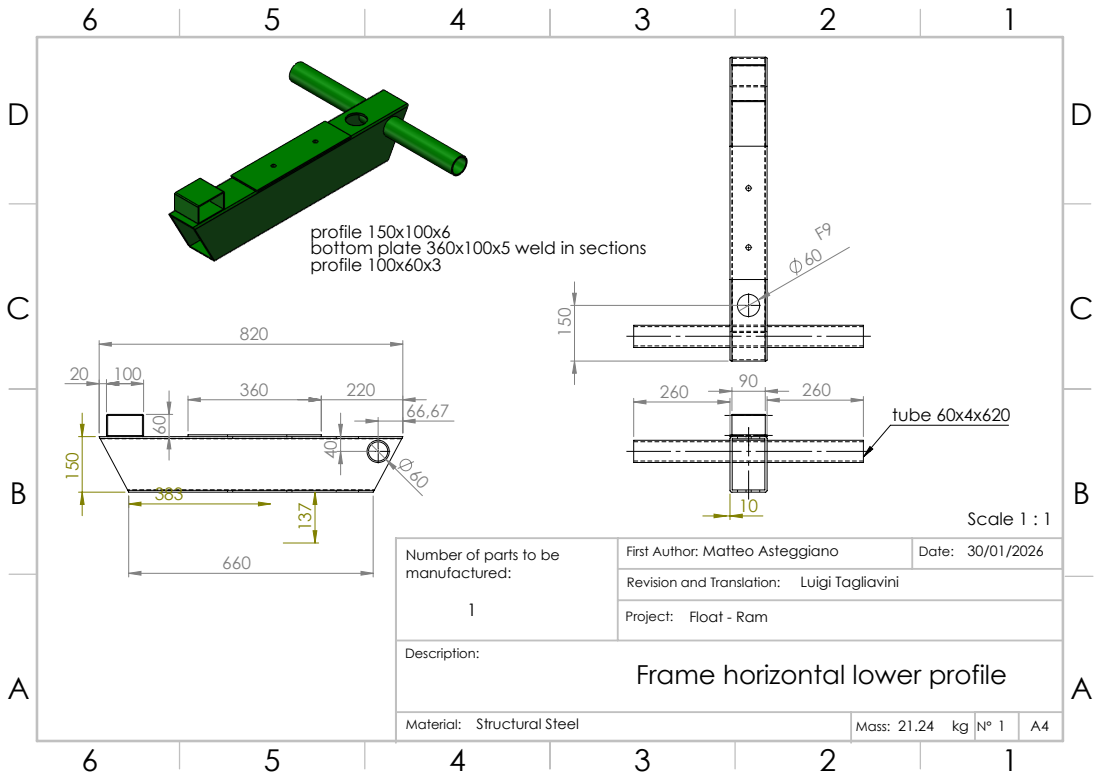
[picture p96: page 1]
tube 60x4x620; Material: Structural Steel; Mass: 21.24 kg; Scale 1 : 1

profile 150x100x6
bottom plate 360x100x5 weld in sections
profile 100x60x3

Number of parts to be
manufactured:

First Author: Matteo Asteggiano
Revision and Translation: Luigi Tagliavini
Project: Float - Ram
Frame horizontal lower profile
