seromedises-PoliTo/Float-Ram-main/Technical_Drawings/FrameUpperHorizontalProfile.pdf

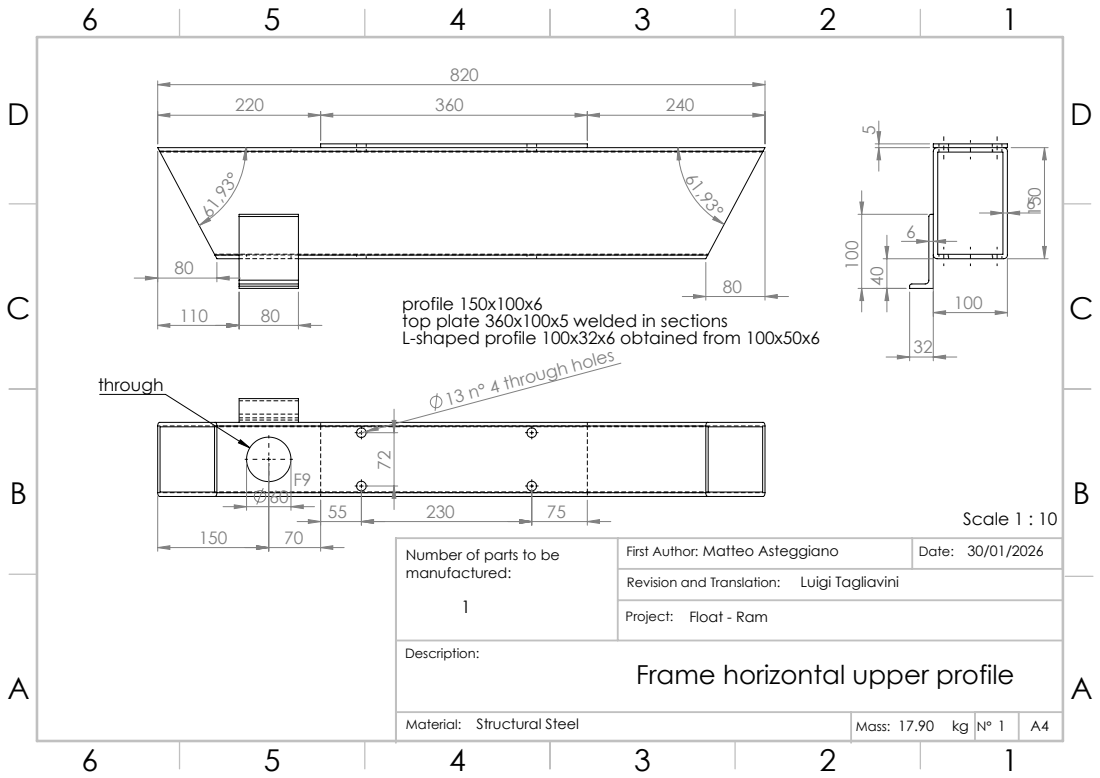
[picture p97: page 1]
13 n° 4 through holes; Material: Structural Steel; Mass: 17.90 kg; Scale 1 : 10

profile 150x100x6
top plate 360x100x5 welded in sections
L-shaped profile 100x32x6 obtained from 100x50x6

Number of parts to be
manufactured:

First Author: Matteo Asteggiano
Revision and Translation: Luigi Tagliavini
Project: Float - Ram
Frame horizontal upper profile
