seromedises-PoliTo/Float-Ram-main/Technical_Drawings/FrameVerticalBackProfile.pdf

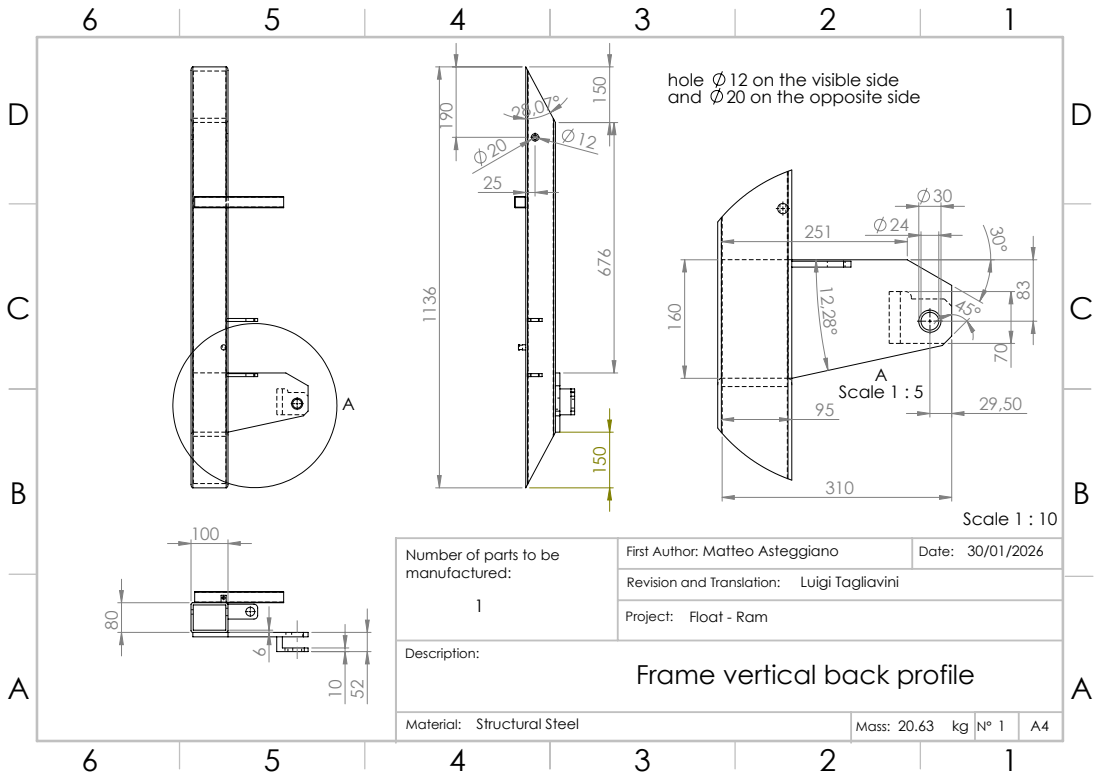
[picture p98: page 1]
Scale 1 : 5; Material: Structural Steel; Mass: 20.63 kg; Scale 1 : 10

hole 12 on the visible side
and 20 on the opposite side

Number of parts to be
manufactured:

First Author: Matteo Asteggiano
Revision and Translation: Luigi Tagliavini
Project: Float - Ram
Frame vertical back profile

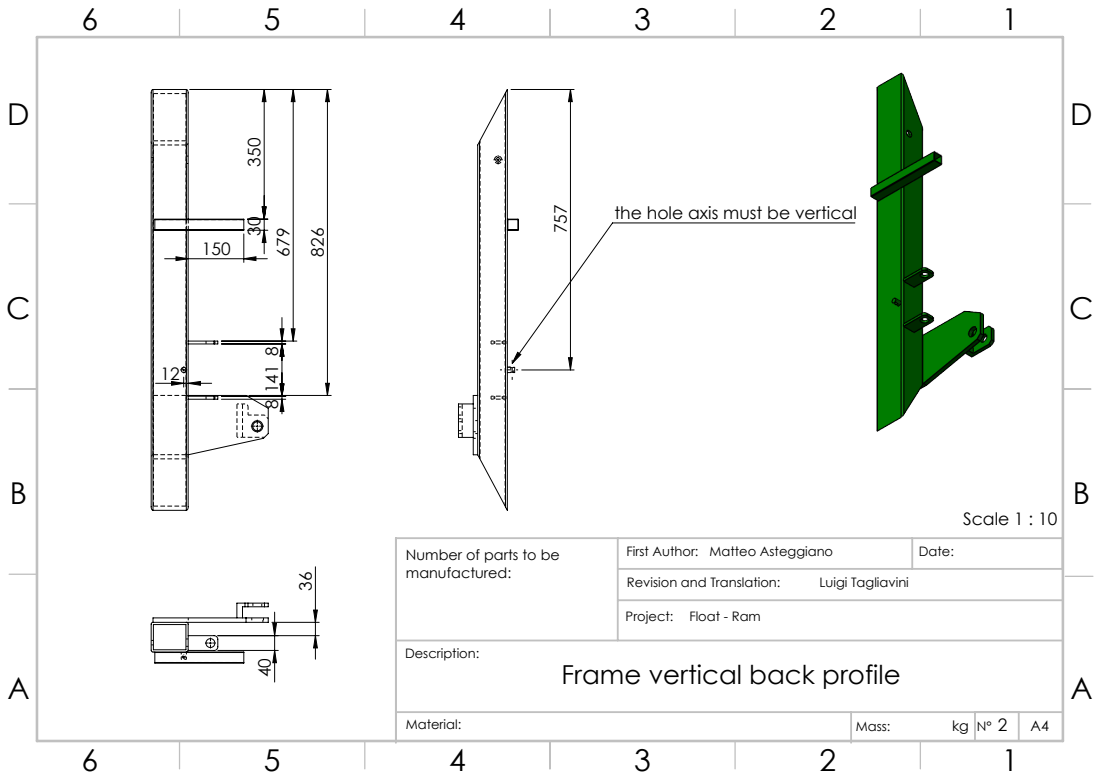
[picture p99: page 2]
Scale 1 : 10; Matteo Asteggiano; Luigi Tagliavini; Float - Ram

the hole axis must be vertical

Number of parts to be
manufactured:

First Author:
Revision and Translation:

Project:
Frame vertical back profile
