seromedises-PoliTo/Float-Ram-main/Technical_Drawings/FrameVerticalFrontProfile.pdf

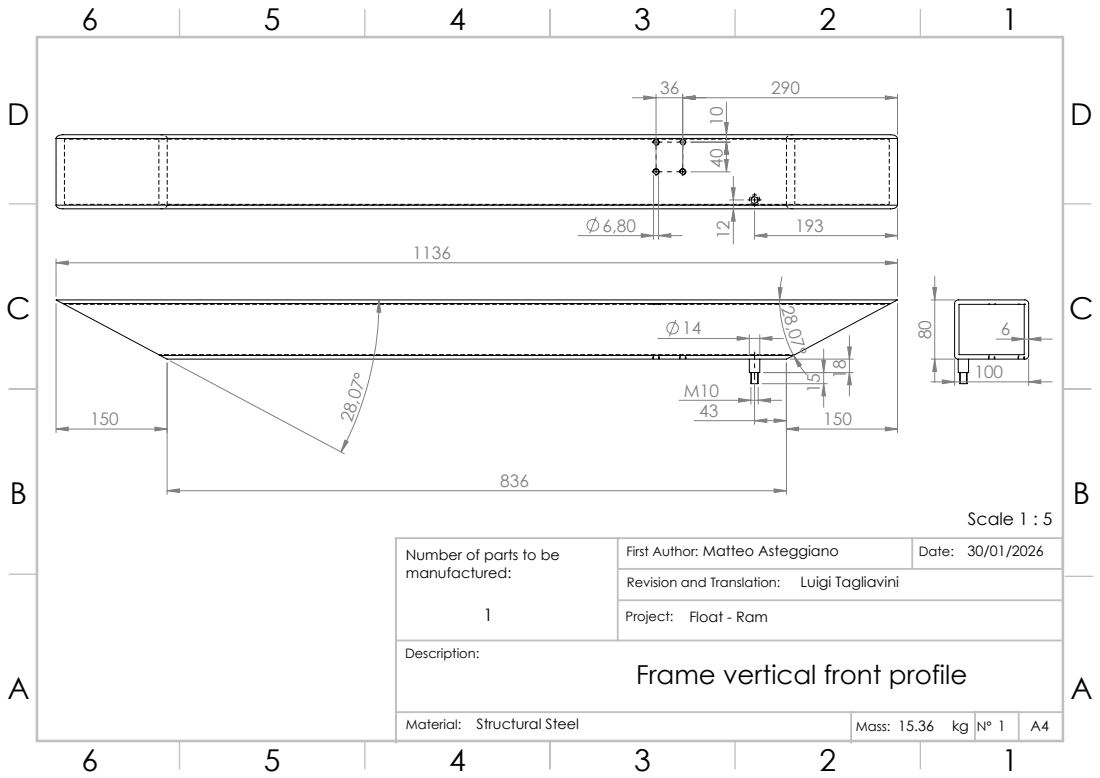
[picture p100: page 1]
Material: Structural Steel; Mass: 15.36 kg; Scale 1 : 5

Number of parts to be
manufactured:

First Author: Matteo Asteggiano
Revision and Translation: Luigi Tagliavini
Project: Float - Ram
Frame vertical front profile
