seromedises-PoliTo/Float-Ram-main/Technical_Drawings/LateralFoot.pdf

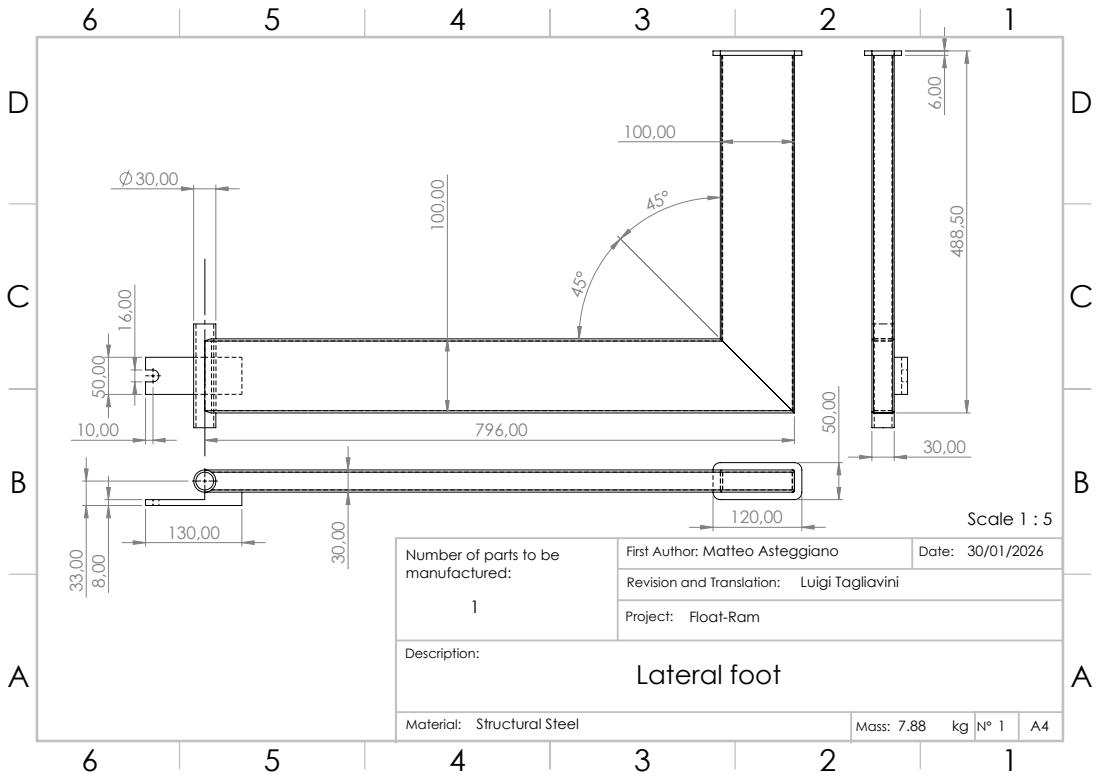
[picture p101: page 1]
Material: Structural Steel; Mass: 7.88; Scale 1 : 5

Number of parts to be
manufactured:

First Author: Matteo Asteggiano
Revision and Translation: Luigi Tagliavini
Project: Float-Ram
Lateral foot
