seromedises-PoliTo/Float-Ram-main/Technical_Drawings/LateralFootAxis.pdf

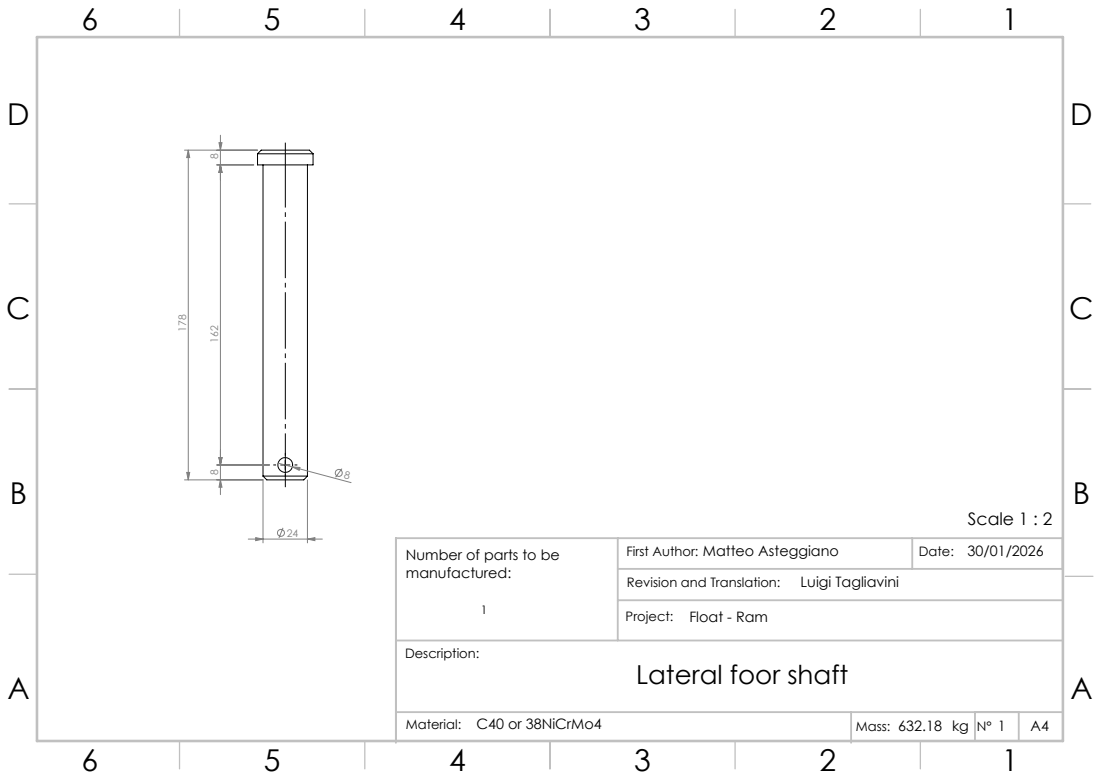
[picture p102: page 1]
Material: C40 or 38NiCrMo4; Mass: 632.18 kg; Scale 1 : 2

Number of parts to be
manufactured:

First Author: Matteo Asteggiano
Revision and Translation: Luigi Tagliavini
Project: Float - Ram
Lateral foor shaft
