seromedises-PoliTo/Float-Ram-main/Technical_Drawings/LateralFootLockingLever.pdf

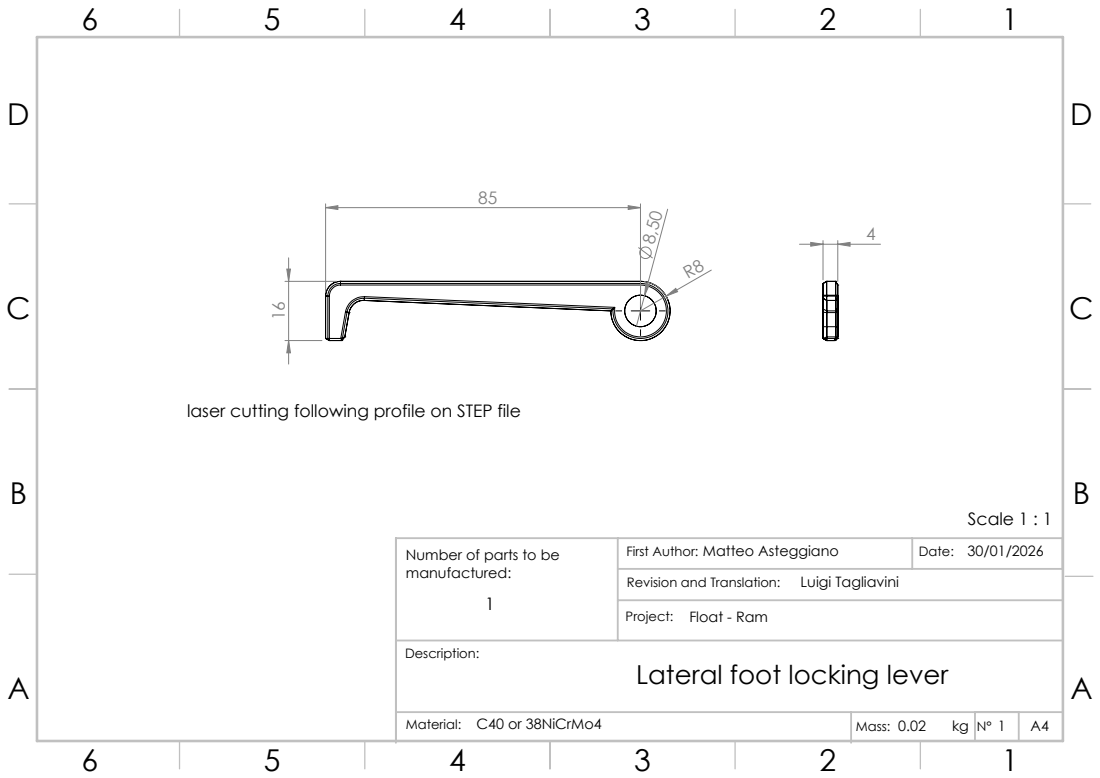
[picture p103: page 1]
Material: C40 or 38NiCrMo4; Mass: 0.02; Scale 1 : 1

laser cutting following profile on STEP file

Number of parts to be
manufactured:

First Author: Matteo Asteggiano
Revision and Translation: Luigi Tagliavini
Project: Float - Ram
Lateral foot locking lever
