seromedises-PoliTo/Float-Ram-main/Technical_Drawings/LevelExtension.pdf

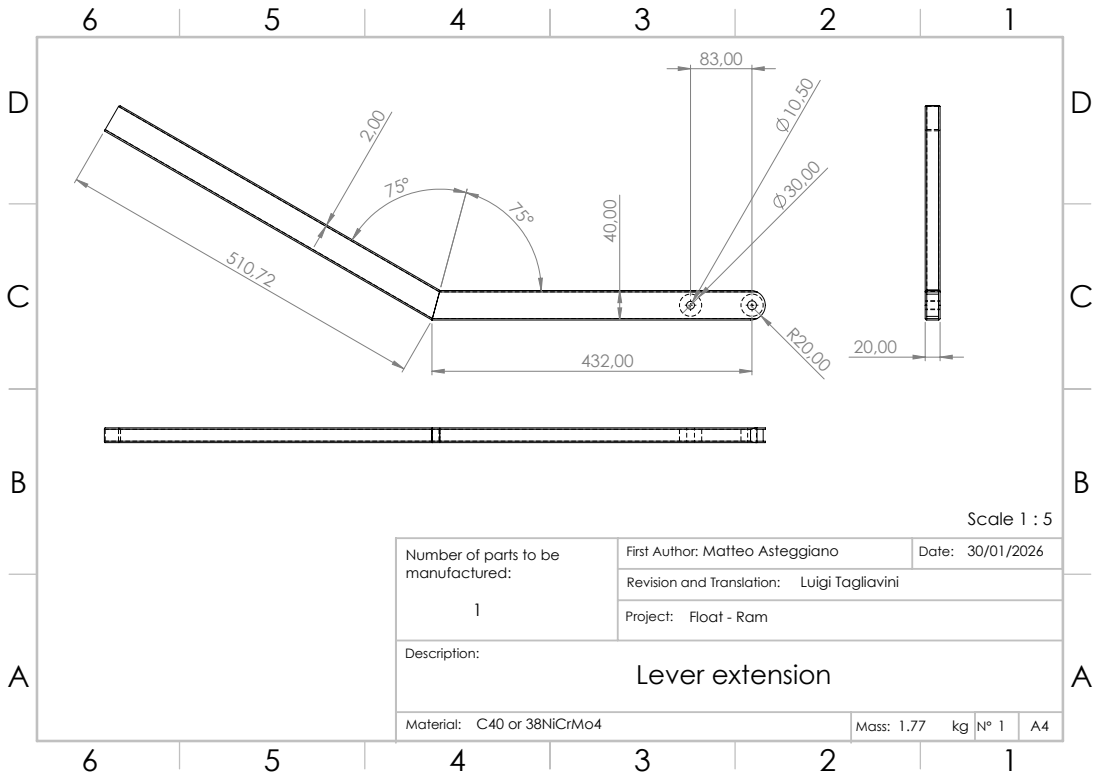
[picture p104: page 1]
Material: C40 or 38NiCrMo4; Mass: 1.77; Scale 1 : 5

Number of parts to be
manufactured:

First Author: Matteo Asteggiano
Revision and Translation: Luigi Tagliavini
Project: Float - Ram
Lever extension
