seromedises-PoliTo/Float-Ram-main/Technical_Drawings/Lever.pdf

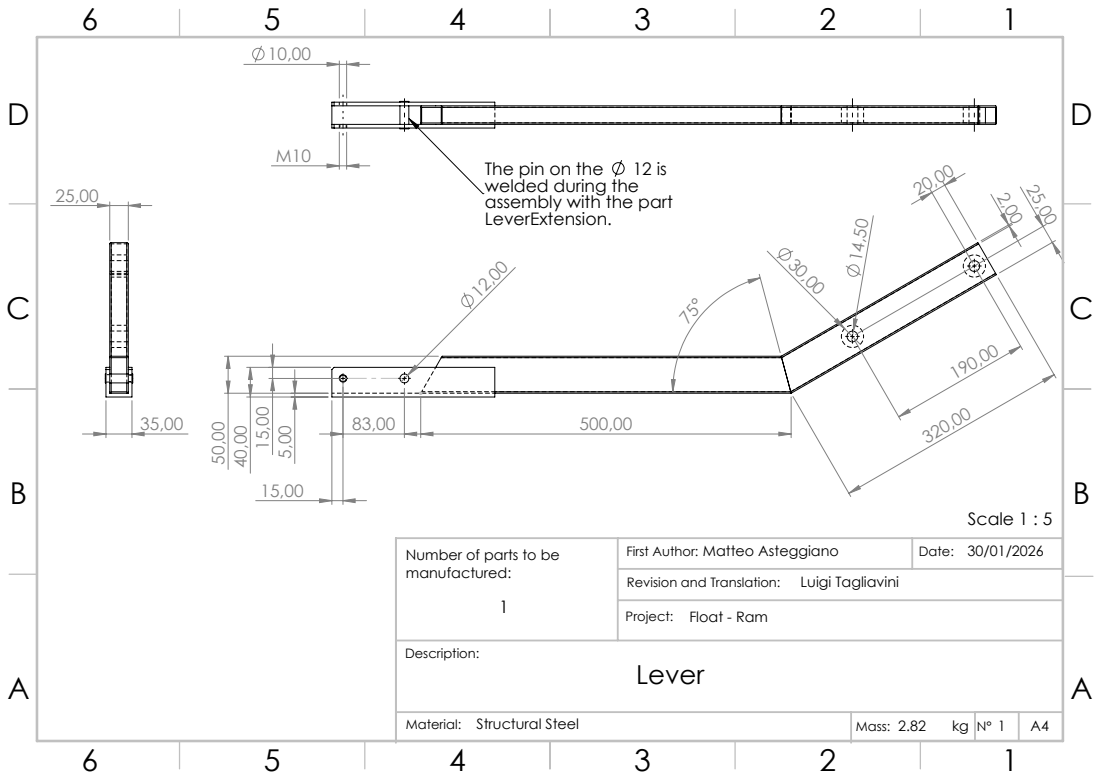
[picture p105: page 1]
The pin on the; Material: Structural Steel; Mass: 2.82; Scale 1 : 5

welded during the
assembly with the part
LeverExtension.

Number of parts to be
manufactured:

First Author: Matteo Asteggiano
Revision and Translation: Luigi Tagliavini
Project: Float - Ram
Lever
