seromedises-PoliTo/Float-Ram-main/Technical_Drawings/LeverLock.pdf

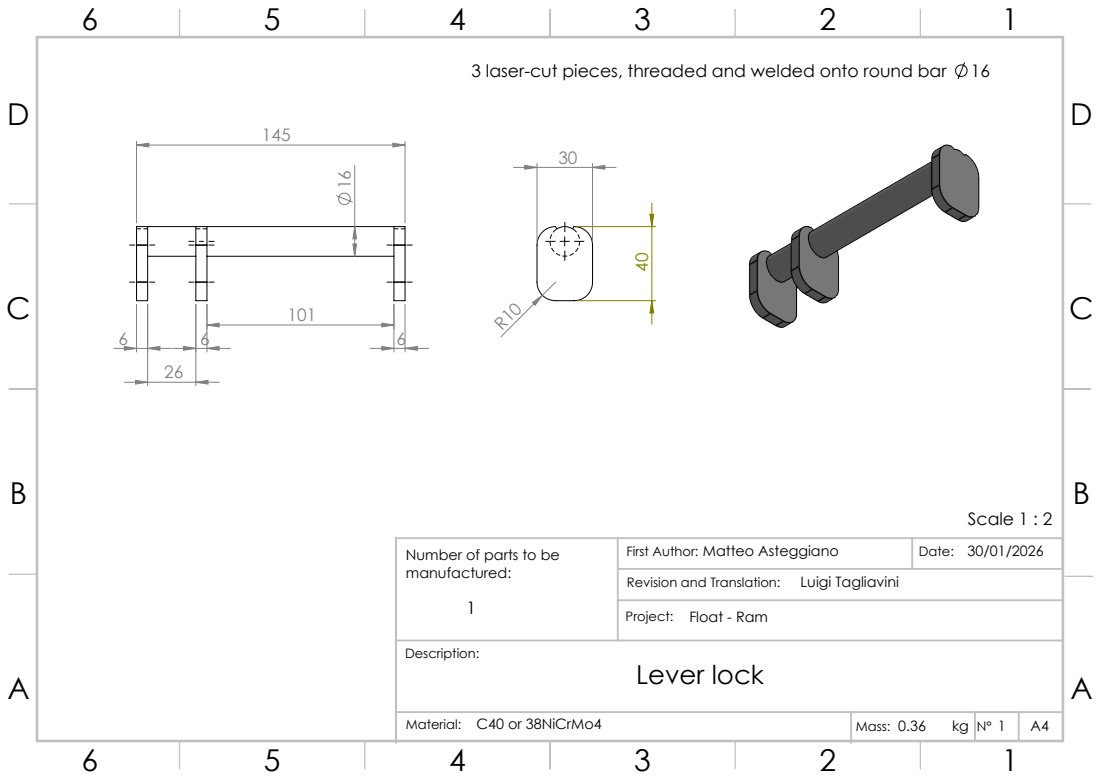
[picture p106: page 1]
Material: C40 or 38NiCrMo4; Mass: 0.36; Scale 1 : 2

3 laser-cut pieces, threaded and welded onto round bar 16

Number of parts to be
manufactured:

First Author: Matteo Asteggiano
Revision and Translation: Luigi Tagliavini
Project: Float - Ram
Lever lock
