seromedises-PoliTo/Float-Ram-main/Technical_Drawings/MeteringBoxShaft.pdf

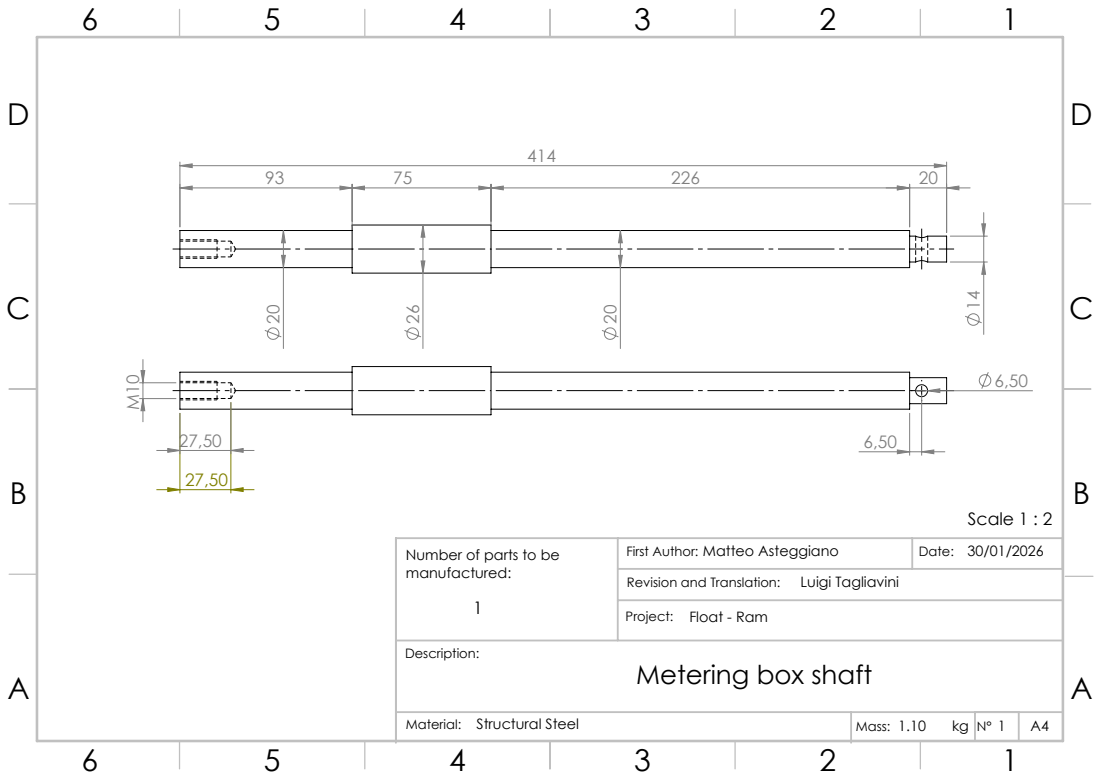
[picture p108: page 1]
Material: Structural Steel; Mass: 1.10; Scale 1 : 2

Number of parts to be
manufactured:

First Author: Matteo Asteggiano
Revision and Translation: Luigi Tagliavini
Project: Float - Ram
Metering box shaft
