seromedises-PoliTo/Float-Ram-main/Technical_Drawings/MoldInsert_F.pdf

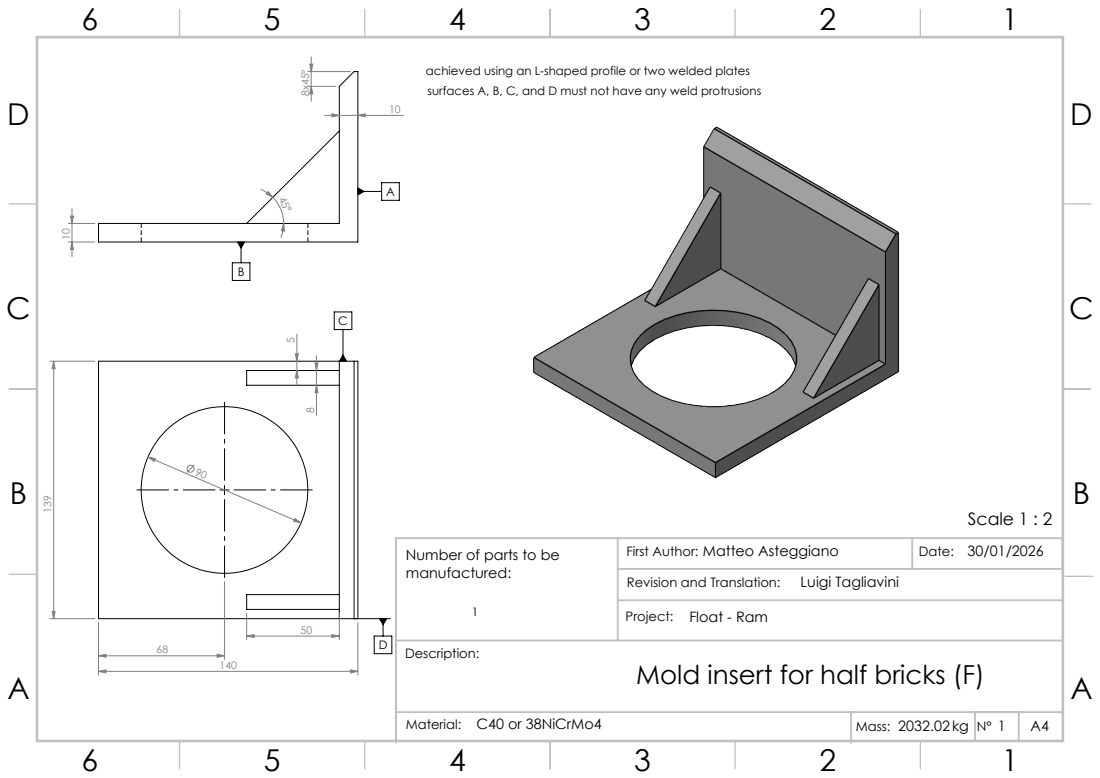
[picture p109: page 1]
Material: C40 or 38NiCrMo4; Mass: 2032.02 kg; Scale 1 : 2

achieved using an L-shaped profile or two welded plates
surfaces A, B, C, and D must not have any weld protrusions

Number of parts to be
manufactured:

First Author: Matteo Asteggiano
Revision and Translation: Luigi Tagliavini
Project: Float - Ram
Mold insert for half bricks (F)
