seromedises-PoliTo/Float-Ram-main/Technical_Drawings/MoldLowerPlate.pdf

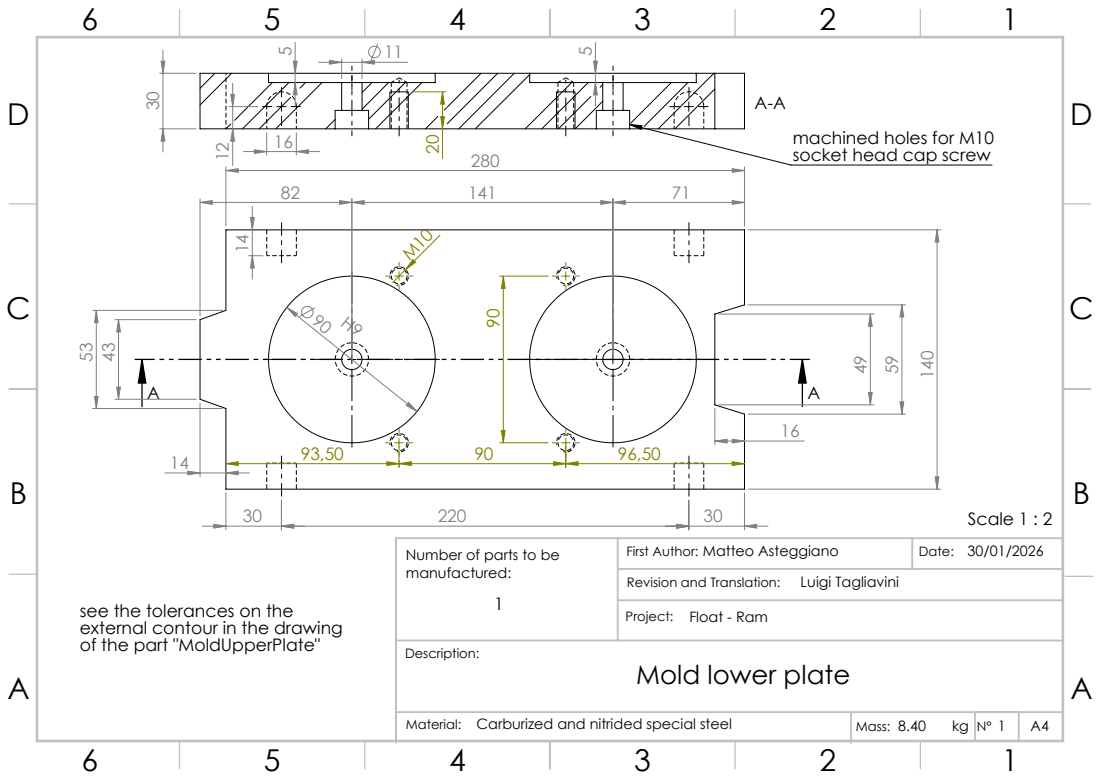
[picture p110: page 1]
Material: Carburized and nitrided special steel; Mass: 8.40; Scale 1 : 2

machined holes for M10
socket head cap screw

Number of parts to be
manufactured:

First Author: Matteo Asteggiano
Revision and Translation: Luigi Tagliavini
Project: Float - Ram
Mold lower plate

see the tolerances on the
external contour in the drawing
of the part "MoldUpperPlate"
