seromedises-PoliTo/Float-Ram-main/Technical_Drawings/MoldLowerPlateInsert.pdf

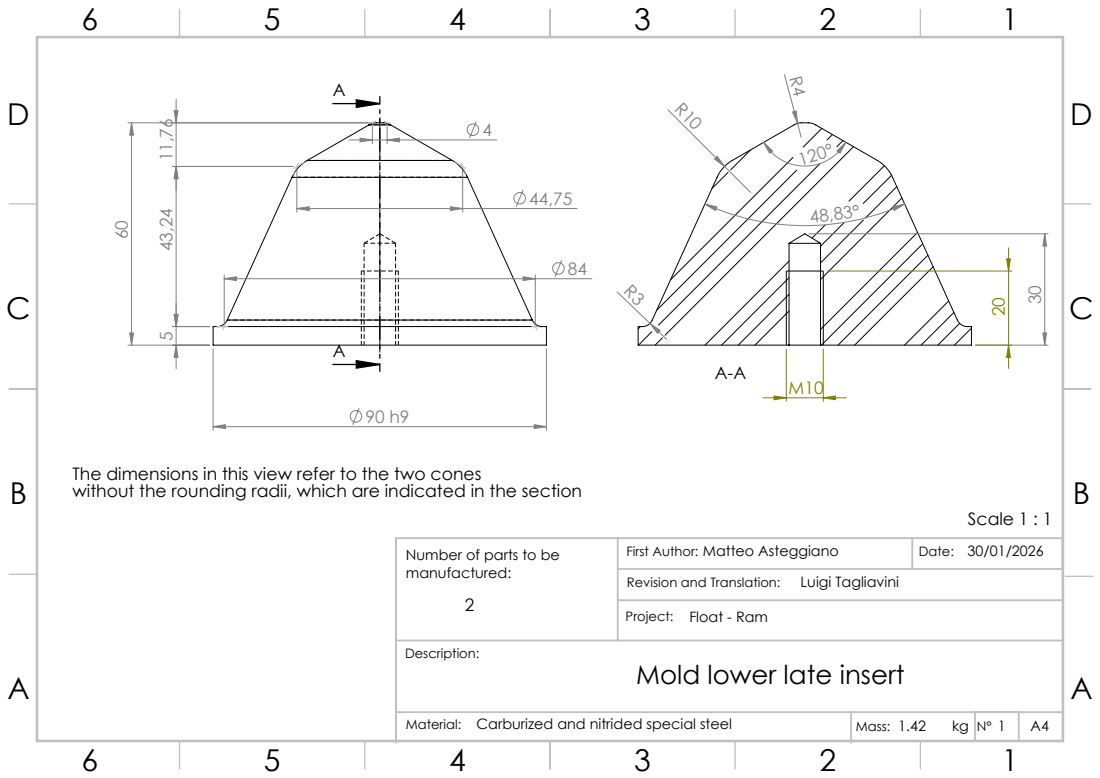
[picture p111: page 1]
Material: Carburized and nitrided special steel; Mass: 1.42; Scale 1 : 1

The dimensions in this view refer to the two cones
without the rounding radii, which are indicated in the section

Number of parts to be
manufactured:

First Author: Matteo Asteggiano
Revision and Translation: Luigi Tagliavini
Project: Float - Ram
Mold lower late insert
