seromedises-PoliTo/Float-Ram-main/Technical_Drawings/MoldUpperPlate.pdf

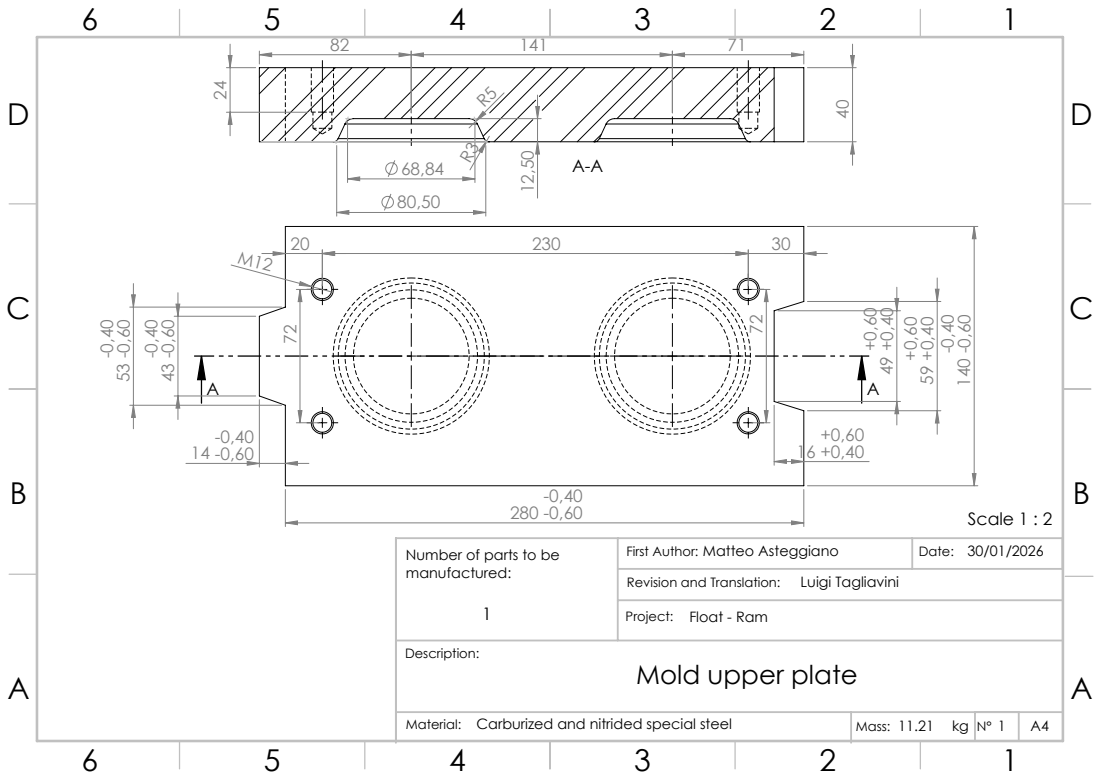
[picture p112: page 1]
Material: Carburized and nitrided special steel; Mass: 11.21 kg; Scale 1 : 2

Number of parts to be
manufactured:

First Author: Matteo Asteggiano
Revision and Translation: Luigi Tagliavini
Project: Float - Ram
Mold upper plate
