seromedises-PoliTo/Float-Ram-main/Technical_Drawings/PressCam.pdf

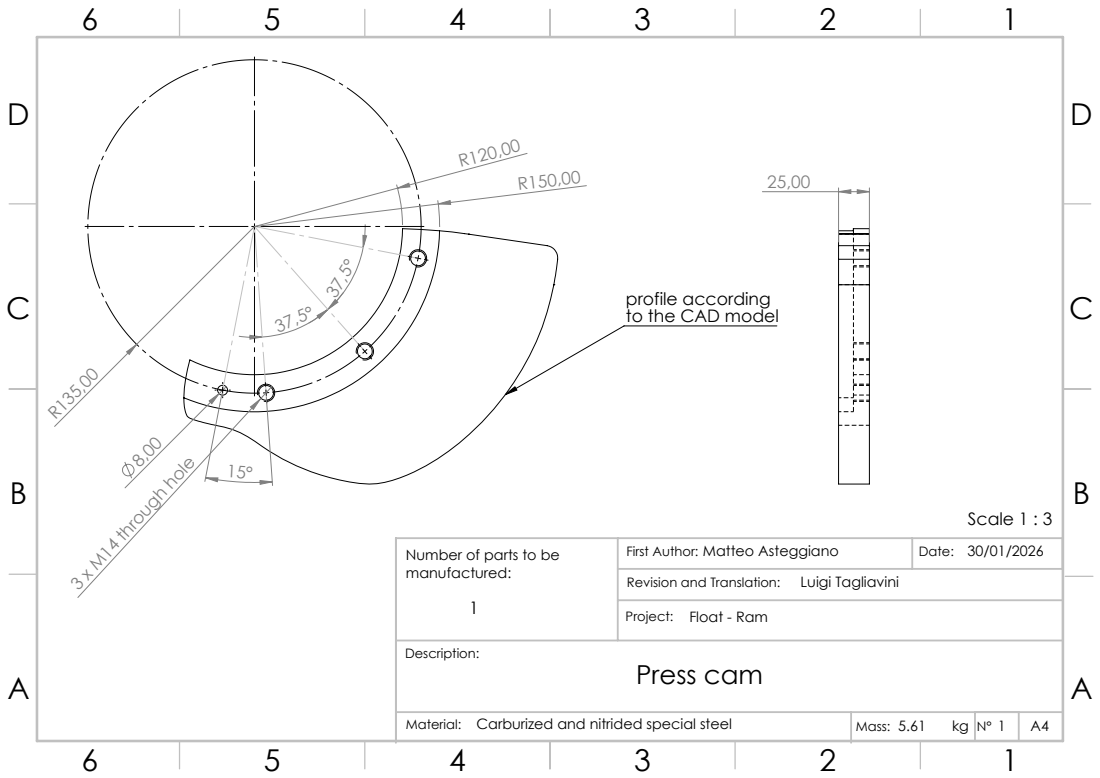
[picture p113: page 1]
3 x M14 through hole; Material: Carburized and nitrided special steel; Mass: 5.61; Scale 1 : 3

profile according
to the CAD model

Number of parts to be
manufactured:

First Author: Matteo Asteggiano
Revision and Translation: Luigi Tagliavini
Project: Float - Ram
Press cam
