seromedises-PoliTo/Float-Ram-main/Technical_Drawings/PressRollerSupport.pdf

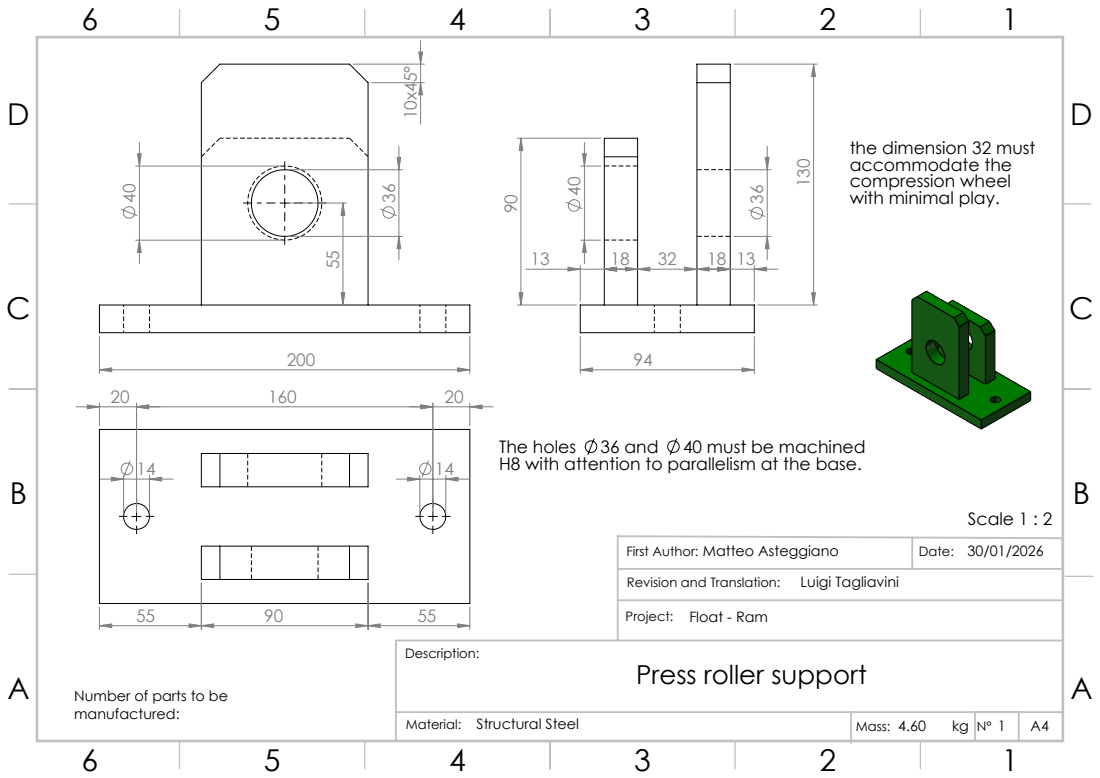
[picture p115: page 1]
Material: Structural Steel; Mass: 4.60; Scale 1 : 2

the dimension 32 must
accommodate the
compression wheel
with minimal play.

The holes 36 and 40 must be machined
H8 with attention to parallelism at the base.

First Author: Matteo Asteggiano
Revision and Translation: Luigi Tagliavini
Project: Float - Ram
Press roller support

Number of parts to be
manufactured:
