seromedises-PoliTo/Float-Ram-main/Technical_Drawings/Shaft.pdf

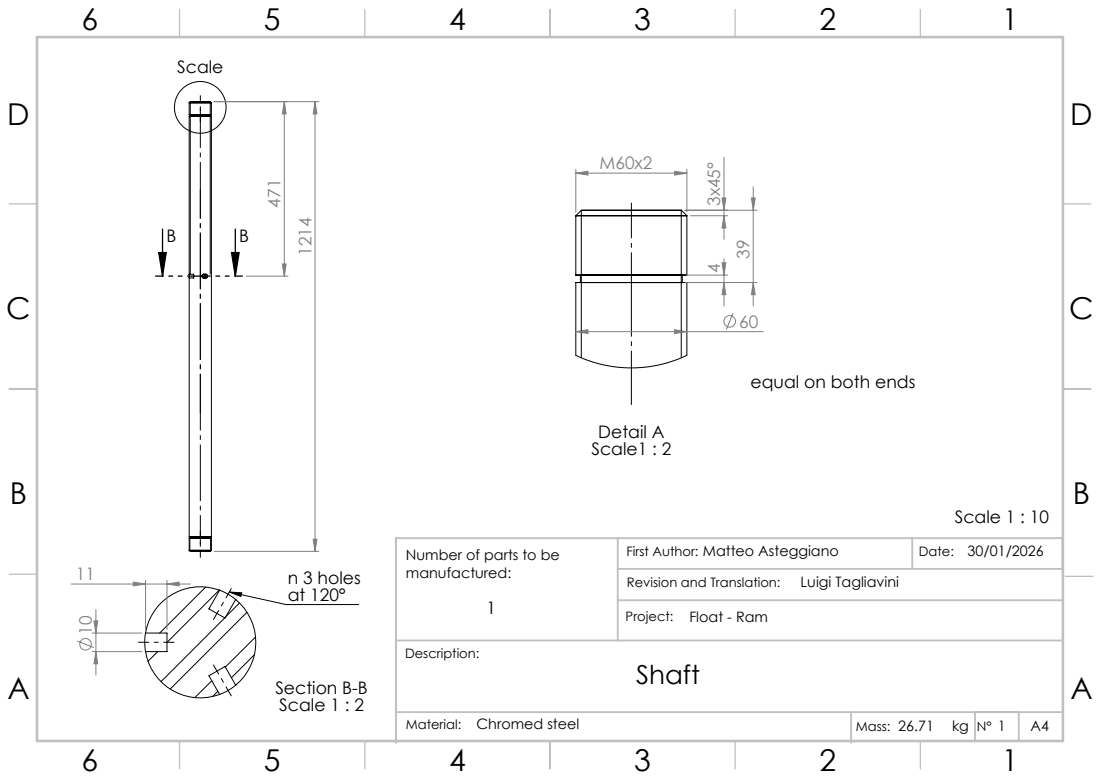
[picture p116: page 1]
Detail A Scale1 : 2; Section B-B Scale 1 : 2; n 3 holes at 120°; Material: Chromed steel; Mass: 26.71 kg; Scale 1 : 10

equal on both ends

Number of parts to be
manufactured:

First Author: Matteo Asteggiano
Revision and Translation: Luigi Tagliavini
Project: Float - Ram
Shaft
