seromedises-PoliTo/Float-Ram-main/Technical_Drawings/ShaftAxialBlock.pdf

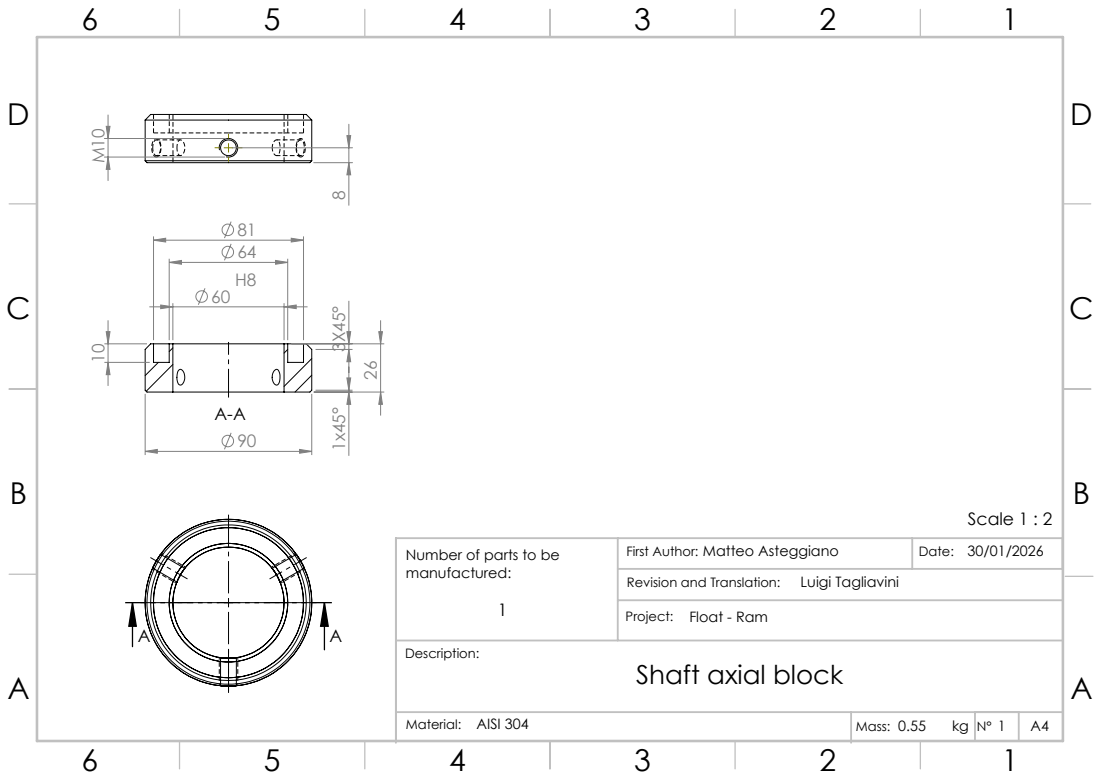
[picture p117: page 1]
Material: AISI 304; Mass: 0.55; Scale 1 : 2

Number of parts to be
manufactured:

First Author: Matteo Asteggiano
Revision and Translation: Luigi Tagliavini
Project: Float - Ram
Shaft axial block
