seromedises-PoliTo/Float-Ram-main/Technical_Drawings/SpringWasher.pdf

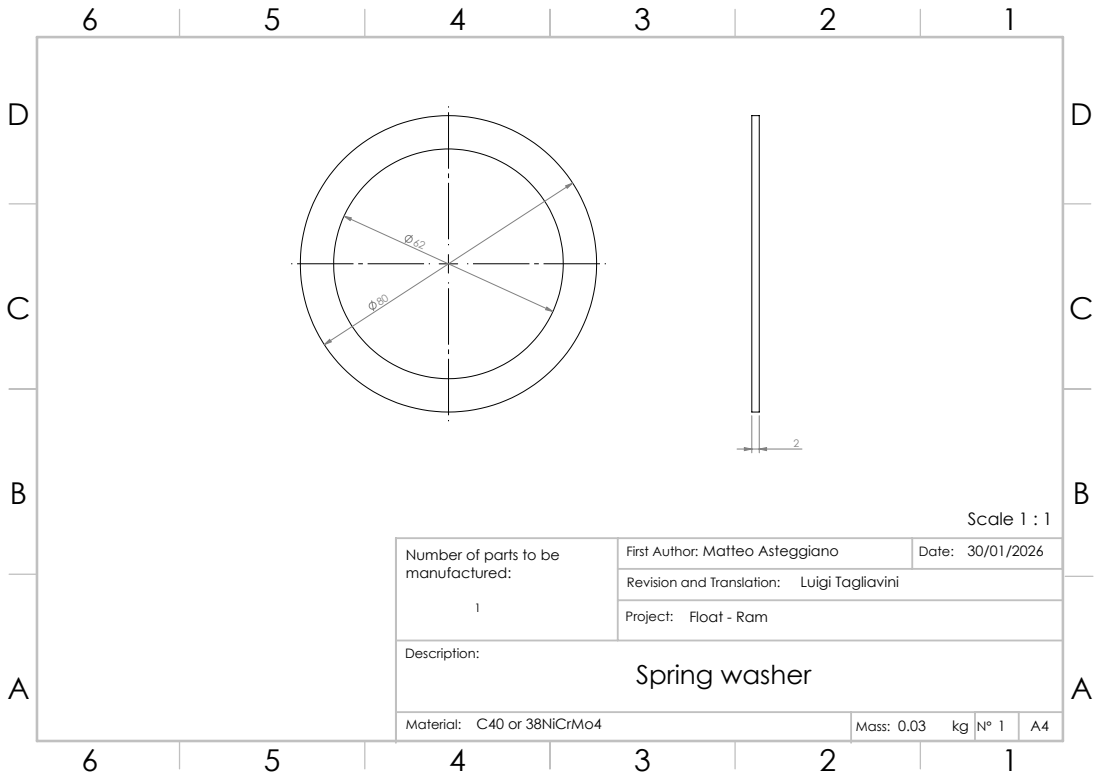
[picture p118: page 1]
Material: C40 or 38NiCrMo4; Mass: 0.03; Scale 1 : 1

Number of parts to be
manufactured:

First Author: Matteo Asteggiano
Revision and Translation: Luigi Tagliavini
Project: Float - Ram
Spring washer
