seromedises-PoliTo/Float-Ram-main/Technical_Drawings/WheelAxis.pdf

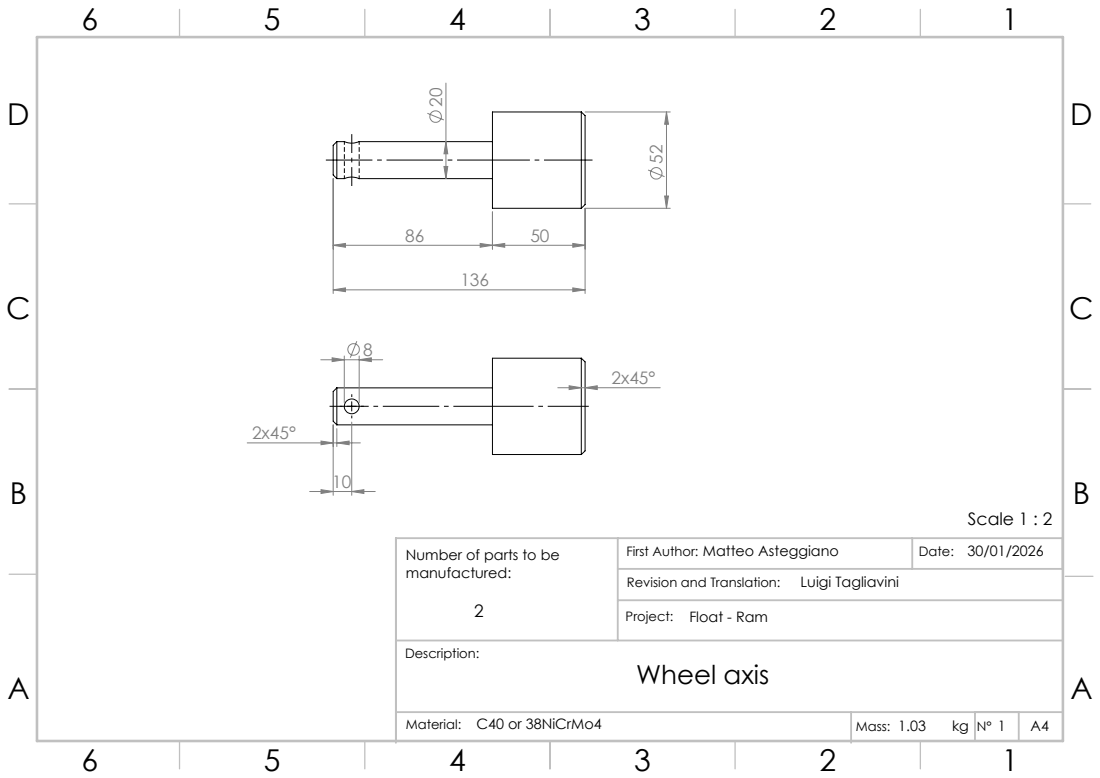
[picture p119: page 1]
Material: C40 or 38NiCrMo4; Mass: 1.03; Scale 1 : 2

Number of parts to be
manufactured:

First Author: Matteo Asteggiano
Revision and Translation: Luigi Tagliavini
Project: Float - Ram
Wheel axis
